dcarve/tg-robot/README.md

# Links potencialmente úteis

## Papers
 - [Design and implementation Raspberry Pi-based omni-wheel mobile robot](https://www.researchgate.net/publication/304291895_Design_and_implementation_Raspberry_Pi-based_omni-wheel_mobile_robot)

- [Dynamical Models for Omni-directional Robots with 3 and 4 Wheels](https://www.researchgate.net/publication/256089847_Dynamical_Models_for_Omni-directional_Robots_with_3_and_4_Wheels)

- [DESIGN OF AN OMNIDIRECTIONAL ROBOT FOR FIRA ROBOSOT](https://www.researchgate.net/publication/264841048_DESIGN_OF_AN_OMNIDIRECTIONAL_ROBOT_FOR_FIRA_ROBOSOT)

- [A motion control method for omni-directional mobile robots based on anisotropy](https://robolab.sjtu.edu.cn/kindeditor/Upload/file/20170830/20170830143750_1858.pdf)

- [A Nonlinear programming method for time-optimal control of an omni-directional mobile robot](http://libwri.nhu.edu.tw:8081/Ejournal/AI01002305.pdf)

- [Dynamic control model of a cobot with three omni-wheels](https://www-sciencedirect.ez42.periodicos.capes.gov.br/science/article/pii/S0736584510000736)

- [2D path control of four omni wheels mobile platform with compass and gyroscope sensors](https://pdf.sciencedirectassets.com/271352/1-s2.0-S0924424715X00136/1-s2.0-S0924424715301291/main.pdf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)

- [SIMPLIFIED CONTROLLER FOR A THREE WHEELED OMNI DIRECTIONAL MOBILE ROBOT](https://eds.p.ebscohost.com/eds/pdfviewer/pdfviewer?vid=0&sid=e32e85bf-04d3-4e8c-8876-cb36a72d98c3%40redis)

- [Modelagem Cinemática e Dinâmica](http://www.ece.ufrgs.br/~fetter/ele00070/mobrob/model.pdf)

- [Motion Planning for Omnidirectional Wheeled Mobile Robot by Potential Field Method](https://www.hindawi.com/journals/jat/2017/4961383/)

- [Motion Analysis of A Mobile Robot With Three Omni-Directional Wheels](https://ijiset.com/vol2/v2s11/IJISET_V2_I11_84.pdf)

- [DYNAMICAL MODELS FOR OMNI-DIRECTIONAL ROBOTS WITH 3 AND 4 WHEELS](https://www.scitepress.org/Papers/2008/14892/14892.pdf)

- [Holonomic Implementation of Three Wheels Omnidirectional Mobile Robot using DC Motors](https://pdfs.semanticscholar.org/ed22/2105a1e4c42d64c207bcc55dec5aacd70275.pdf)

## Youtube
- [DC motor PID speed control](https://www.youtube.com/watch?v=HRaZLCBFVDE)

- [How to control a DC motor with an encoder](https://www.youtube.com/watch?v=dTGITLnYAY0)
  
- [How to control multiple DC motors with encoders](https://www.youtube.com/watch?v=3ozgxPi_tl0)

## Artigo internet

- [Motor DC com Driver Ponte H L298N](https://www.filipeflop.com/blog/motor-dc-arduino-ponte-h-l298n/)
  
- [Como usar motor DC com encoder no Arduino](https://www.arduinoecia.com.br/motor-dc-com-encoder-arduino/)

## Componentes

- [Motor DC 6V com Encoder](https://www.filipeflop.com/produto/motor-dc-6v-com-encoder/)
  
- [Driver Motor Ponte H L298n](https://www.filipeflop.com/produto/driver-motor-ponte-h-l298n/)

- [STM32F103C8](https://stm32-base.org/boards/STM32F103C8T6-Blue-Pill.html)

## Recomenrações de TG e Documentação Latex ABNT

- [Estilos bibliográficos compatíveis com a ABNT NBR 6023](https://linorg.usp.br/CTAN/macros/latex/contrib/abntex2/doc/abntex2cite.pdf)
- [Github exemplo latex abnt](https://github.com/abntex/abntex2/blob/master/doc/latex/abntex2/examples/abntex2-modelo-trabalho-academico.tex)
- [Documentos técnicos e científicos brasileiros compatíveis com as normas ABNT](https://linorg.usp.br/CTAN/macros/latex/contrib/abntex2/doc/abntex2.pdf)
- [RECOMENDAÇÕES PARA ELABORAÇÃO DA MONOGRAFIA DO TRABALHO DE GRADUAÇÃO (TG)](https://i0.statig.com.br/educacao/trabalhosacademicos/Recomendacoes_elaboracao_monografia.pdf)
- [Como fazer uma revisão sistemática de literatura?](https://blog.mettzer.com/revisao-sistematica/)

file:///C:/Users/daniel%20carvalho/Desktop/2018-Jeba-2.pdf

## patents

https://worldwide.espacenet.com/patent/search/family/003373065/publication/US1305535A?q=pn%3DUS1305535

https://worldwide.espacenet.com/patent/search/family/022923089/publication/US3789947A?q=pn%3DUS3789947

https://www.embarcados.com.br/introducao-ao-microcontrolador-arm-cortex-m3/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

https://www.vexrobotics.com/omni-wheels.html#attr-vex_drawings

https://he.aliexpress.com/item/32842600463.html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

https://he.aliexpress.com/item/32825873010.html?gatewayAdapt=glo2isr

https://www.alibaba.com/product-detail/Chihai-Motor-CHR-GM25-370-ABHL_62101113849.html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

https://www.banggood.com/pt/CHIHAI-MOTOR-6V-210RPM-Encoder-Motor-DC-Gear-Motor-with-Mounting-Bracket-and-Wheel-p-1044064.html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

https://www.youtube.com/watch?v=jTIRUXJKMX4

https://www.banggood.com/pt/CHIHAI-MOTOR-6V-210RPM-Encoder-Motor-DC-Gear-Motor-with-Mounting-Bracket-and-Wheel-p-1044064.html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

https://howtomechatronics.com/tutorials/arduino/arduino-dc-motor-control-tutorial-l298n-pwm-h-bridge/

http://www.ijsrp.org/research-paper-1118/ijsrp-p8321.pdfqq

https://www.rugged-circuits.com/the-motor-driver-myth

https://manuals.plus/bluetooth-module/bluetooth-jdy-18-4-2-ble-module-usage-manual#axzz7SX8YVBt9

https://www.ti.com/lit/ds/symlink/drv8825.pdf

https://capsistema.com.br/index.php/2022/05/31/como-controlar-um-motor-de-passo-com-driver-drv8825-e-arduino/	

https://www.crescerengenharia.com/post/tudo-sobre-drv8825

https://www.valuekart.in/motors/835-chihai-motor-gm25-370-dc-gear-motor-6v-100-210-300rpm-encoder-motor.html
https://github.com/markjay4k/Audio-Spectrum-Analyzer-in-Python
https://github.com/curiores/ArduinoTutorials

https://github.com/RobTillaart/DRV8825
https://www.youtube.com/watch?v=zOByx3Izf5U

https://www.crescerengenharia.com/post/tudo-sobre-drv8825
