dcarve/tg-robot/latex_doc/TGIII/main.tex

% !TeX root = ..\TGIII\main.tex
\input{config/config_class.tex}

% Início do documento
\begin{document}

\include{abntex2-modelo-include-comandos}

% Seleciona o idioma do documento (conforme pacotes do babel)
\selectlanguage{brazil}

% Retira espaço extra obsoleto entre as frases.
\frenchspacing 

% ELEMENTOS PRÉ-TEXTUAIS

	% Capa
	\imprimircapa

	% Folha de rosto
	% (o * indica que haverá a ficha bibliográfica)
	\imprimirfolhaderosto*

	% inserir lista de ilustrações
	\pdfbookmark[0]{\listfigurename}{lof}
	\listoffigures*
	\cleardoublepage

	% inserir lista de tabelas
	\pdfbookmark[0]{\listtablename}{lot}
	\listoftables*
	\cleardoublepage

	% inserir lista de abreviaturas e siglas

	\begin{siglas}
		\item[ADC] Analog to Digital Converter
		\item[DAC] Digital to Analog converter
		\item[I2C] Inter-Integrated Circuit
		\item[USART] Universal Synchronous Asynchronous Receiver Transmitter
		\item[UART] Universal Asynchronous Receiver Transmitter
		\item[I2S] Integrated Inter-IC Sound
		\item[PWM] Pulse Width Modulation
		\item[SPI] Serial Peripheral Interface
		\item[USB 2.0] Universal Serial Bus 2.0
		\item[ESP32] Após a subseção \ref{ESP32_referencia}, refere-re à placa ESP32 Devkit v1
		\item[STM32] Após a subseção \ref{STM32_referencia}, refere-re à placa BluePill
		\item[IDE] Integrated Development Environment
	\end{siglas}

	% inserir o sumario
	\pdfbookmark[0]{\contentsname}{toc}
	\tableofcontents*
	\cleardoublepage

% ELEMENTOS TEXTUAIS
\textual

	\input{chapters/introducao.tex}

	\input{chapters/objetivos.tex}

	\input{chapters/metodologia.tex}
	
	\input{chapters/resultados_e_discussao.tex}

	\phantompart

% ELEMENTOS PÓS-TEXTUAIS
\postextual

	% Referências bibliográficas

	\input{apendices/apendices_class.tex}
	
	\bibliography{bibliography/bibliografia.bib}
	%\printbibliography

	% Glossário
	%\input{glossary/glossary_class.tex}

	% Apêndices

	% Anexos
	% \begin{anexosenv}
	% \partanexos
	% \input{attachments/medicoes_motores.tex}
	% \end{anexosenv}

%---------------------------------------------------------------------
% INDICE REMISSIVO
%---------------------------------------------------------------------
\phantompart
\printindex

\end{document}
