dcarve/tg-robot/latex_doc/TGII/main.tex

\input{config/config_class.tex}

% Início do documento
\begin{document}

% Seleciona o idioma do documento (conforme pacotes do babel)
%\selectlanguage{english}
\selectlanguage{brazil}

% Retira espaço extra obsoleto entre as frases.
\frenchspacing 

% ELEMENTOS PRÉ-TEXTUAIS
	\input{pre_textual/pretextual_class.tex}

% ELEMENTOS TEXTUAIS
\textual

	% Introdução (exemplo de capítulo sem numeração, mas presente no Sumário)
	\chapter{Introdução}

	\input{chapters/cap_1_introduction.tex}

	% Capitulo com exemplos de comandos inseridos de arquivo externo 
	\include{abntex2-modelo-include-comandos}
	
	\input{chapters/cap_2_objetivos.tex}

	\input{chapters/cap_3_revisao_bibliografica.tex}

	\input{chapters/cap_4_metodologia.tex}
	
	\input{chapters/cap_5_desenvolvimento.tex}

	\input{chapters/cap_6_proximos_etapas.tex}

	% ----------------------------------------------------------
	% Finaliza a parte no bookmark do PDF
	% para que se inicie o bookmark na raiz
	% e adiciona espaço de parte no Sumário
	% ----------------------------------------------------------
	\phantompart

	% Conclusão
	%\input{chapters/conclusion.tex}

% ELEMENTOS PÓS-TEXTUAIS
\postextual

	% Referências bibliográficas
	% \input{bibliography/bibliography.tex}
	\bibliography{bibliography/bibliografia.bib}
	%\printbibliography

	% Glossário
	%\input{glossary/glossary_class.tex}

	% Apêndices
	%\input{apendices/apendices_class.tex}

	% Anexos
	\begin{anexosenv}
	\partanexos
	\input{attachments/medicoes_motores.tex}
	\input{attachments/filtro_passa_baixa_deducao.tex}
	\input{attachments/fabricacao.tex}
	\input{attachments/limpeza_dados_python.tex}
	\input{attachments/matlab_polymonio.tex}
	\end{anexosenv}

%---------------------------------------------------------------------
% INDICE REMISSIVO
%---------------------------------------------------------------------
\phantompart
\printindex

\end{document}
