dcarve/tg-robot/latex_doc/TGIII/chapters/metodologia.tex

\chapter{Metodologia}

\input{chapters/metodologia/algoritimo_movimento.tex}
\input{chapters/metodologia/roda_omni_directiona.tex}
\input{chapters/metodologia/microcontrolador.tex}
\input{chapters/metodologia/comunicacao.tex}
\input{chapters/metodologia/motores.tex}
\input{chapters/metodologia/drivers.tex}
\input{chapters/metodologia/alimentacao.tex}
\input{chapters/metodologia/fabricacao.tex}
\input{chapters/metodologia/seguranca.tex}
