dcarve/tg-robot/latex_doc/TGIII/chapters/objetivos.tex

\chapter{Objetivos}

\subsection*{Gerais}
Este trabalho tem como objetivos gerais avaliar a viabilidade da utilização de 
um robô omnidirecional de três rodas controlado por microcontrolador para 
atuação em ambiente interno.

\subsection*{Específicos}
Deseja-se realizar a construção de um robô a partir de diversos componentes 
(motor, microcontrolador, rodas, driver, chassi, entre outros), e também 
implementar rotina de controle remoto que permita a operação do robô a partir de 
comandos via smartphone.
