dcarve/tg-robot/latex_doc/TGII/chapters/cap_3_revisao_bibliografica.tex

\chapter{Revisão Bibliográfica}

\section{Veículo omnidirecional de 3 rodas}
\input{chapters/cap3_revisao_bibliografica/section_veiculo_omnidirecional.tex}

\section{Roda Omnidirecional}
\input{chapters/cap3_revisao_bibliografica/section_roda_omnidirecional.tex}

\section{Motor DC com encoder e driver para motor}
\input{chapters/cap3_revisao_bibliografica/section_motor_dc.tex}

\section{Microcontrolador STM32}
\input{chapters/cap3_revisao_bibliografica/section_microcontrolador.tex}

\section{IDE}
\input{chapters/cap3_revisao_bibliografica/section_atollic.tex}

\section{CAD - Design auxiliado por computador}
\input{chapters/cap3_revisao_bibliografica/section_cad.tex}

\section{Impressão 3D de filamento - Manufatura Aditiva}
\input{chapters/cap3_revisao_bibliografica/section_3d_impression.tex}
