dcarve/tg-robot/latex_doc/TGII/attachments/medicoes_motores.tex

\chapter{Medição de velocidade dos motores}
\label{att_medicao_motores}

\begin{figure}[ht]
	\centering
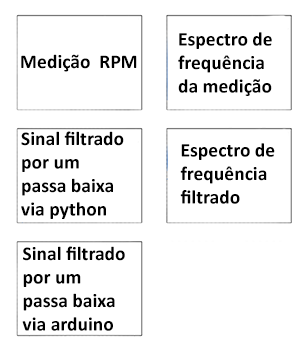
[picture p13: latex_doc/TGIII/figures/explicacao_quadros.png]
	
	\caption{Explicação de cada quadro nas figuras a seguir}
	\label{fig:explicacao_quadros}
\end{figure}

\begin{figure}[ht]
	\centering
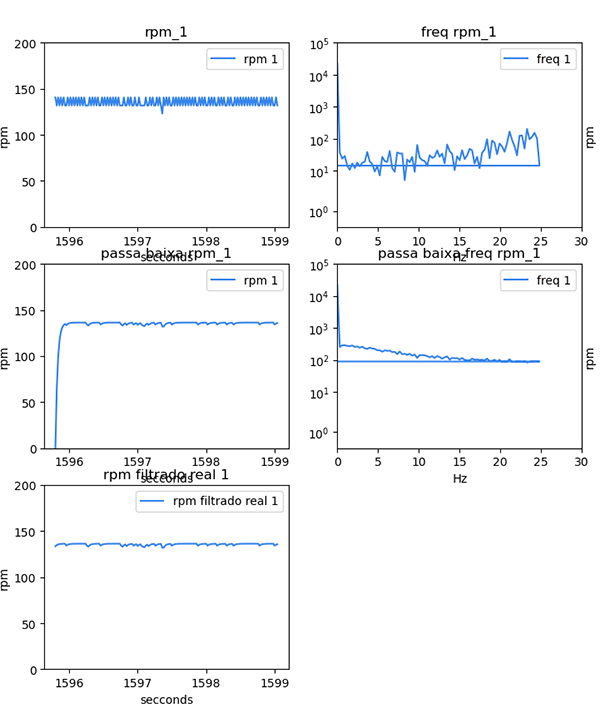
[picture p14: latex_doc/TGII/figures/medidas_motor_1.png]
	
	\caption{Medidas Motor 1}
	\label{fig:medidas_motor_1}
\end{figure}

\begin{figure}[ht]
	\centering
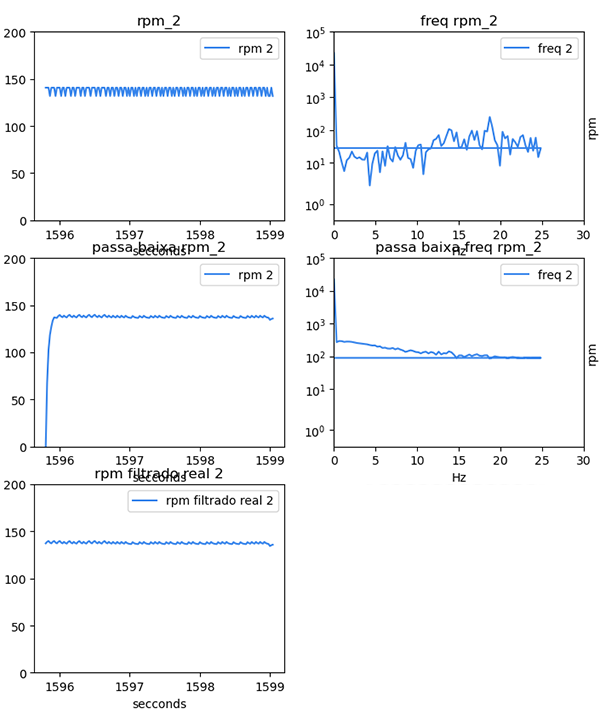
[picture p15: latex_doc/TGII/figures/medidas_motor_2.png]
	
	\caption{Medidas Motor 2}
	\label{fig:medidas_motor_2}
\end{figure}

\begin{figure}[ht]
	\centering
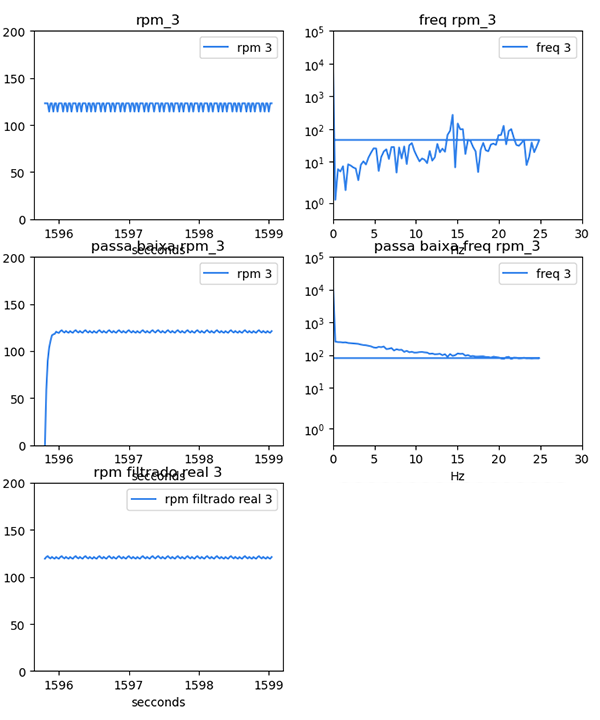
[picture p16: latex_doc/TGII/figures/medidas_motor_3.png]
	
	\caption{Medidas Motor 3}
	\label{fig:medidas_motor_3}
\end{figure}
