dcarve/tg-robot/latex_doc/TGII/attachments/matlab_polymonio.tex

\chapter{Limpeza dos dados realizada no python}
\label{att_matlab}

Matlab
\lstset{language=Matlab}
\begin{lstlisting}
    T = readtable('amostra_invertida.csv');
    filter_rpm_mean =  T{:,1};
    w =  T{:,2};
    f=fit(filter_rpm_mean,w,'poly4')

    f = 
    
         Linear model Poly4:
         f(x) = p1*x^4 + p2*x^3 + p3*x^2 + p4*x + p5
         Coefficients (with 0.95 confidence bounds):
           p1 =   0.0001131  (9.732e-05, 0.0001288)
           p2 =    -0.03064  (-0.0375, -0.02377)
           p3 =       2.993  (1.999, 3.988)
           p4 =      -1.257  (-54.15, 51.63)
           p5 =        9017  (8235, 9798)

\end{lstlisting}
