dcarve/tg-robot/latex_doc/TGI/chapters/cap_2_objetivos.tex

\chapter{Objetivos}

\subsection*{Gerais}
Este trabalho tem como objetivos gerais avaliar a viabilidade da utilização de 
um robô omnidirecional de três rodas controlado por microcontrolador para 
atuação independente em ambiente interno.

\subsection*{Específicos}
Deseja-se realizar a construção de um robô a partir de diversos componentes 
(motor, microcontrolador, rodas, driver, chassi, entre outros), e também 
implementar rotina de controle que permita ao robô receber como entrada mapa
do ambiente em que se encontra, de modo que seja capaz de nele se mover de 
acordo com as rotinas desejadas.
