dcarve/tg-robot/latex_doc/TGI/attachments/attachments_class.tex

\begin{anexosenv}

% Imprime uma página indicando o início dos anexos
\partanexos

%\input{attachments/deducao_calculo.tex}
\input{attachments/outro_anexo.tex}

\end{anexosenv}
