dcarve/tg-robot/3_whell_robot/doc/chapters/capitulo_2.tex

\section{Componentes}

\begin{quadro}[htb]
\caption{\label{lista de componentes}Componentes}
 \begin{tabular}{|c|c|c|c|}
	\hline
	\textbf{Componente} & \textbf{Quant} \\ \hline
	Motor DC 6V,  210 RPM, encoder integrado & 3  \\ \hline
	Driver Motor Ponte H L298n  & 3  \\ \hline
	Raspberry Pi 4    & 1   \\ \hline
	STM32 F103C8T6 & 2     \\ \hline
	Bateria & 1     \\ \hline
\end{tabular}
\fonte{Autor.}
\end{quadro}

%https://www.filipeflop.com/produto/driver-motor-ponte-h-l298n/
%https://www.filipeflop.com/produto/motor-dc-6v-com-encoder/?attribute_pa_rpm=210-rpm#tab-description
