dcarve/tg-robot/latex_doc/TGIII/chapters/metodologia/motores.tex

\section{Motores}  \label{secao_motores}

\lipsum[1]
