dcarve/tg-robot/latex_doc/TGI/chapters/cap3_revisao_bibliografica/section_microcontrolador.tex

STM32 é uma família de microcontroladores de 32-bits fabricados
pela STMicroelectronics. Possuem como porcessadores o ARM Cortex, baseados em arquitetura Harvard, de 32-bits. 
os microcontroladores STM32 fornece base para uma uma grande variedades de
sistemas embarcados, e com custo inferior e maior flexibilidade quando comparado
ao Arduino com ATmega, que possui microcontroladores de 8 a 16bits. Contudo,
essa flexibilidade e baixo custo têm como contrapartida o requerimento de um
maior nível de experiência em programação C do que o necessário para
desenvolver as mesmas soluções em Arduino (cuja concepção teve como objetivo
maior acessibilidade para iniciantes \cite{cortex_m3}).
