dcarve/tg-robot/latex_doc/TGIII/config/config_class.tex

\documentclass[
	% -- opções da classe memoir --
	12pt,				% tamanho da fonte
	openright,			% capítulos começam em pág ímpar (insere página vazia caso preciso)
	oneside,			% para impressão em recto e verso. Oposto a oneside
	a4paper,			% tamanho do papel. 
	% -- opções da classe abntex2 --
	%chapter=TITLE,		% títulos de capítulos convertidos em letras maiúsculas
	%section=TITLE,		% títulos de seções convertidos em letras maiúsculas
	%subsection=TITLE,	% títulos de subseções convertidos em letras maiúsculas
	%subsubsection=TITLE,% títulos de subsubseções convertidos em letras maiúsculas
	% -- opções do pacote babel --
	english,			% idioma adicional para hifenização
	french,				% idioma adicional para hifenização
	spanish,			% idioma adicional para hifenização
	brazil				% o último idioma é o principal do documento
	]{abntex2}

% Pacotes básicos 
\usepackage{lmodern}			% Usa a fonte Latin Modern			
\usepackage[T1]{fontenc}		% Selecao de codigos de fonte.
\usepackage[utf8]{inputenc}		% Codificacao do documento (conversão automática dos acentos)
\usepackage{indentfirst}		% Indenta o primeiro parágrafo de cada seção.
\usepackage{color}				% Controle das cores
\usepackage{graphicx}			% Inclusão de gráficos
\usepackage{microtype} 			% para melhorias de justificação
\usepackage{amsmath}			% lib para equacoes
\usepackage{svg}
%\usepackage{float}
\usepackage[T1]{fontenc}
\usepackage{listings}
\usepackage{textcomp}
\usepackage{tikz}
\usepackage{caption}
\usepackage{url}

\usepackage{titlesec}
\newcommand{\sectionbreak}{\clearpage}
\usepackage{hyperref}

\usetikzlibrary{shapes.geometric, arrows}

\tikzstyle{startstop} = [rectangle, rounded corners, 
minimum width=3cm, 
minimum height=1cm,
text centered, 
draw=black, 
fill=red!30]

\tikzstyle{io} = [trapezium, 
trapezium stretches=true, % A later addition
trapezium left angle=70, 
trapezium right angle=110, 
minimum width=3cm, 
minimum height=1cm, text centered, 
draw=black, fill=blue!30]

\tikzstyle{process} = [rectangle, 
minimum width=3cm, 
minimum height=1cm, 
text centered, 
text width=3cm, 
draw=black, 
fill=orange!30]

\tikzstyle{decision} = [diamond, 
minimum width=3cm, 
minimum height=1cm, 
text centered, 
draw=black, 
fill=green!30]
\tikzstyle{arrow} = [thick,->,>=stealth]

\definecolor{dkgreen}{rgb}{0,0.6,0}
\definecolor{gray}{rgb}{0.5,0.5,0.5}
\definecolor{mauve}{rgb}{0.58,0,0.82}

\lstset{frame=tb,
  language=Python,
  aboveskip=3mm,
  belowskip=3mm,
  showstringspaces=false,
  columns=flexible,
  basicstyle={\small\ttfamily},
  numbers=none,
  numberstyle=\tiny\color{gray},
  keywordstyle=\color{blue},
  commentstyle=\color{dkgreen},
  stringstyle=\color{mauve},
  breaklines=false,
  breakatwhitespace=false,
  upquote=true,
  tabsize=3
}

% Pacotes adicionais, usados apenas no âmbito do Modelo Canônico do abnteX2

\usepackage{lipsum}				% para geração de dummy text

% Pacotes de citações
\usepackage[alf, backend=biblatex]{abntex2cite}	% Citações padrão ABNT
\usepackage[brazilian,hyperpageref]{backref}	 % Paginas com as citações na bibl

% ---
% Informações de dados para CAPA e FOLHA DE ROSTO
% ---
\titulo{Robô omnidirecional de 3 rodas}
\autor{Daniel Ermelino Carvalho \\ Lucas Pereira Lima}
\local{Brasil}
\data{2024}
\orientador{Marcelo Bender Perotoni}
\instituicao{%
  Universidade Federal do ABC
  \par
  CECS
  \par
   Engenharia de Instrumentação, Automação e Robótica}
\tipotrabalho{Trabalho de graduação}
% O preambulo deve conter o tipo do trabalho, o objetivo, 
% o nome da instituição e a área de concentração 
\preambulo{Trabalho apresentado ao curso de engenharia de instrumentação,
automação e robótica da Universidade Federal do ABC como requisito parcial para
obtenção do título de bacharel em Engenharia de Instrumentação, Automação e 
Robótica.}

% Configurações de aparência do PDF final

% alterando o aspecto da cor azul
\definecolor{blue}{RGB}{5,5,180}

% informações do PDF
\makeatletter
\hypersetup{
     	%pagebackref=true,
		pdftitle={\@title}, 
		pdfauthor={\@author},
    	pdfsubject={\imprimirpreambulo},
	    pdfcreator={LaTeX with abnTeX2},
		pdfkeywords={abnt}{latex}{abntex}{abntex2}{trabalho acadêmico}, 
		colorlinks=true,       		% false: boxed links; true: colored links
    	linkcolor=blue,          	% color of internal links
    	citecolor=blue,        		% color of links to bibliography
    	filecolor=magenta,      		% color of file links
		urlcolor=blue,
		bookmarksdepth=4
}
\makeatother

% Posiciona figuras e tabelas no topo da página quando adicionadas sozinhas
% em um página em branco. Ver https://github.com/abntex/abntex2/issues/170
\makeatletter
\setlength{\@fptop}{5pt} % Set distance from top of page to first float
\makeatother

% Possibilita criação de Quadros e Lista de quadros.
% Ver https://github.com/abntex/abntex2/issues/176

\newcommand{\quadroname}{Quadro}
\newcommand{\listofquadrosname}{Lista de quadros}

\newfloat[chapter]{quadro}{loq}{\quadroname}
\newlistof{listofquadros}{loq}{\listofquadrosname}
\newlistentry{quadro}{loq}{0}

% configurações para atender às regras da ABNT
\setfloatadjustment{quadro}{\centering}
\counterwithout{quadro}{chapter}
\renewcommand{\cftquadroname}{\quadroname\space} 
\renewcommand*{\cftquadroaftersnum}{\hfill--\hfill}

\setfloatlocations{quadro}{hbtp} % Ver https://github.com/abntex/abntex2/issues/176

% Espaçamentos entre linhas e parágrafos 

% O tamanho do parágrafo é dado por:
\setlength{\parindent}{1.3cm}

% Controle do espaçamento entre um parágrafo e outro:
\setlength{\parskip}{0.2cm}  % tente também \onelineskip

% compila o indice
\makeindex

\makeatletter
% define a macro \autorefmany to allow multiple references to be passed to \autoref
\newcommand\autorefmany[1]{\@first@ref#1,@}
\def\@throw@dot#1.#2@{#1}% discard everything after the dot
\def\@set@refname#1{%    % set \@refname to autoefname+s using \getrefbykeydefault
    \edef\@tmp{\getrefbykeydefault{#1}{anchor}{}}%
    \xdef\@tmp{\expandafter\@throw@dot\@tmp.@}%
    \ltx@IfUndefined{\@tmp autorefnameplural}%
         {\def\@refname{\@nameuse{\@tmp autorefname}s}}%
         {\def\@refname{\@nameuse{\@tmp autorefnameplural}}}%
}
\def\@first@ref#1,#2{%
  \ifx#2@\autoref{#1}\let\@nextref\@gobble% only one ref, revert to normal \autoref
  \else%
    \@set@refname{#1}%  set \@refname to autoref name
    \@refname~\ref{#1}% add autoefname and first reference
    \let\@nextref\@next@ref% push processing to \@next@ref
  \fi%
  \@nextref#2%
}
\def\@next@ref#1,#2{%
   \ifx#2@ e~\ref{#1}\let\@nextref\@gobble% at end: print and+\ref and stop
   \else, \ref{#1}% print  ,+\ref and continue
   \fi%
   \@nextref#2%
}
\makeatother

% % CONFIGURAÇÕES DE PACOTES

% % Configurações do pacote backref
% % Usado sem a opção hyperpageref de backref
% \renewcommand{\backrefpagesname}{Citado na(s) página(s):~}
% % Texto padrão antes do número das páginas
% \renewcommand{\backref}{}
% % Define os textos da citação
% \renewcommand*{\backrefalt}[4]{
% 	\ifcase #1 %
% 		Nenhuma citação no texto.%
% 	\or
% 		Citado na página #2.%
% 	\else
% 		Citado #1 vezes nas páginas #2.%
% 	\fi}%
% % ---
