dcarve/tg-robot/latex_doc/TGI/pre_textual/pretextual_class.tex

% ---
% Capa
% ---
\imprimircapa
% ---

% ---
% Folha de rosto
% (o * indica que haverá a ficha bibliográfica)
% ---
\imprimirfolhaderosto
% ---

% ---
% inserir o sumario
% ---
\pdfbookmark[0]{\contentsname}{toc}
\tableofcontents*
\cleardoublepage
% ---
