dcarve/tg-robot/miscelania/stepper_motor_calc.docx

r=revolusão

1 step=1.8°

1 step=M μ_(step)

delay=delay em segundos

1r=360° (step)/(1.8°)=200 step=200 M μ_(step)

μ_(step) = 1/(2∙delay)
