dcarve/tg-robot/miscelania/ut.docx

u(t)=k_p e(t)+k_i ∫_0^t e(t)dt+ k_d (e(t))/(dt)

int_e (k)= int_e (k-1)+ (e(k)+e(k-1))/2 ∆t

dev_e (k)= (e(k)-e(k-1))/(∆t)
