dcarve/tg-robot/miscelania/calculo.docx

V_l = V_(w1) +V_(w2) +V_(w3)

ω= (|V_(w1) |)/L+(|V_(w2) |)/L+(|V_(w3) |)/L

V_l ∡A= V_(w1) ∡-π/2+V_(w2) ∡((2π)/3-π/2)+V_(w3) ∡((4π)/3-π/2)

V_(lx) +V_(ly) = V_(w1) cos(-π/2)+jV_(w1) sin(-π/2)+V_(w2) cos(π/6)+jV_(w2) sin(π/6)+V_(w3) cos((5π)/6)+jV_(w3) sin((5π)/6)

ω= (V_(w1))/L+(V_(w2))/L+(V_(w3))/L

[V_(lx) V_(ly) ω]= [cos(π/2), cos(π/6), cos((5π)/6)sin(π/2), sin(π/6), sin((5π)/6)1/L, 1/L, 1/L]∙[V_(w1) V_(w2) V_(w3) ]

[V_(lx) V_(ly) ω]=[0, (√3)/2, -(√3)/21, -1/2, -1/21/L, 1/L, 1/L]∙[V_(w1) V_(w2) V_(w3) ]

[0, √3/2, -√3/21, -1/2, -1/21/L, 1/L, 1/L] ∙ [a, b, cd, e, fg, h, i] = [1, 0, 00, 1, 00, 0, 1]

-√(3∙)d/2+√(3∙)g/2=1a -d/2-g/2=0a/L+ d/L+g/L=0, a=0, d=1/(√3), g=-1/√3

-√3∙e/2+√3∙h/2=0b -e/2-h/2=1b/L+ e/L+h/L=0, b=2/3, e=-1/3, h=-1/3

-√3∙f/2+√3∙i/2=0c-f/2-i/2=0c/L+ f/L+i/L=1, b=L/3, e=L/3, h=L/3

[a, b, cd, e, fg, h, i]= [0, 2/3, L/31/√3,, -1/3, L/3-1/√3,, -1/3, L/3]

[0, 2/3, L/3-1/√3,, -1/3, L/31/√3,, -1/3, L/3]∙ [V_(lx) V_(ly) ω]=[V_(w1) V_(w2) V_(w3) ]

[V_(w1) V_(w2) V_(w3) ]=[0, 2/3, L/3-1/√3,, -1/3, L/31/√3,, -1/3, L/3]∙ [V∙cos⁡(θ)V∙sin⁡(θ)ω]
