dcarve/tg-robot/cad_files/imagens/acoplamento-estudo-2.png

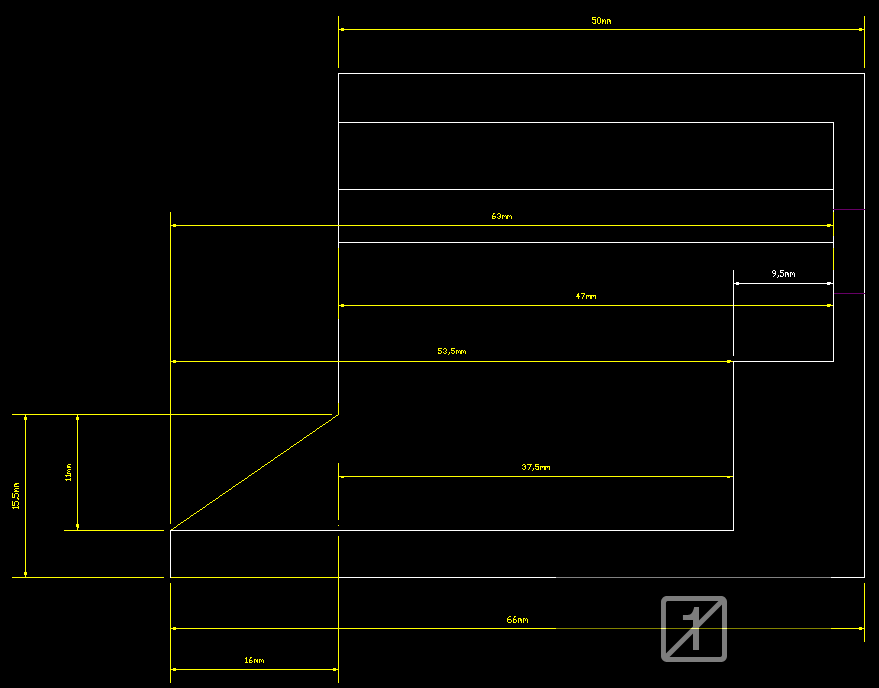
cad_files/imagens/acoplamento-estudo-2.png
