dcarve/tg-robot/cad_files/imagens/acoplamento-estudo.png

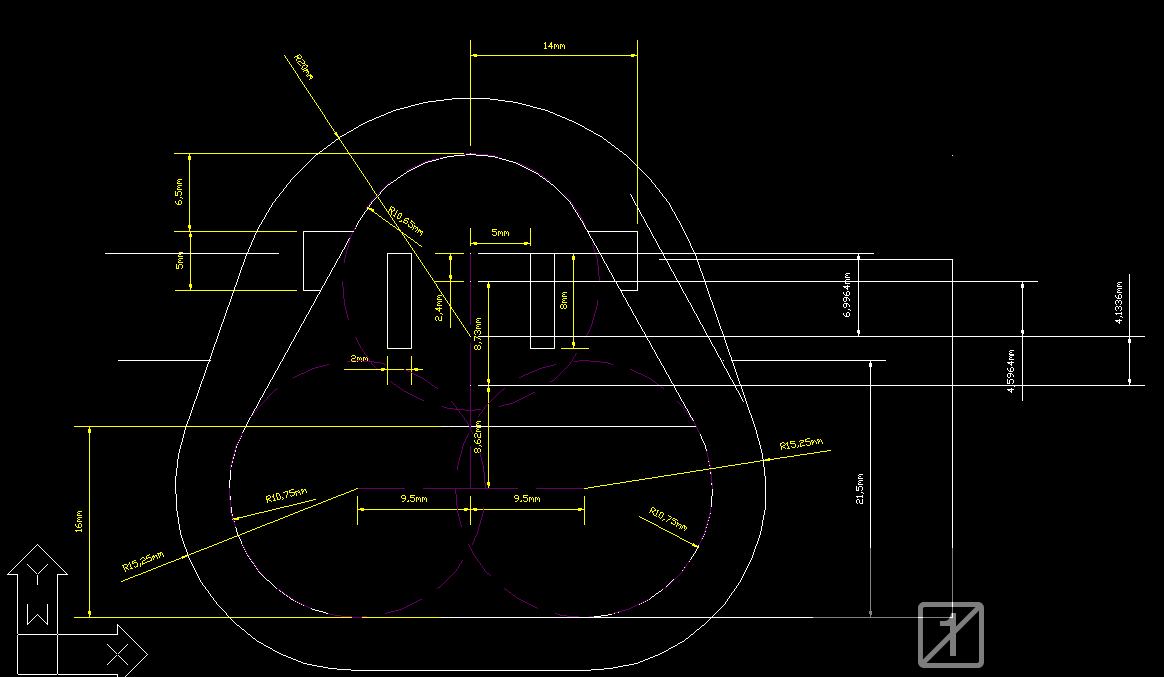
cad_files/imagens/acoplamento-estudo.png
