dcarve/tg-robot/cad_files/imagens/chassi1.png

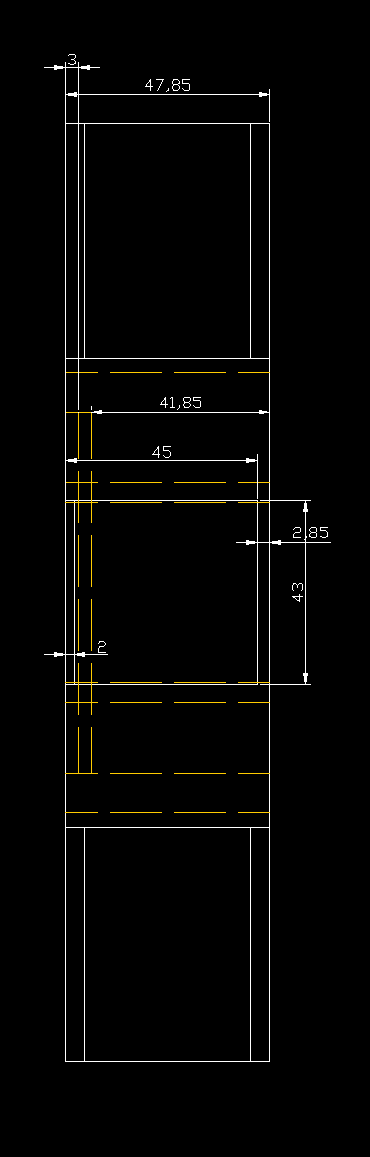
cad_files/imagens/chassi1.png
