dcarve/tg-robot/cad_files/imagens/chassi2.png

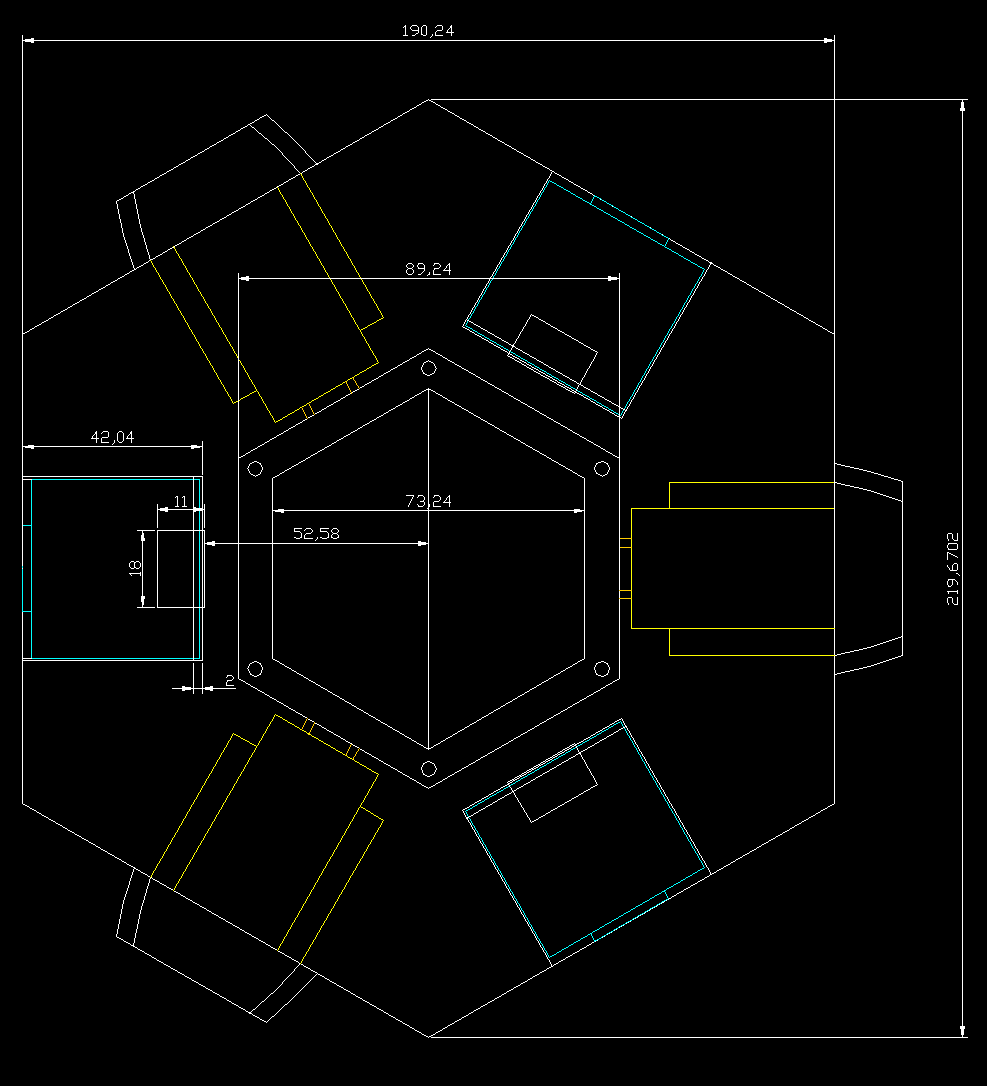
cad_files/imagens/chassi2.png
