dcarve/tg-robot/cad_files/imagens/chassi3.png

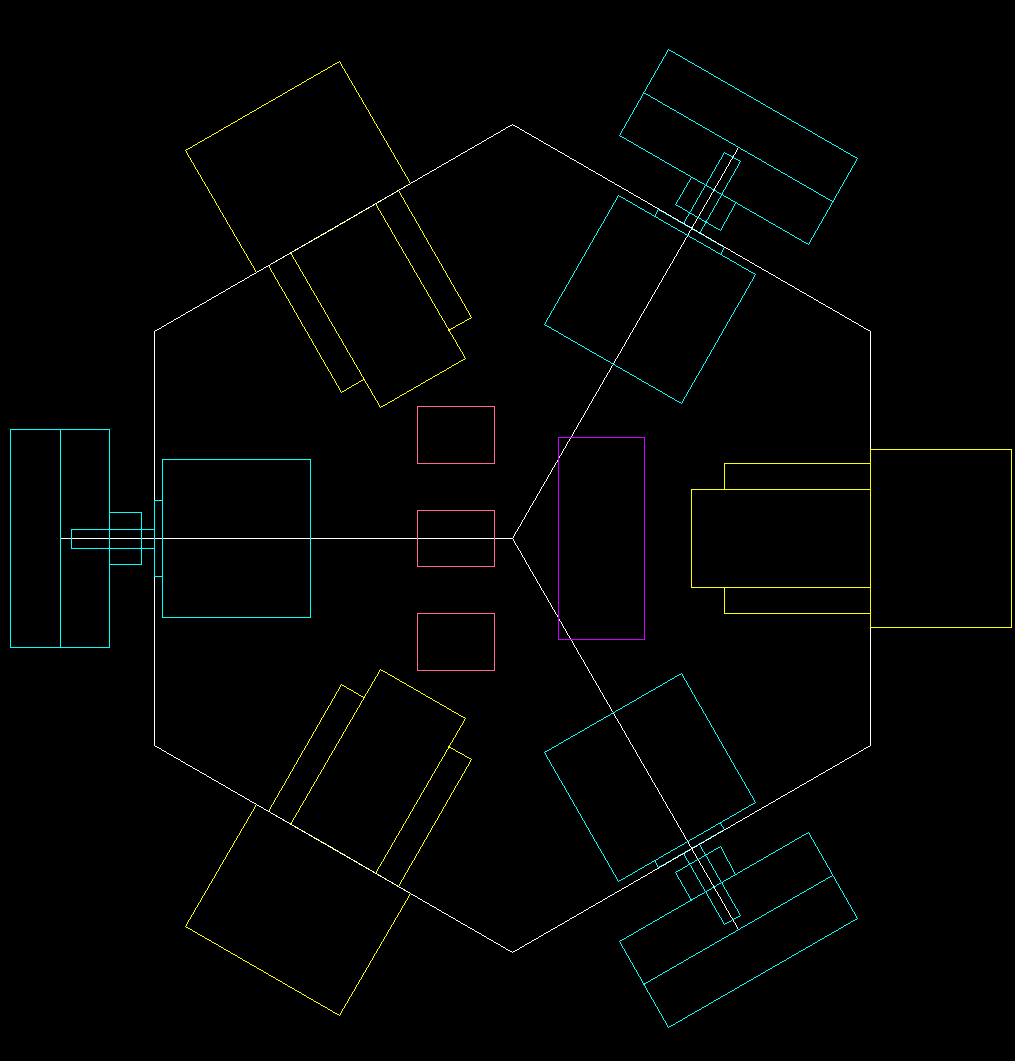
cad_files/imagens/chassi3.png
