dcarve/tg-robot/cad_files/imagens/roda1.png

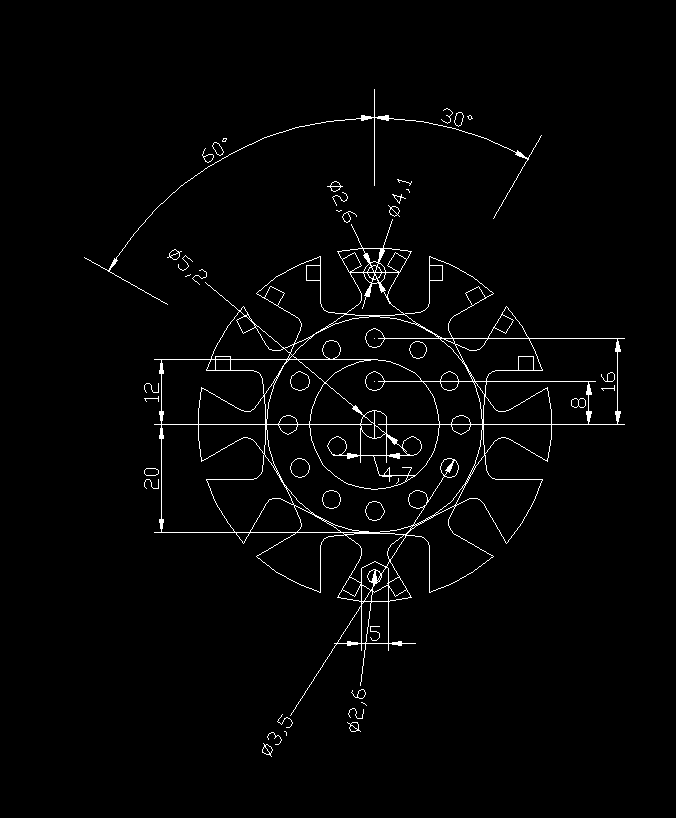
cad_files/imagens/roda1.png
