dcarve/tg-robot/cad_files/imagens/roda2.png

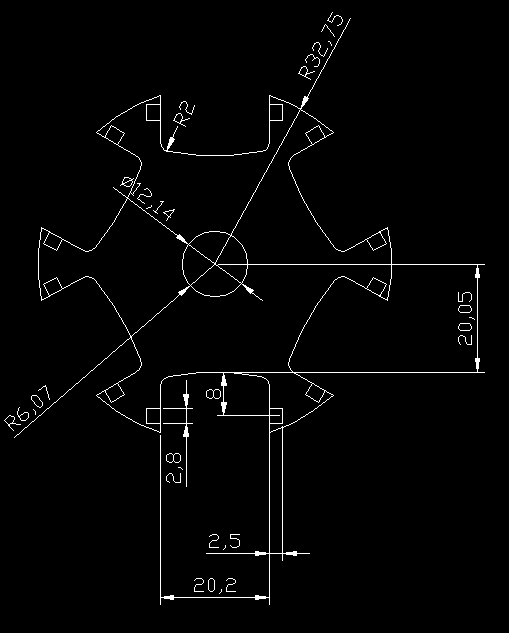
cad_files/imagens/roda2.png
