dcarve/tg-robot/cad_files/imagens/roda3.png

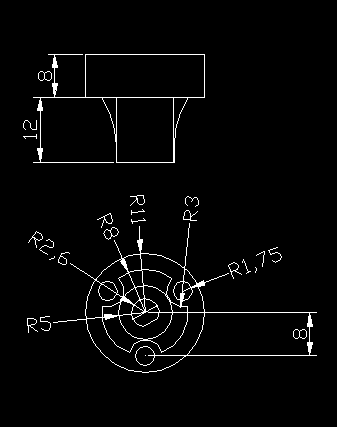
cad_files/imagens/roda3.png
