dcarve/tg-robot/latex_doc/TGI/figures/digram_model_dedution.png

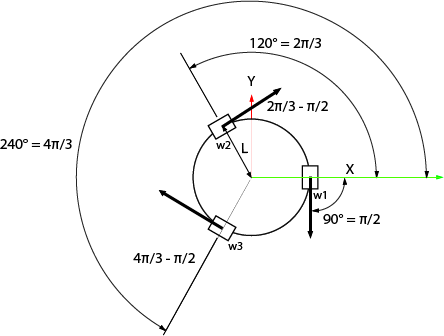
latex_doc/TGI/figures/digram_model_dedution.png
