dcarve/tg-robot/latex_doc/TGI/figures/encoder_holzer.jpg

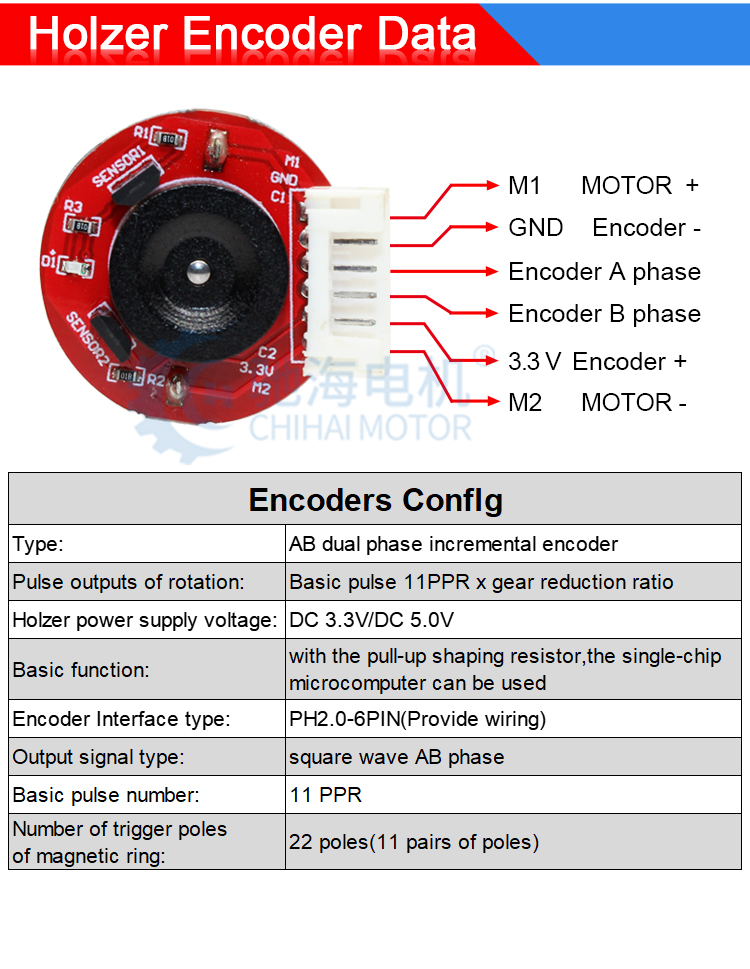
latex_doc/TGI/figures/encoder_holzer.jpg
