dcarve/tg-robot/latex_doc/TGI/figures/encoder_holzer.png

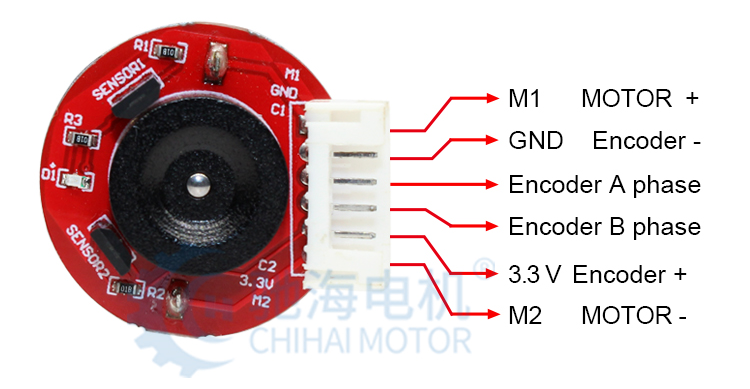
latex_doc/TGI/figures/encoder_holzer.png
