dcarve/tg-robot/latex_doc/TGI/figures/stm32f1_pinout.png

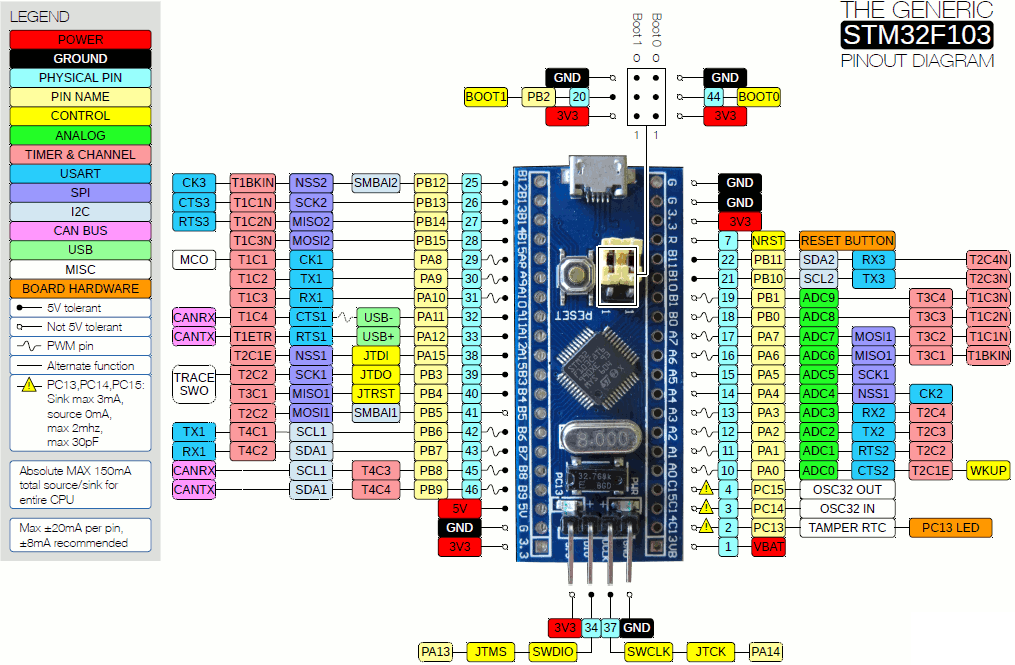
latex_doc/TGI/figures/stm32f1_pinout.png
