dcarve/tg-robot/latex_doc/TGII/figures/arduino.png

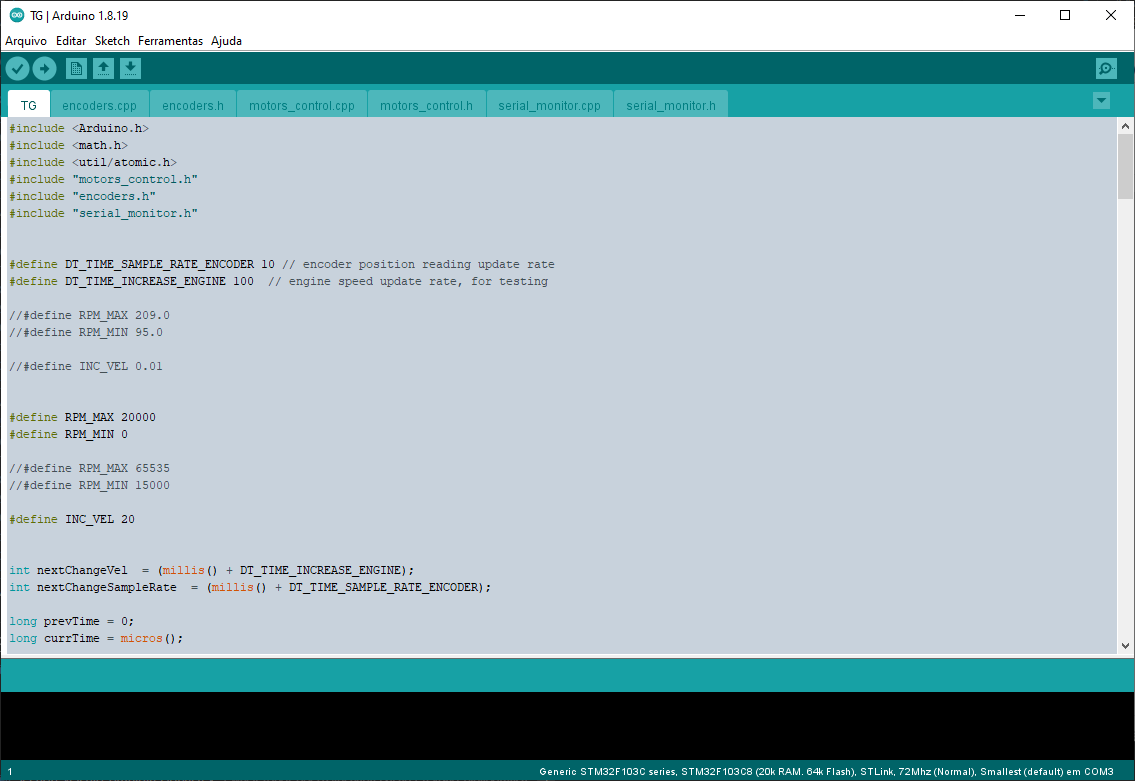
latex_doc/TGII/figures/arduino.png
