dcarve/tg-robot/latex_doc/TGII/figures/auto_cad.png

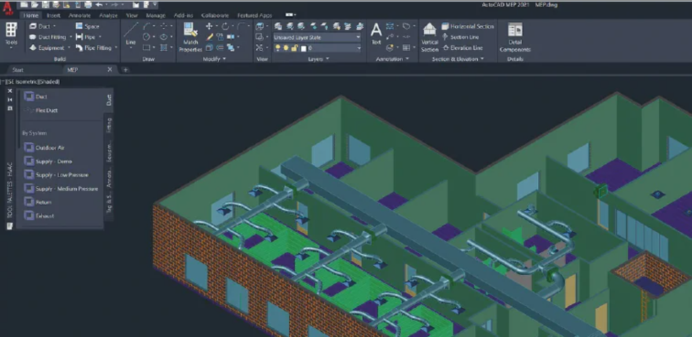
latex_doc/TGII/figures/auto_cad.png
