dcarve/tg-robot/latex_doc/TGII/figures/cad5.png

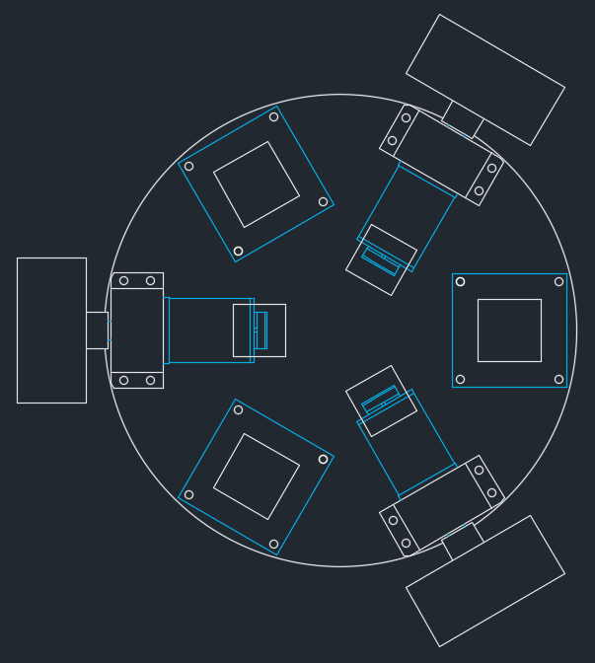
latex_doc/TGII/figures/cad5.png
