dcarve/tg-robot/latex_doc/TGII/figures/DRV8833-Dual-Driver-Pinout - Copia.png

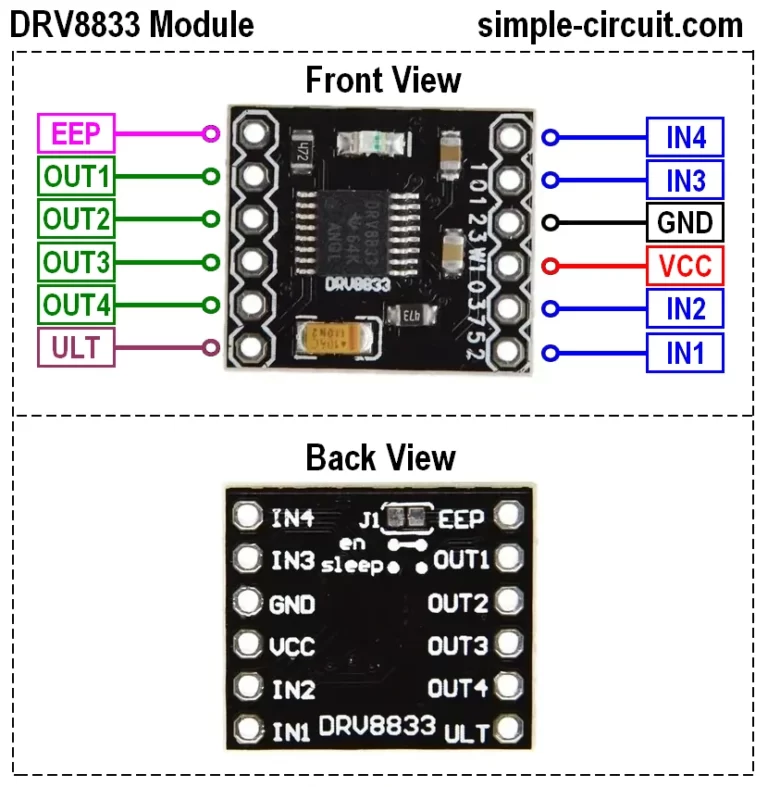
latex_doc/TGII/figures/DRV8833-Dual-Driver-Pinout - Copia.png
