dcarve/tg-robot/latex_doc/TGII/figures/frequencia_medidas_altas - Copia.png

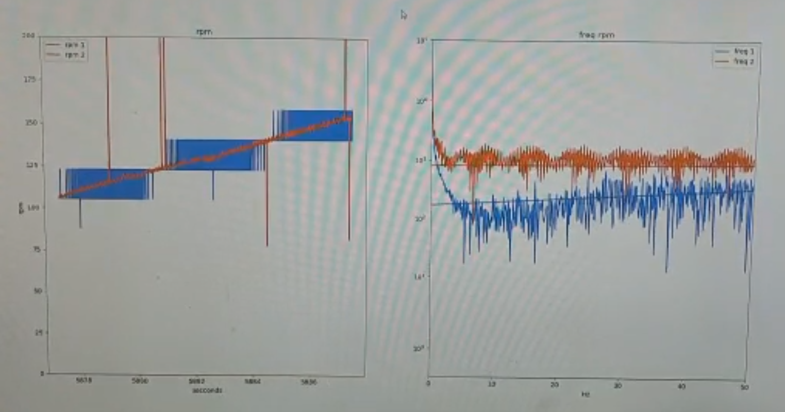
latex_doc/TGII/figures/frequencia_medidas_altas - Copia.png
