dcarve/tg-robot/latex_doc/TGII/figures/stm32f1_pinout - Copia - Copia.png

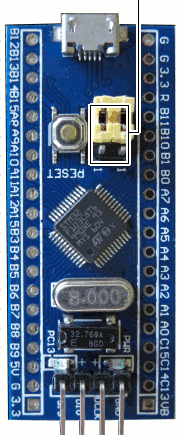
latex_doc/TGII/figures/stm32f1_pinout - Copia - Copia.png
