dcarve/tg-robot/latex_doc/TGII/figures/stm32f1_pinout.png

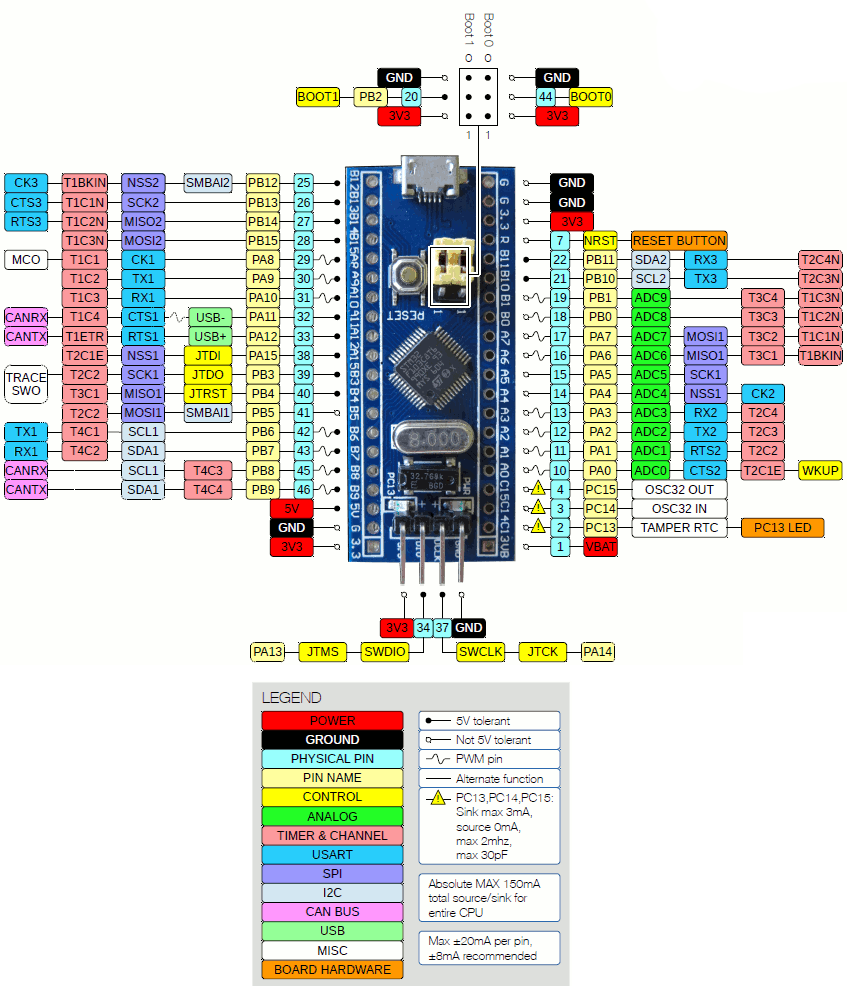
latex_doc/TGII/figures/stm32f1_pinout.png
