dcarve/tg-robot/latex_doc/TGIII/figures/20241014_223223.jpg

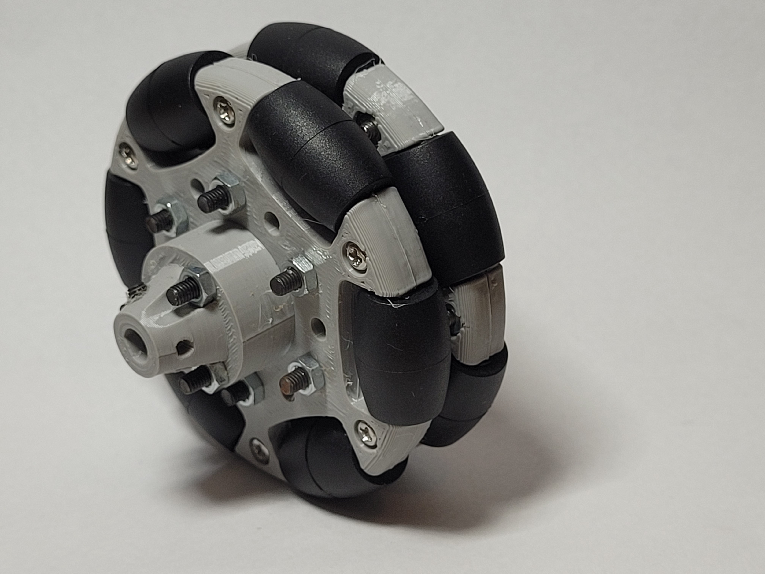
latex_doc/TGIII/figures/20241014_223223.jpg
