dcarve/tg-robot/latex_doc/TGIII/figures/app_andriod_hsl.png

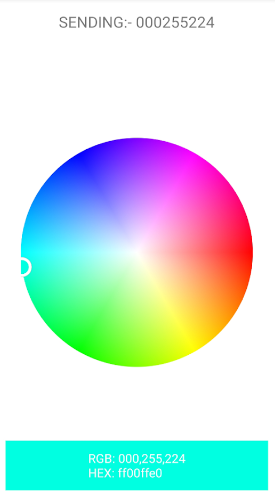
latex_doc/TGIII/figures/app_andriod_hsl.png
