dcarve/tg-robot/latex_doc/TGIII/figures/arduino.png

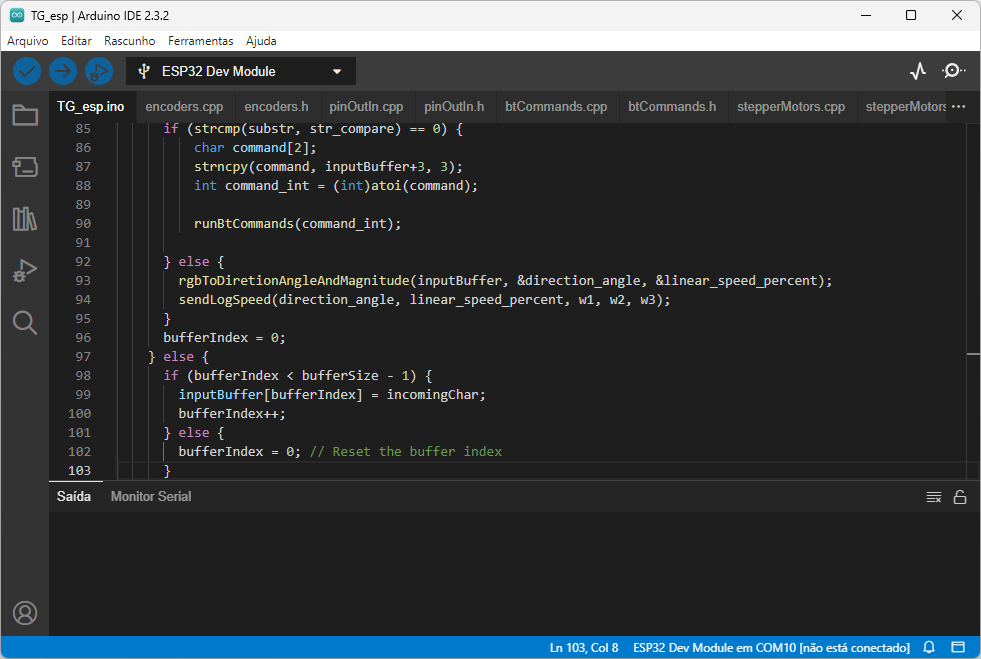
latex_doc/TGIII/figures/arduino.png
