dcarve/tg-robot/latex_doc/TGIII/figures/gba_bosch_embalagem.png

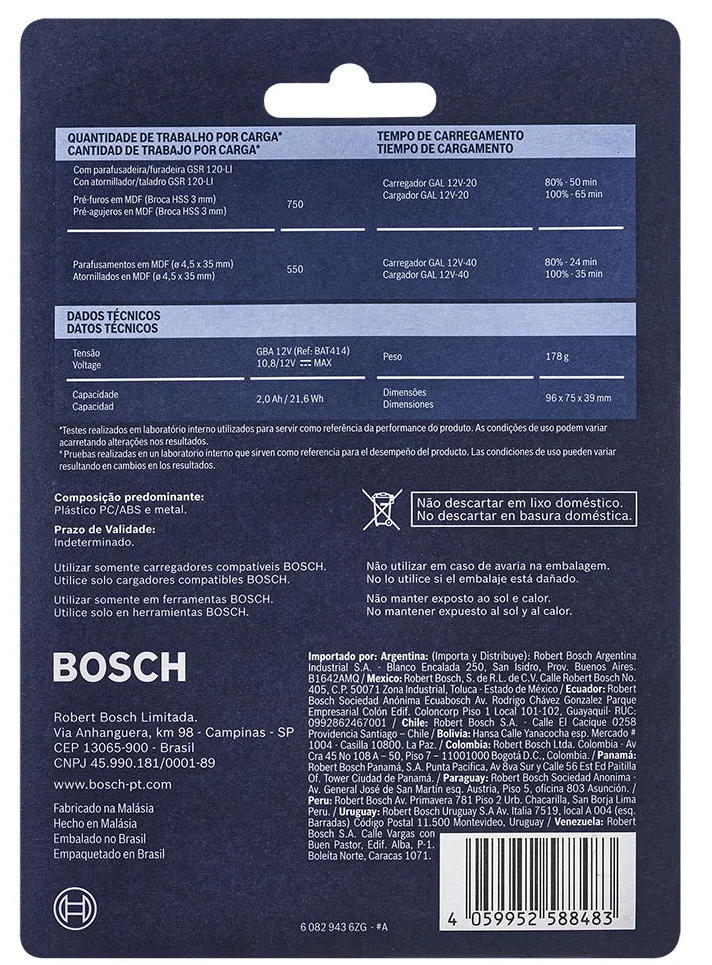
latex_doc/TGIII/figures/gba_bosch_embalagem.png
