dcarve/tg-robot/miscelania/50hz(lp5hz).png

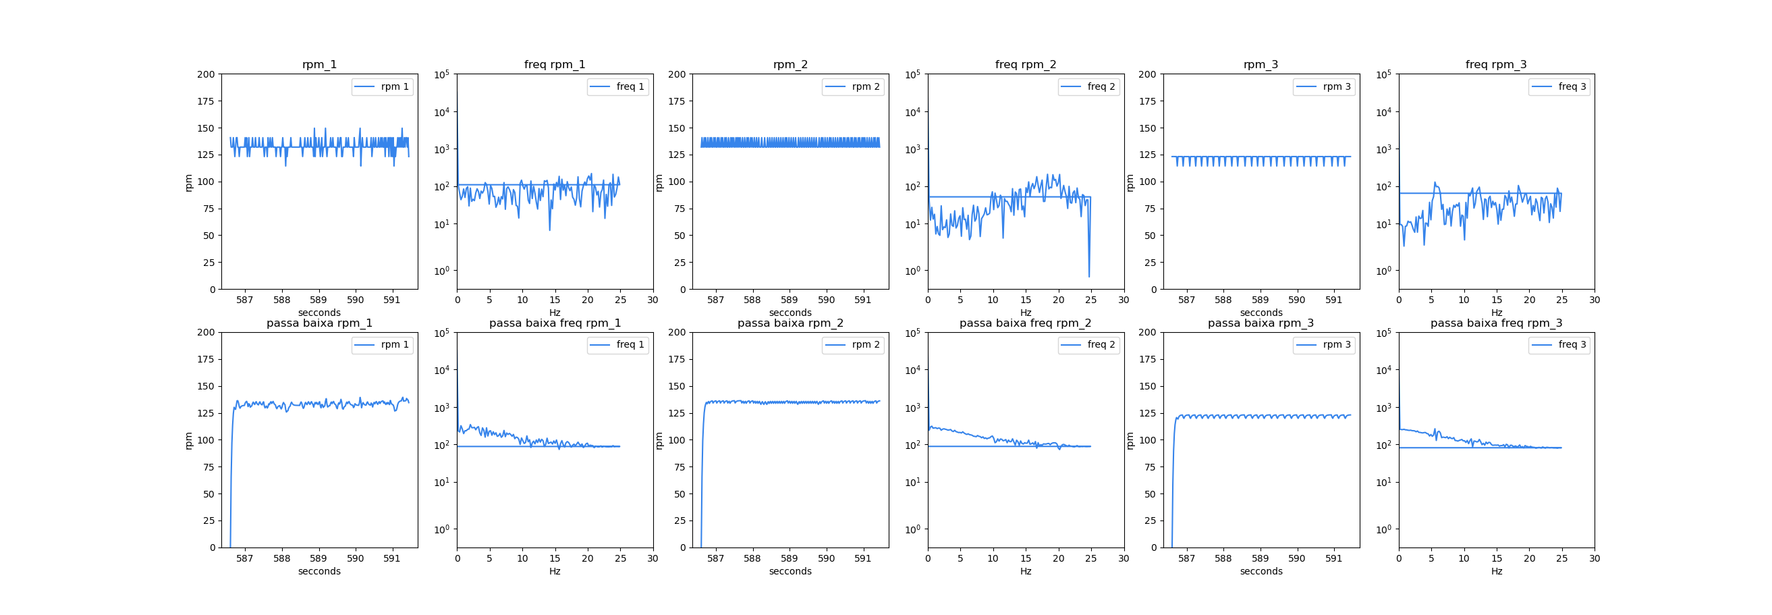
miscelania/50hz(lp5hz).png
