dcarve/tg-robot/miscelania/50hz(lp10hz).png

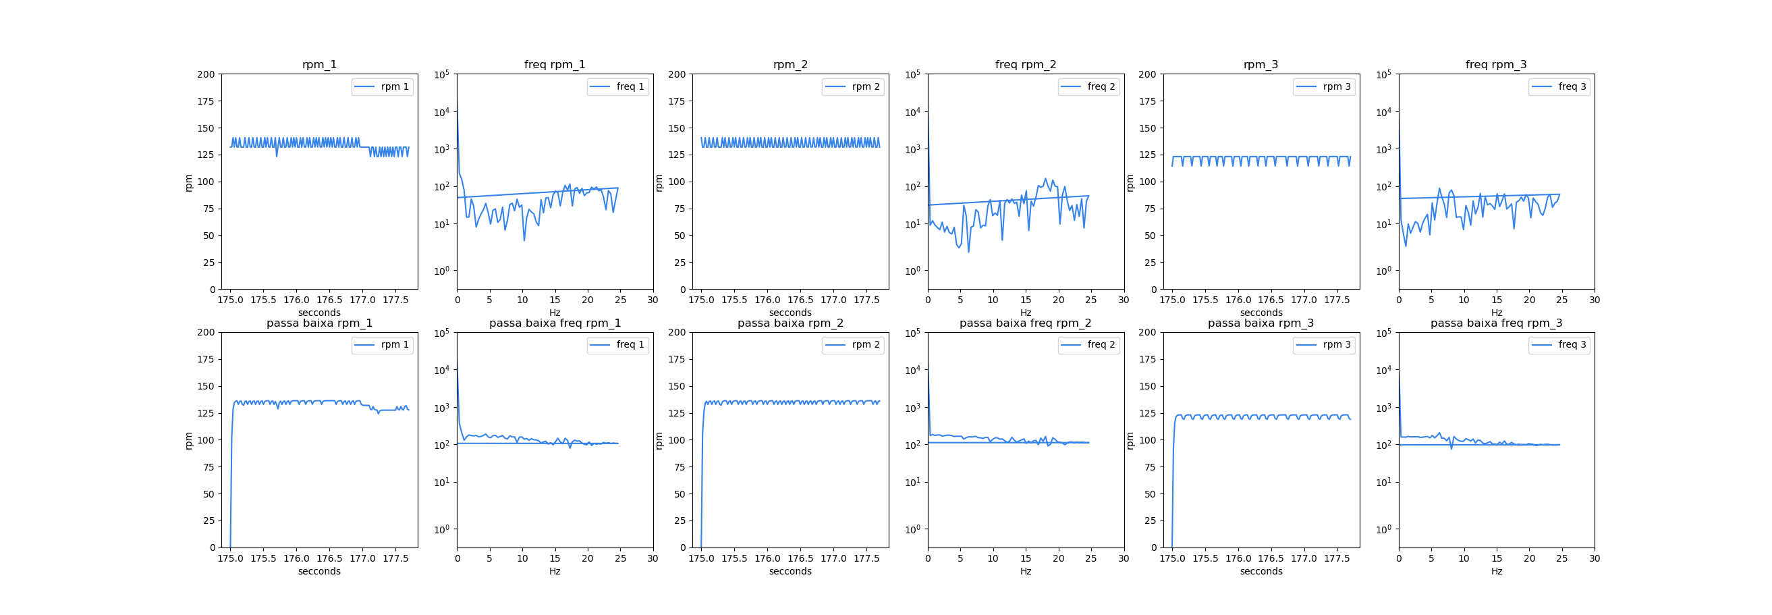
miscelania/50hz(lp10hz).png
