dcarve/tg-robot/miscelania/100hz(lp2hz).png

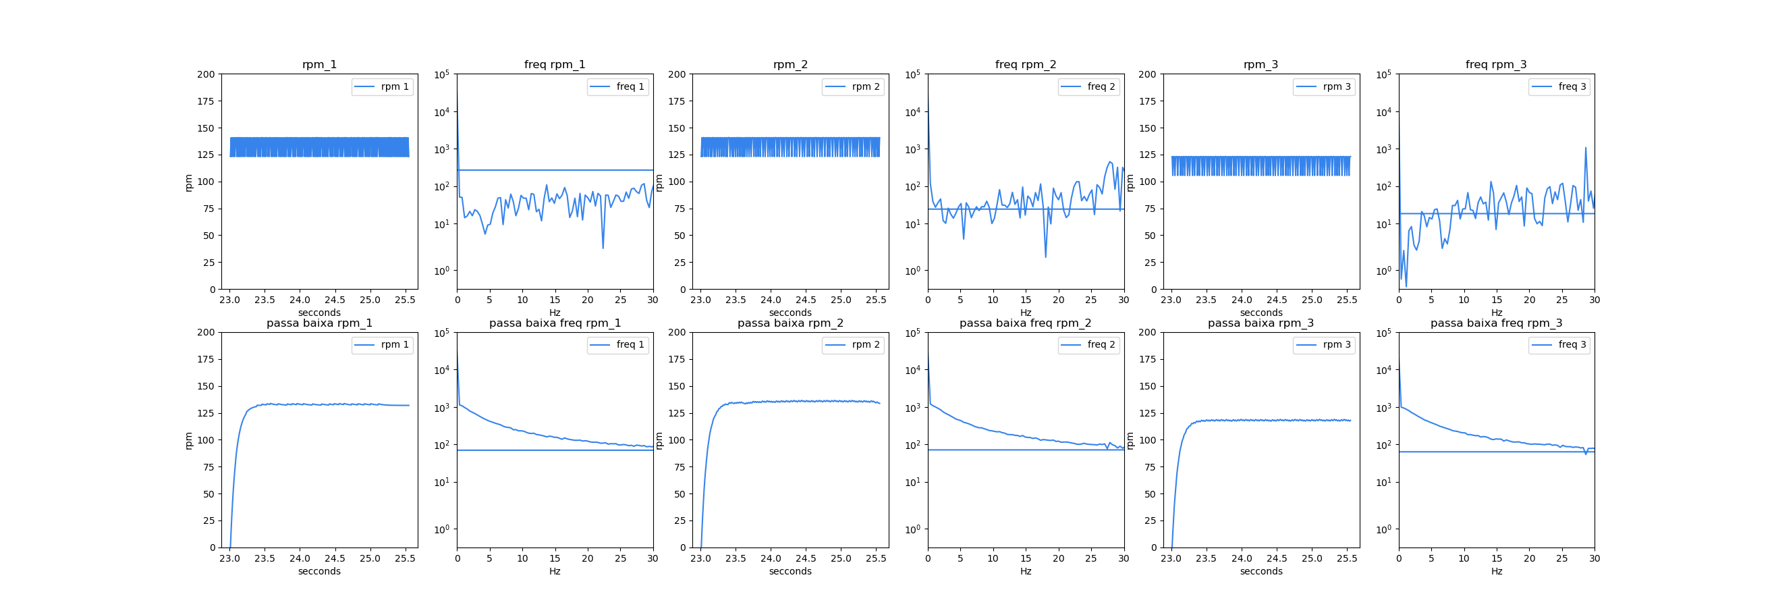
miscelania/100hz(lp2hz).png
