dcarve/tg-robot/miscelania/200hz(lp10hz).png

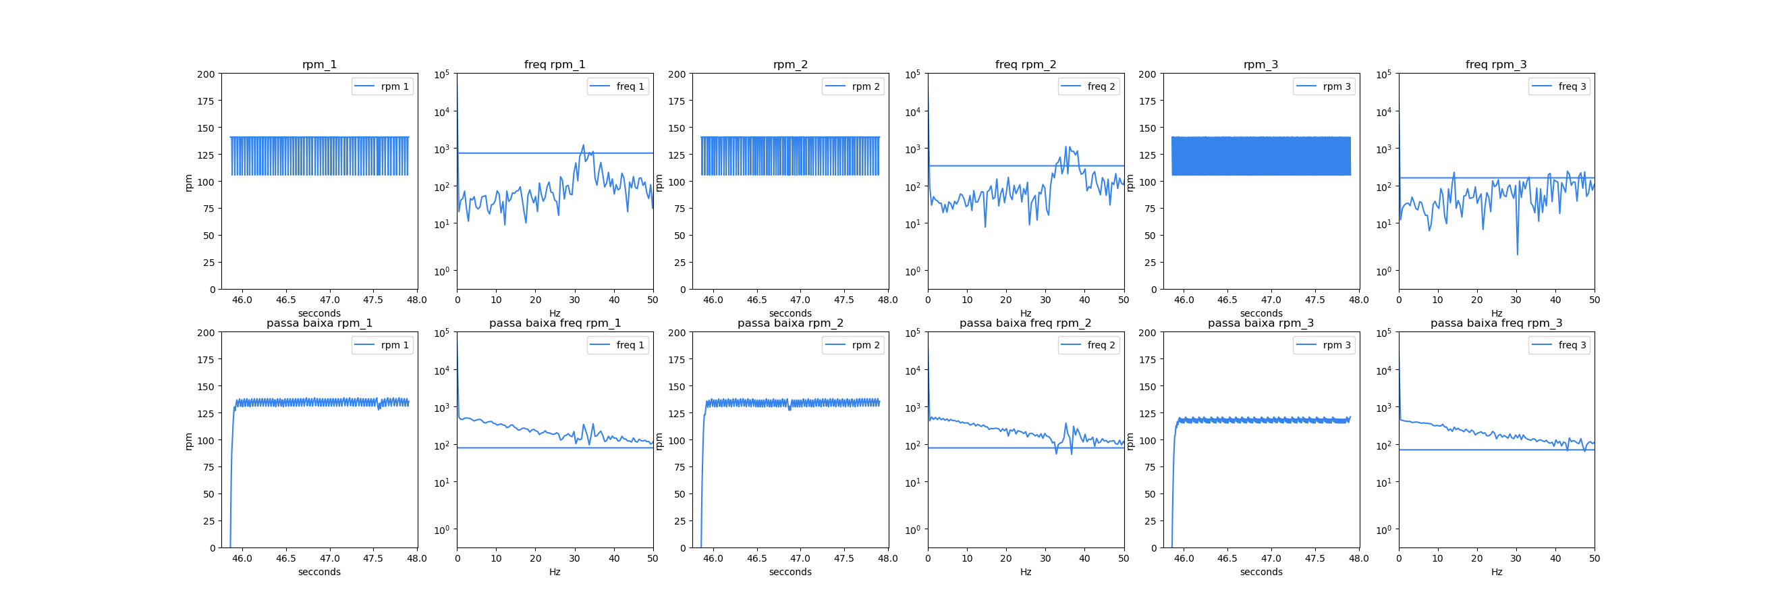
miscelania/200hz(lp10hz).png
