dcarve/tg-robot/miscelania/500hz(lp10hz).png

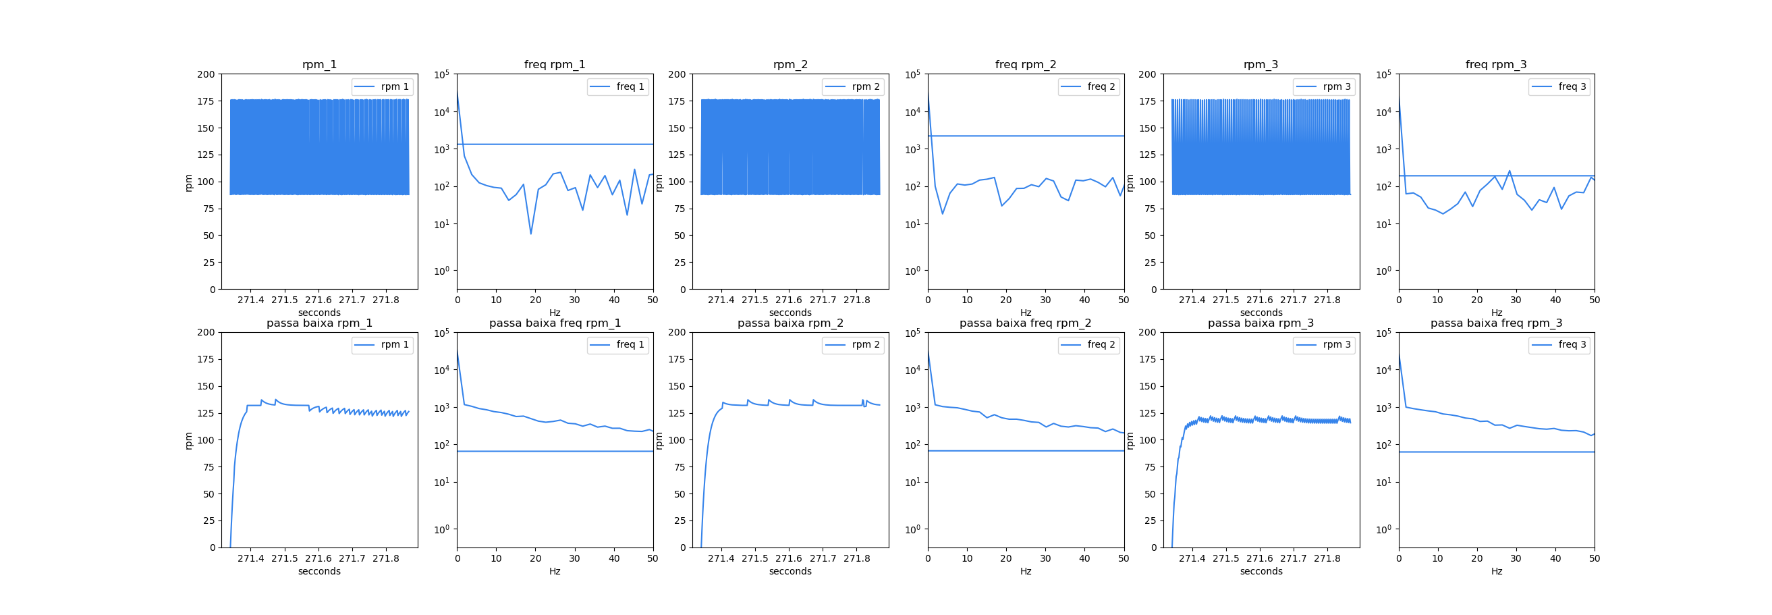
miscelania/500hz(lp10hz).png
