dcarve/tg-robot/miscelania/Captura de tela 2024-10-05 203040.png

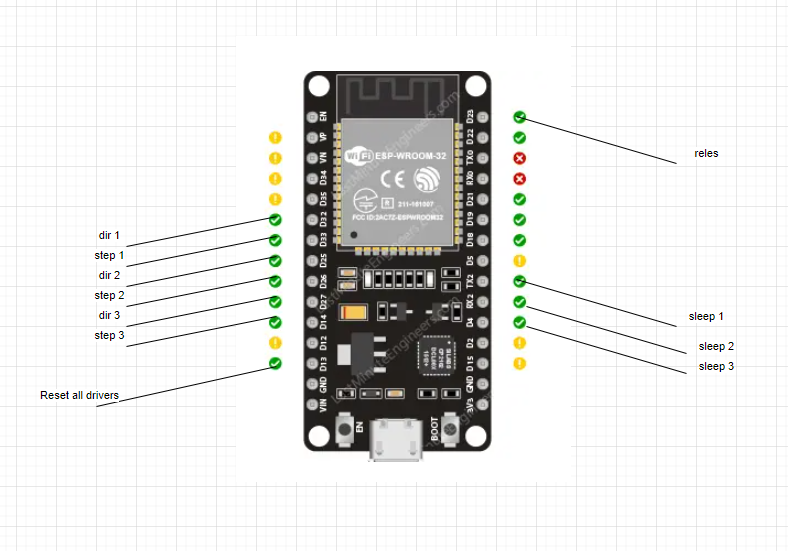
miscelania/Captura de tela 2024-10-05 203040.png
