dcarve/tg-robot/miscelania/comparacao rpm vs pwm.png

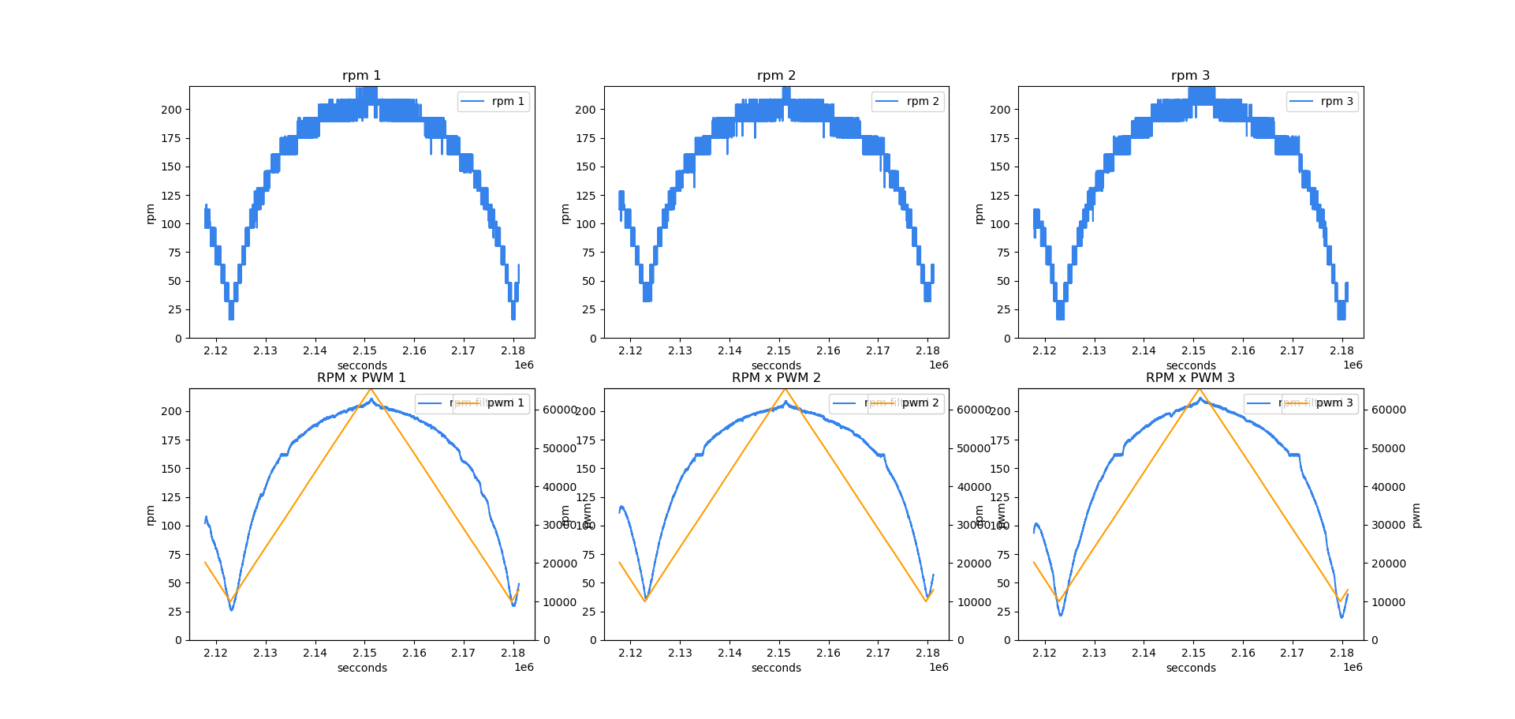
miscelania/comparacao rpm vs pwm.png
