dcarve/tg-robot/miscelania/comparacao_projetado_implementado.png

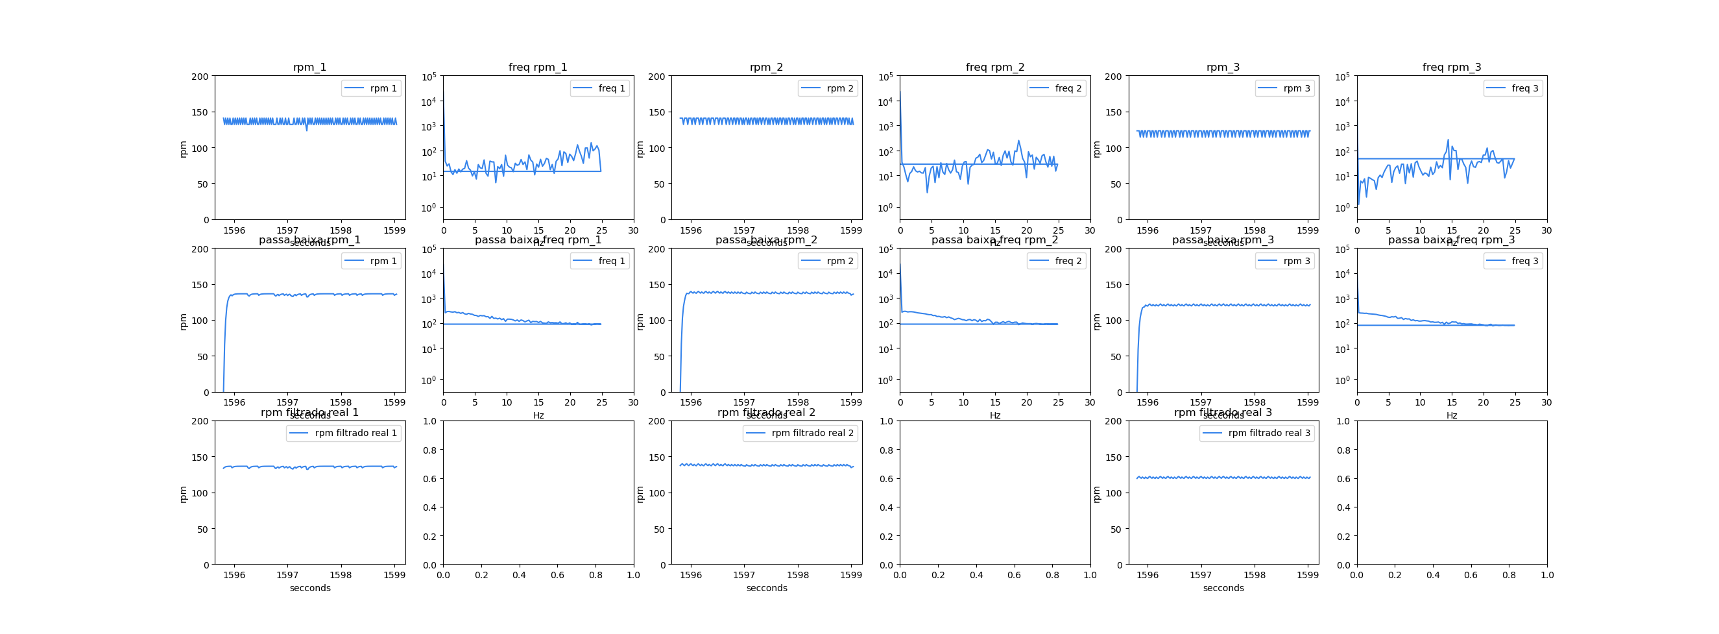
miscelania/comparacao_projetado_implementado.png
