dcarve/tg-robot/miscelania/DRV8825-Stepper-Motor-Driver-Pinout.webp

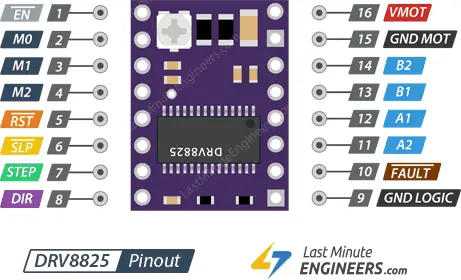
miscelania/DRV8825-Stepper-Motor-Driver-Pinout.webp
