dcarve/tg-robot/miscelania/pins.jpg

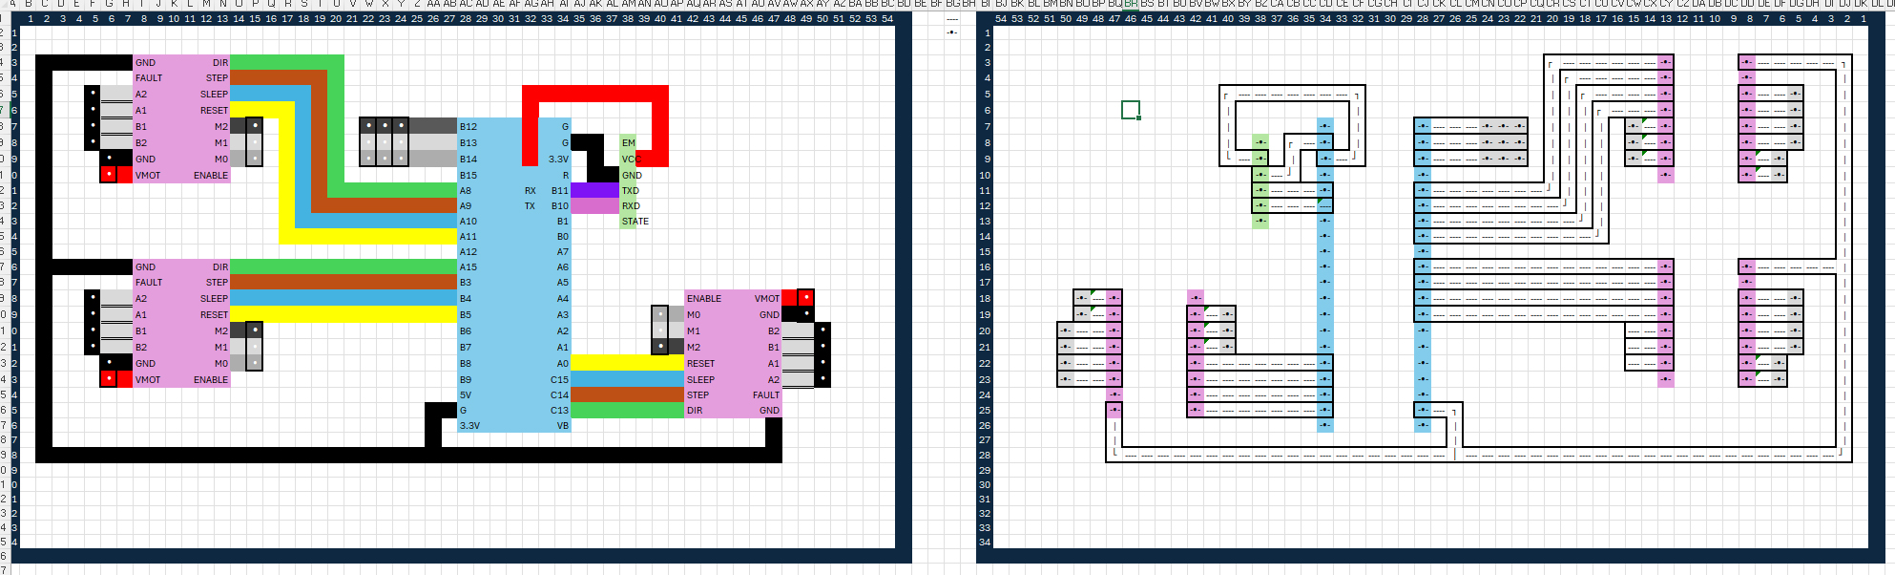
miscelania/pins.jpg
