dcarve/tg-robot/miscelania/python/analise_rpm_medido/Capturar.PNG

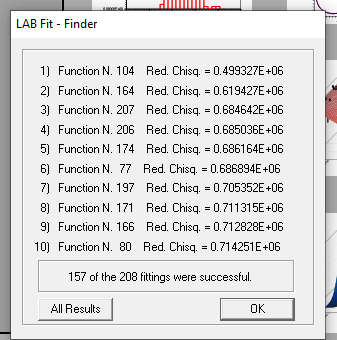
miscelania/python/analise_rpm_medido/Capturar.PNG
