dcarve/tg-robot/miscelania/Untitled-1.png

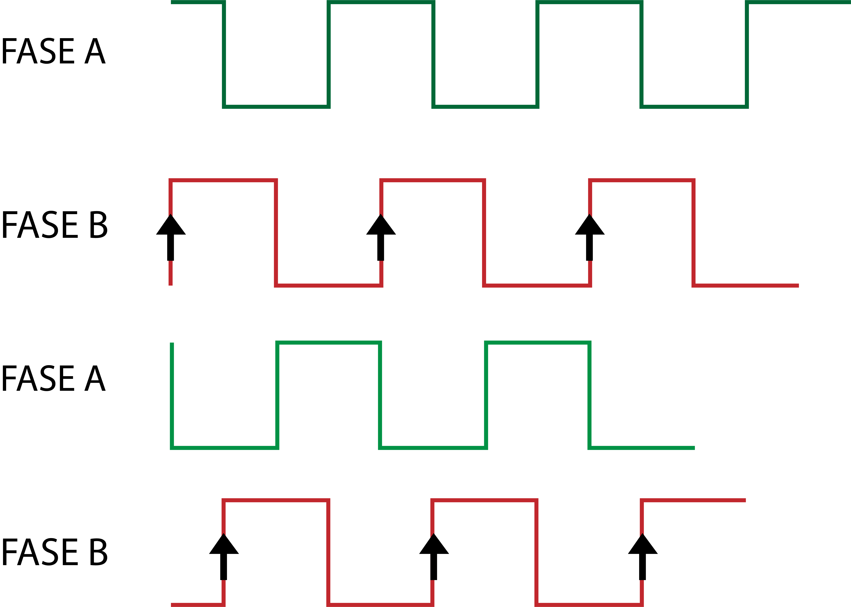
miscelania/Untitled-1.png
