dcarve/tg-robot/simulation/moviment_simulation/src/files_images/grid.png

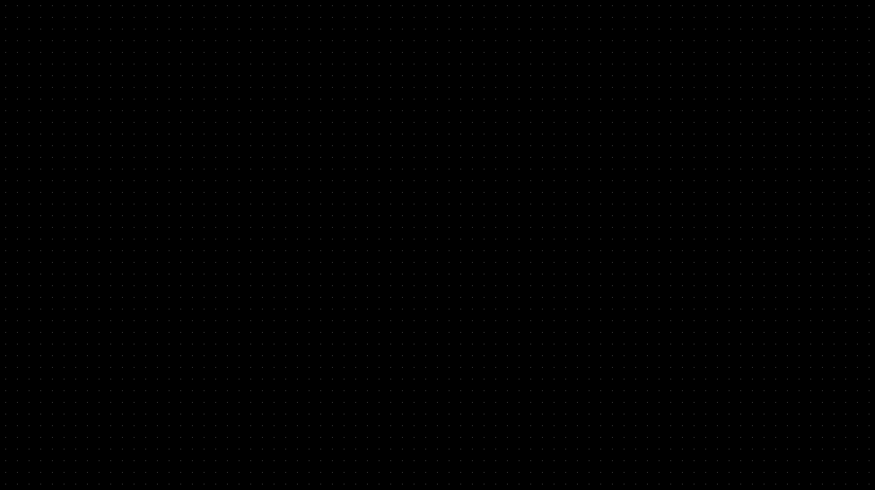
simulation/moviment_simulation/src/files_images/grid.png
