dcarve/tg-robot/cad_files/v2/testes/montagem_exemplo.SLDASM

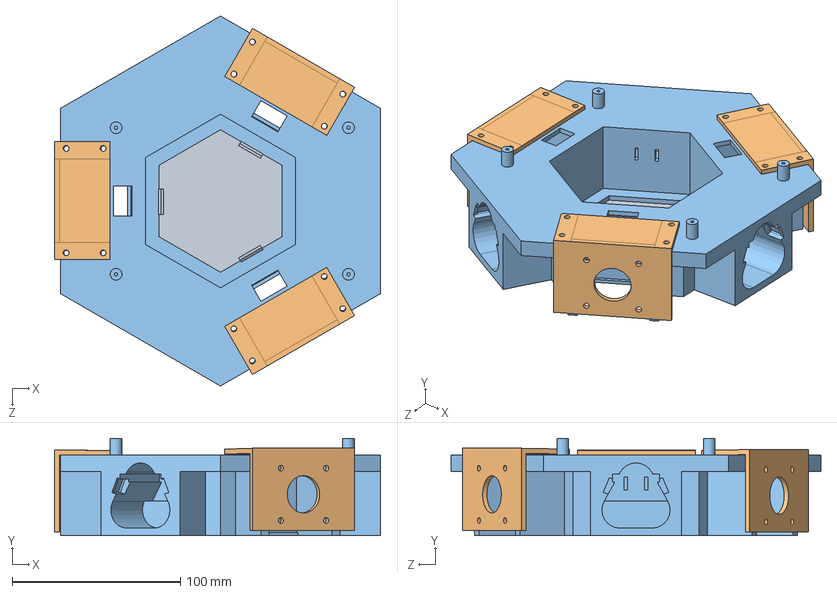
[picture p83: CAD file, 2024-08-11]
cad_files/v2/testes/montagem_exemplo.SLDASM
193.8 x 57.8 x 219.7 mm
chassi_2
suporte x 3
tampa
