dcarve/tg-robot/cad_files/3mf/suporte_proto_2.3MF

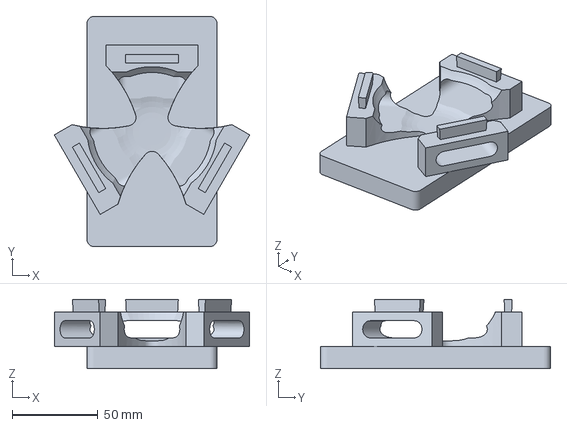
[picture p84: CAD file, 2024-10-05]
cad_files/3mf/suporte_proto_2.3MF
114.3 x 134.5 x 40.5 mm
