dcarve/tg-robot/cad_files/suportes de impressao/suporte_chassi_pequeno.SLDPRT

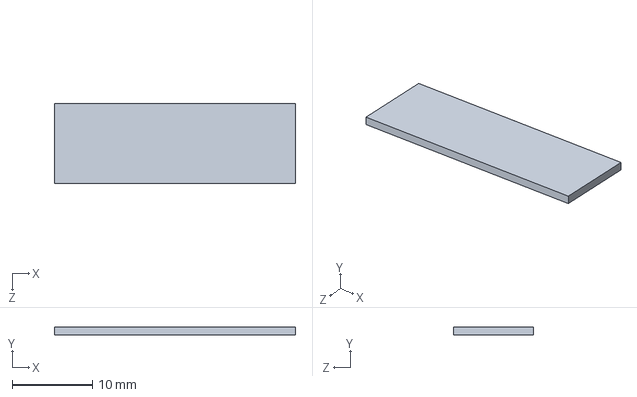
[picture p85: CAD file, 2024-08-11]
cad_files/suportes de impressao/suporte_chassi_pequeno.SLDPRT
30.0 x 1.00 x 10.0 mm
