dcarve/tg-robot/cad_files/v2/roda/rolda_acomaplemento_eixo.SLDPRT

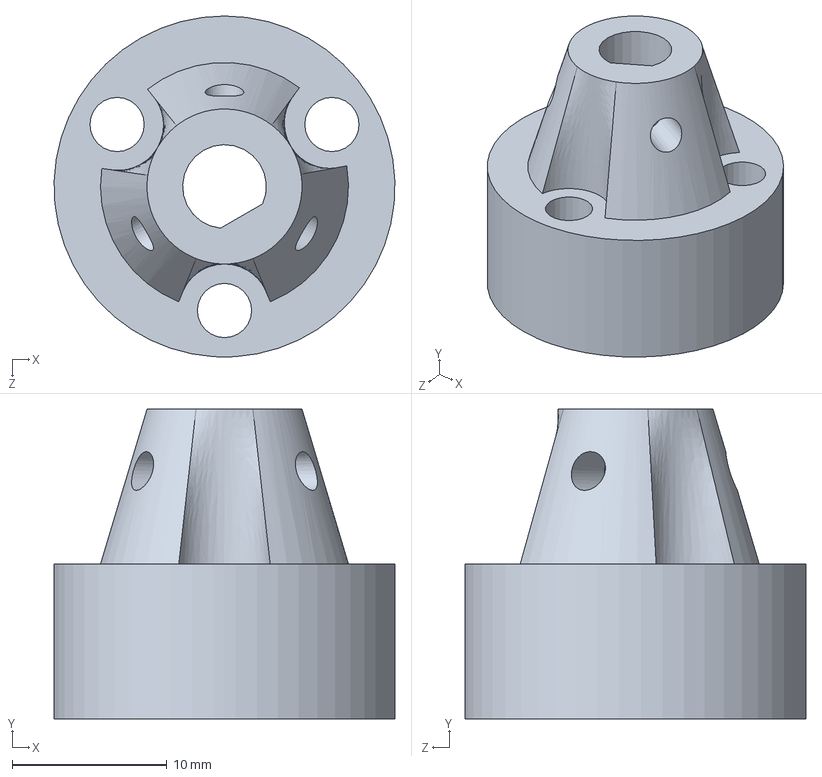
[picture p86: CAD file, 2024-08-11]
cad_files/v2/roda/rolda_acomaplemento_eixo.SLDPRT
22.0 x 20.0 x 22.0 mm
