dcarve/tg-robot/cad_files/v2/suporte_switch.SLDPRT

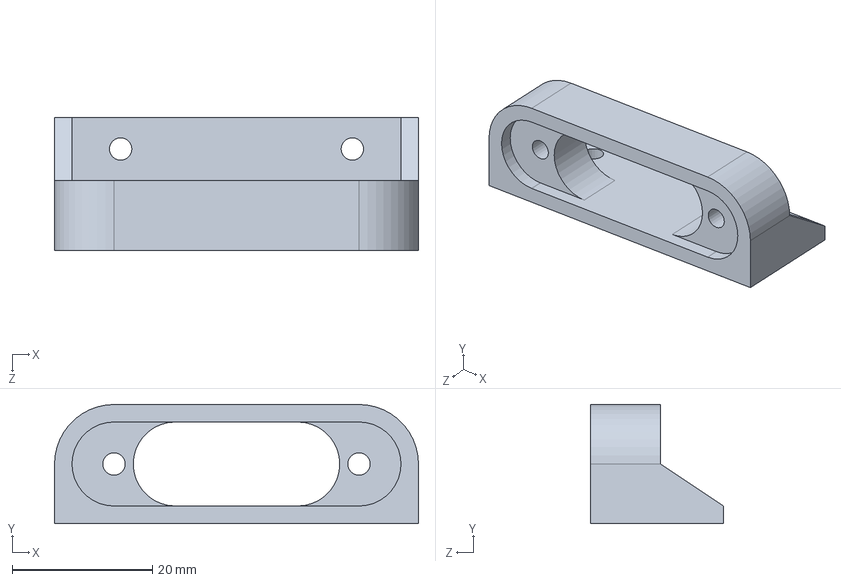
[picture p87: CAD file, 2024-10-05]
cad_files/v2/suporte_switch.SLDPRT
52.0 x 17.0 x 19.0 mm
