dcarve/tg-robot/cad_files/v2/testes/suporte_bateria.SLDPRT

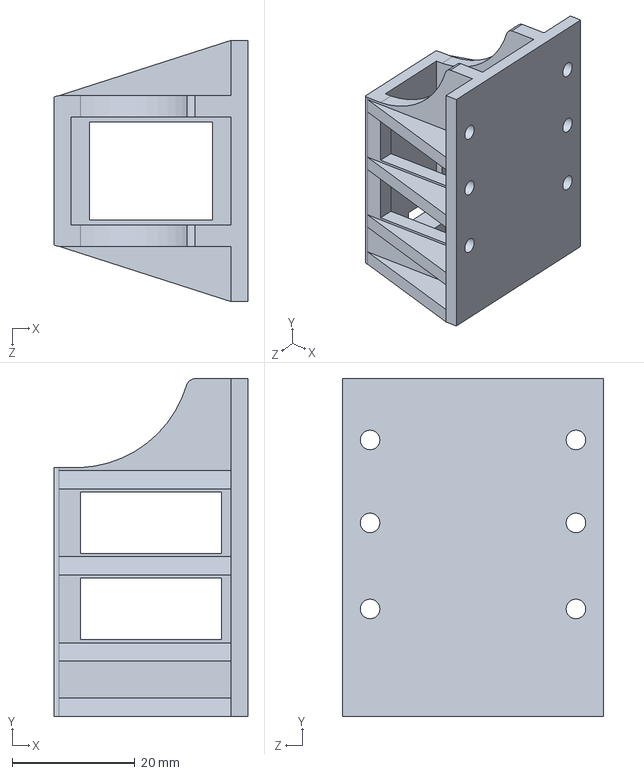
[picture p88: CAD file, 2024-10-05]
cad_files/v2/testes/suporte_bateria.SLDPRT
31.5 x 55.0 x 42.5 mm
