dcarve/tg-robot/miscelania/Peça1.SLDPRT

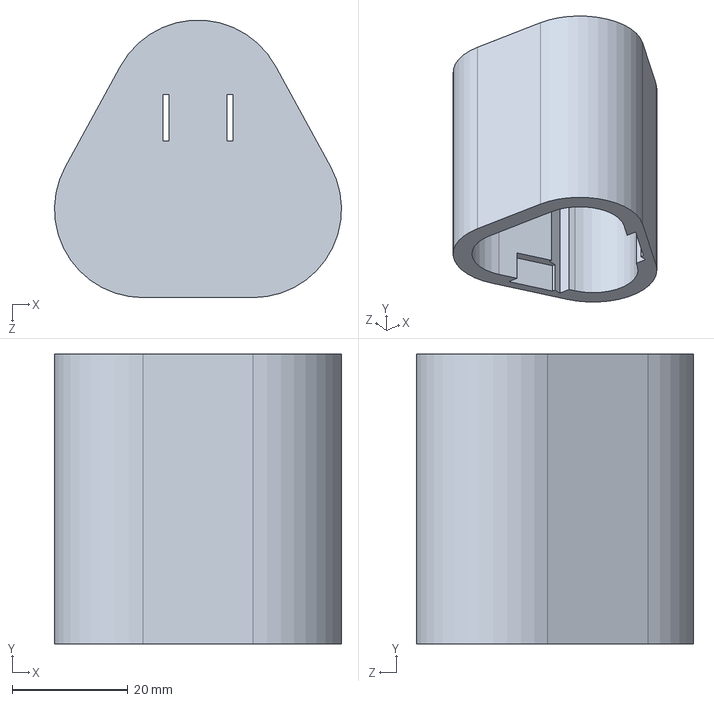
[picture p89: CAD file, 2024-08-11]
miscelania/Peça1.SLDPRT
49.5 x 50.0 x 47.8 mm
