dcarve/tg-robot/cad_files/suportes de impressao/suporte_power_back_impressao.SLDPRT

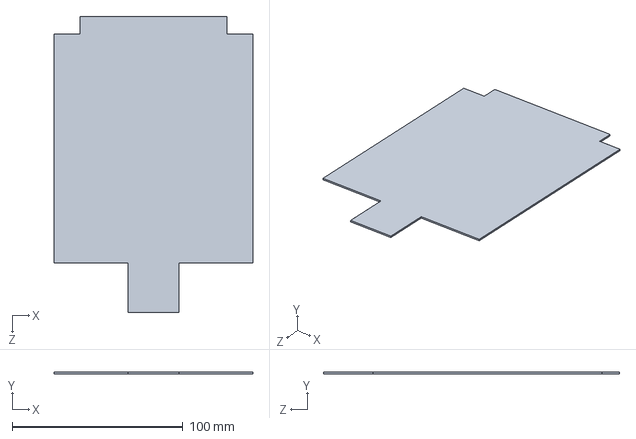
[picture p90: CAD file, 2024-08-11]
cad_files/suportes de impressao/suporte_power_back_impressao.SLDPRT
116.5 x 1.00 x 173.5 mm
