dcarve/tg-robot/cad_files/v2/roda/roda_lado_2.SLDPRT

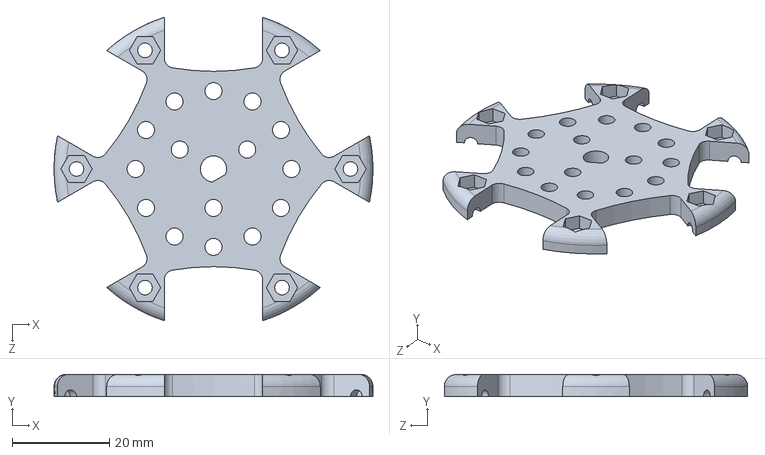
[picture p91: CAD file, 2024-08-11]
cad_files/v2/roda/roda_lado_2.SLDPRT
65.5 x 4.60 x 62.3 mm
