dcarve/tg-robot/cad_files/v2/tampa.SLDPRT

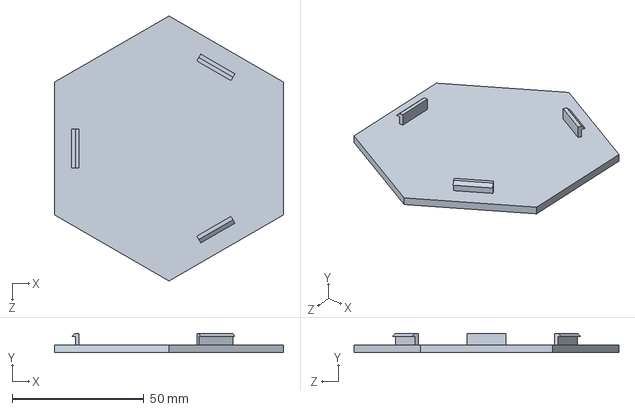
[picture p92: CAD file, 2024-08-11]
cad_files/v2/tampa.SLDPRT
87.2 x 7.40 x 100.7 mm
