dcarve/tg-robot/cad_files/v2/testes/suporte_proto.SLDPRT

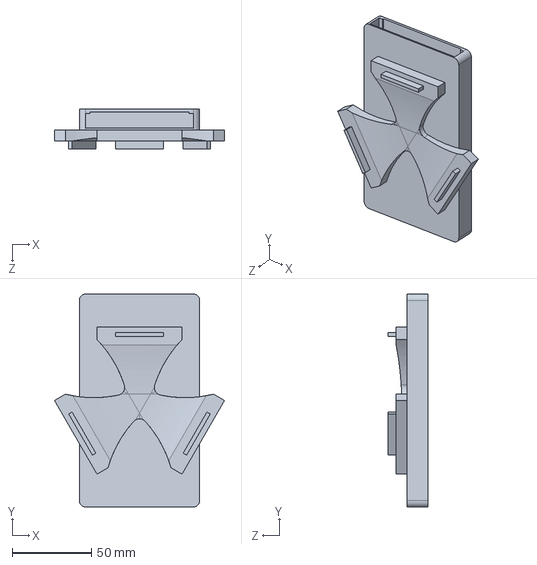
[picture p93: CAD file, 2024-10-05]
cad_files/v2/testes/suporte_proto.SLDPRT
107.4 x 134.5 x 25.0 mm
