dcarve/tg-robot/miscelania/peca2.SLDPRT

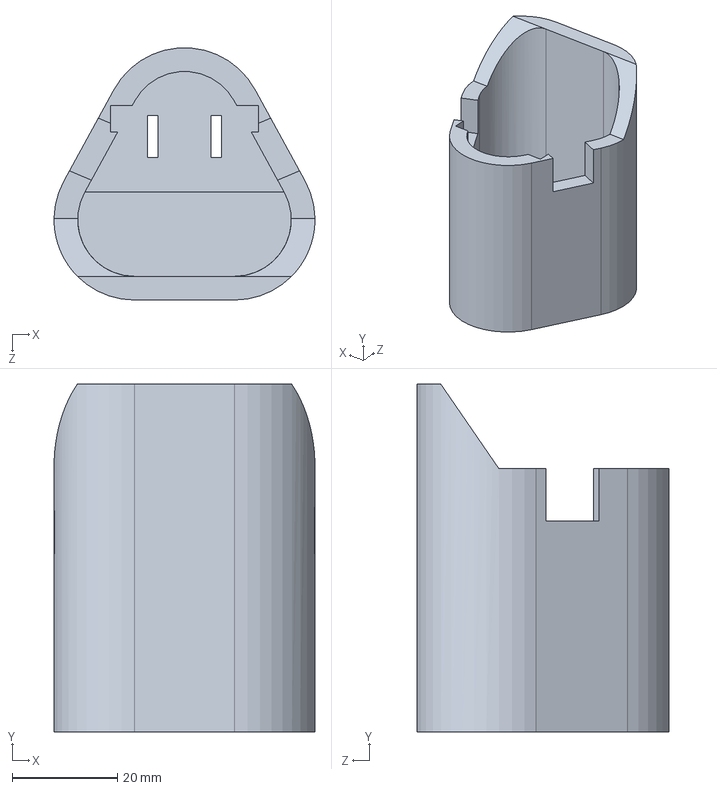
[picture p94: CAD file, 2024-08-11]
miscelania/peca2.SLDPRT
49.5 x 66.0 x 47.8 mm
