dcarve/tg-robot/cad_files/v2/roda/roda_acomplamento.SLDPRT

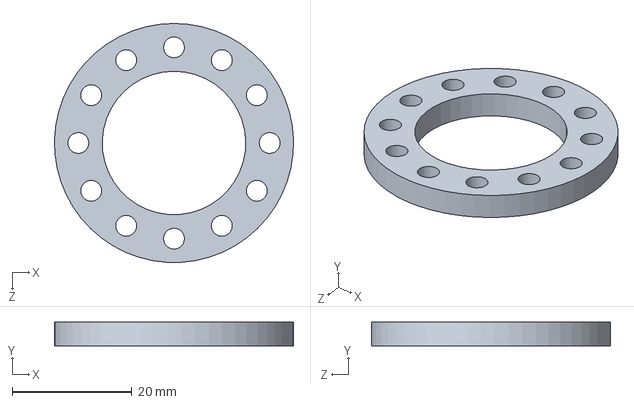
[picture p95: CAD file, 2024-08-11]
cad_files/v2/roda/roda_acomplamento.SLDPRT
40.0 x 4.00 x 40.0 mm
