dcarve/tg-robot/cad_files/v2/suporte.SLDPRT

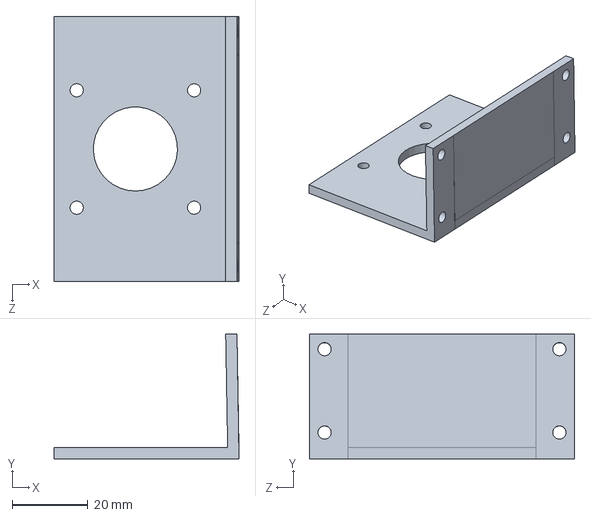
[picture p96: CAD file, 2024-08-11]
cad_files/v2/suporte.SLDPRT
48.8 x 33.0 x 70.0 mm
