dcarve/tg-robot/cad_files/v2/testes/Peça1.SLDPRT

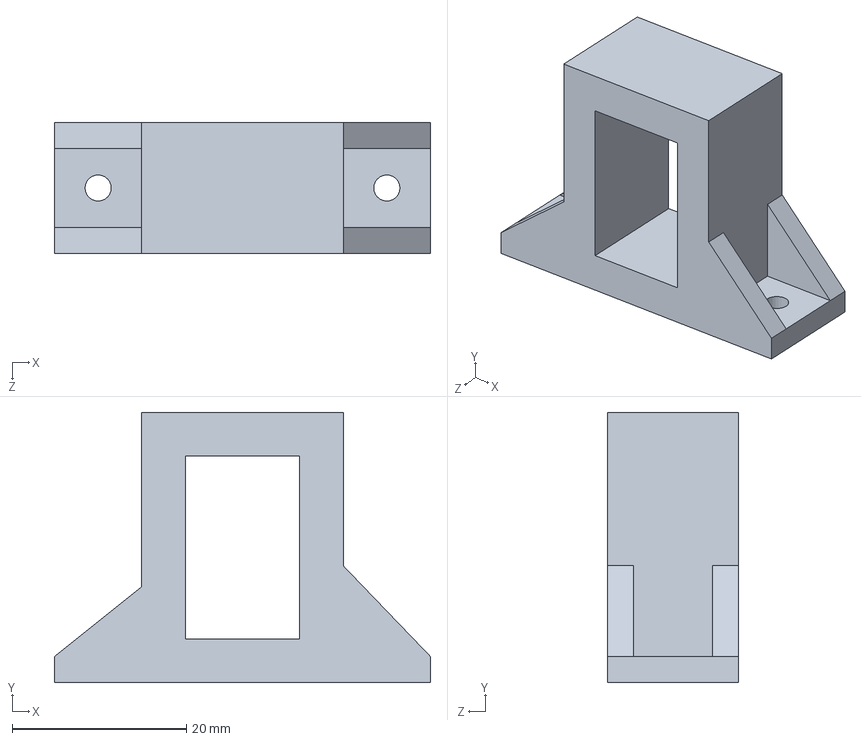
[picture p97: CAD file, 2024-10-05]
cad_files/v2/testes/Peça1.SLDPRT
43.1 x 31.0 x 15.0 mm
