dcarve/tg-robot/miscelania/Bosch_12V_Charger_Holder1.SLDPRT

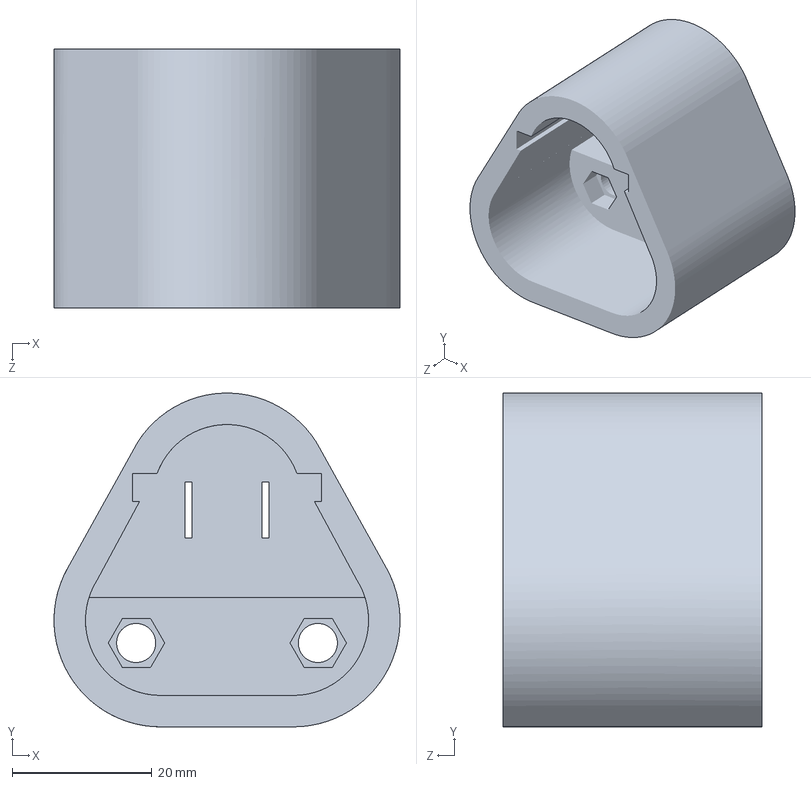
[picture p98: CAD file, 2024-08-11]
miscelania/Bosch_12V_Charger_Holder1.SLDPRT
49.5 x 47.7 x 37.0 mm
