dcarve/tg-robot/cad_files/v2/chassi_3.SLDPRT

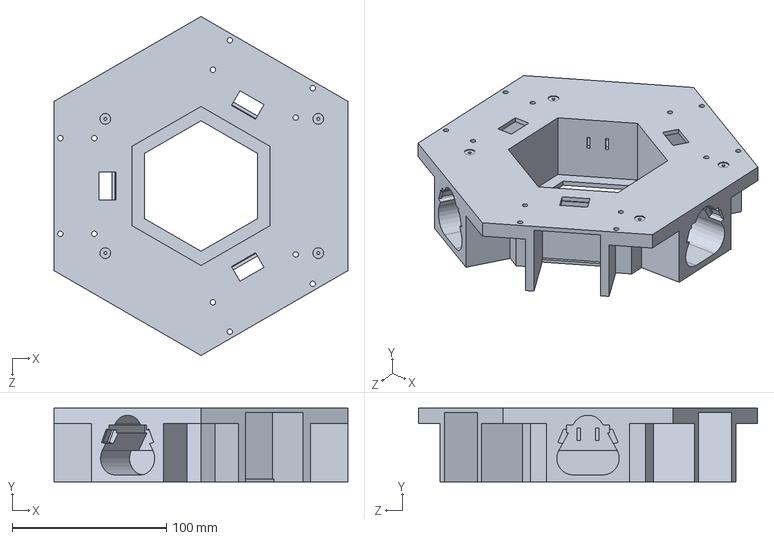
[picture p99: CAD file, 2024-08-11]
cad_files/v2/chassi_3.SLDPRT
190.2 x 47.9 x 219.7 mm
