dcarve/tg-robot/miscelania/peça3.SLDPRT

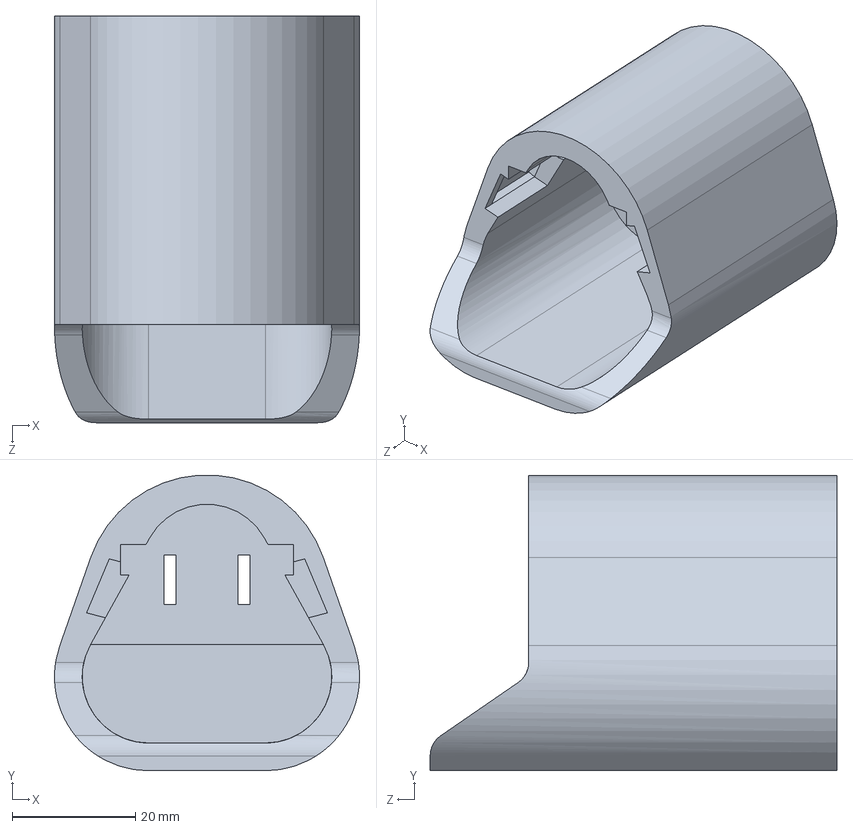
[picture p100: CAD file, 2024-08-11]
miscelania/peça3.SLDPRT
49.5 x 47.9 x 66.0 mm
