dcarve/tg-robot/cad_files/v2/testes/power_bank_slot_v2.SLDPRT

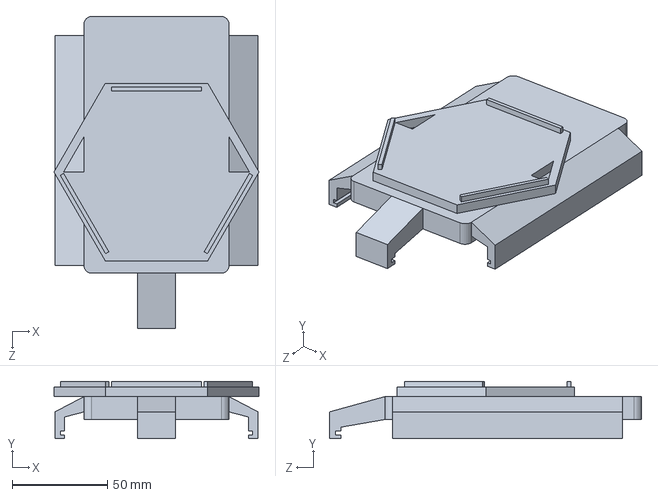
[picture p102: CAD file, 2024-08-11]
cad_files/v2/testes/power_bank_slot_v2.SLDPRT
107.4 x 30.0 x 163.5 mm
