dcarve/tg-robot/cad_files/3mf/roda_acomplamento_2.3MF

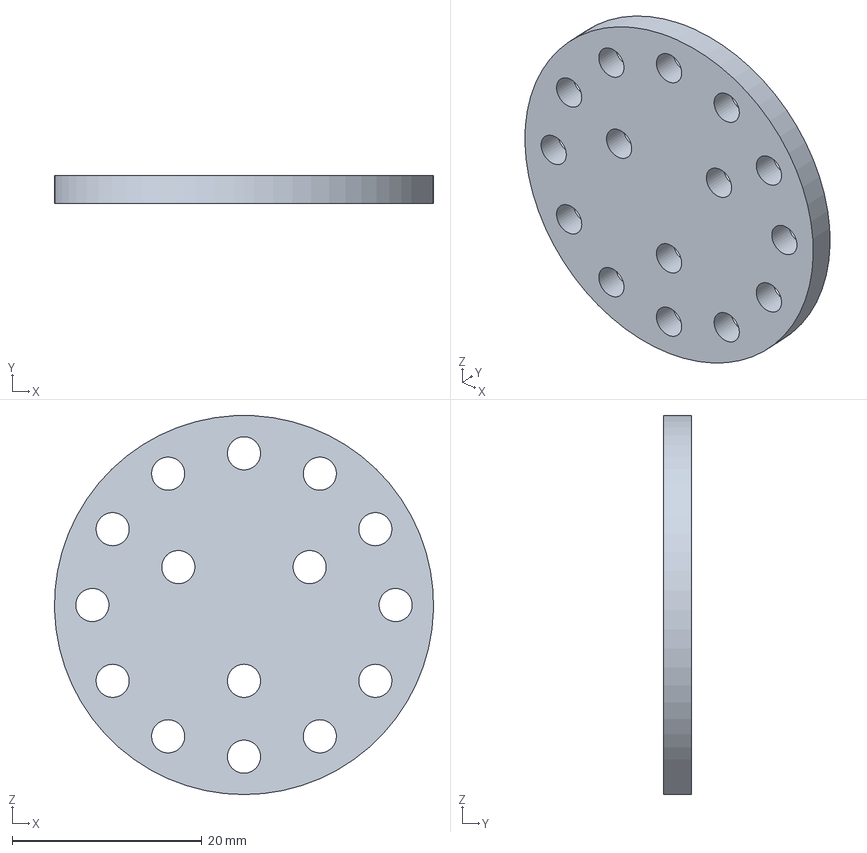
[picture p103: CAD file, 2024-08-11]
cad_files/3mf/roda_acomplamento_2.3MF
40.0 x 3.00 x 40.0 mm
