dcarve/tg-robot/cad_files/3mf/roda_teste.3MF

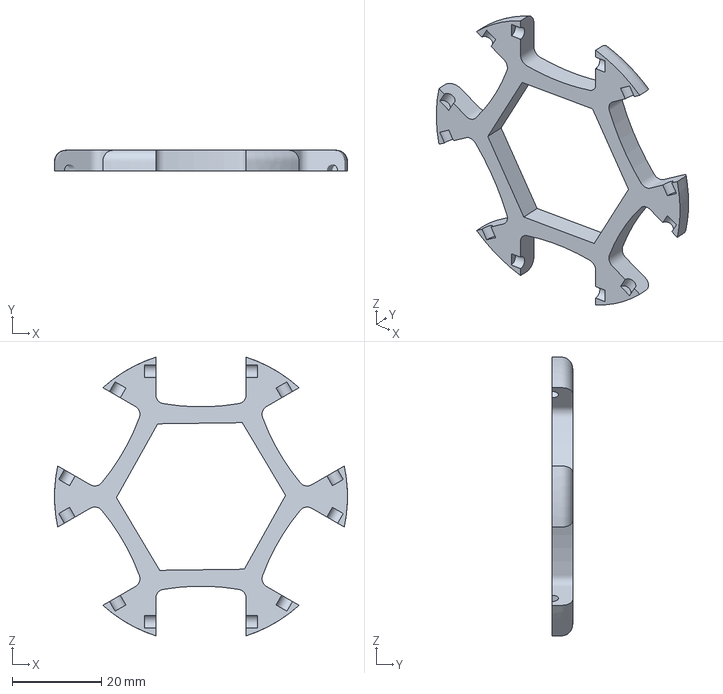
[picture p104: CAD file, 2024-08-11]
cad_files/3mf/roda_teste.3MF
65.5 x 4.60 x 62.3 mm
