dcarve/tg-robot/cad_files/v2/testes/chassi_2.SLDPRT

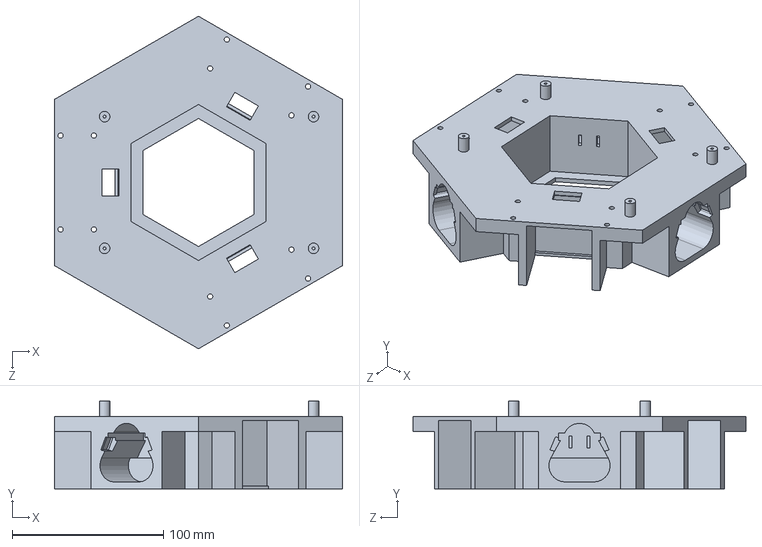
[picture p105: CAD file, 2024-08-11]
cad_files/v2/testes/chassi_2.SLDPRT
190.2 x 57.8 x 219.7 mm
