dcarve/tg-robot/cad_files/v2/testes/suporte_chassi.SLDPRT

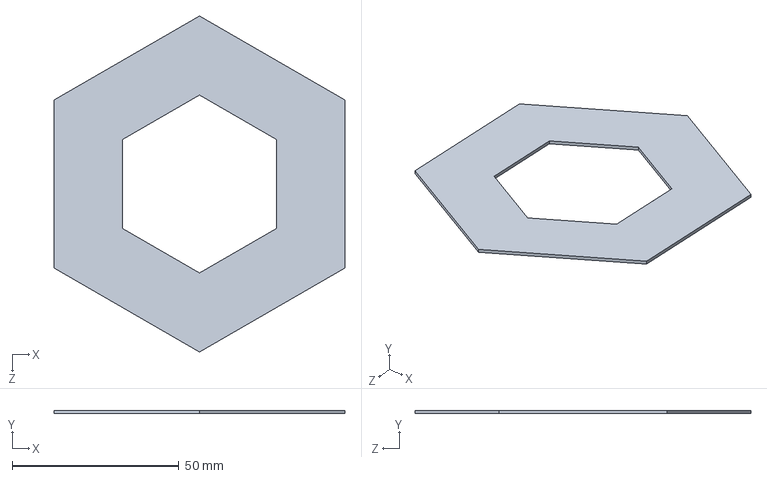
[picture p106: CAD file, 2024-08-11]
cad_files/v2/testes/suporte_chassi.SLDPRT
87.2 x 1.00 x 100.7 mm
