dcarve/tg-robot/cad_files/v2/testes/suporte_cilindrico_v2.SLDPRT

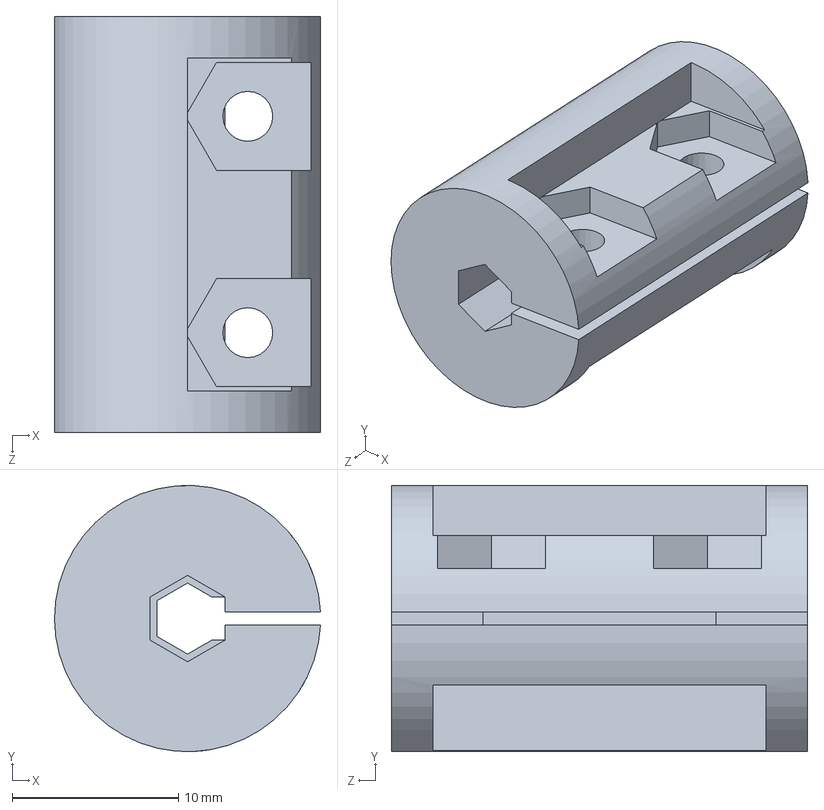
[picture p107: CAD file, 2024-08-11]
cad_files/v2/testes/suporte_cilindrico_v2.SLDPRT
16.0 x 16.0 x 25.0 mm
