dcarve/tg-robot/cad_files/3mf/power_bank_slot.3MF

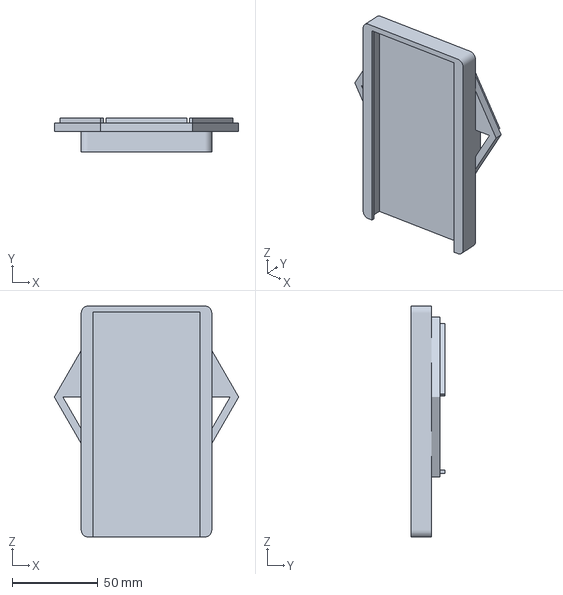
[picture p108: CAD file, 2024-08-11]
cad_files/3mf/power_bank_slot.3MF
107.4 x 20.0 x 134.5 mm
