dcarve/tg-robot/cad_files/v2/testes/analise_encaixe.SLDPRT

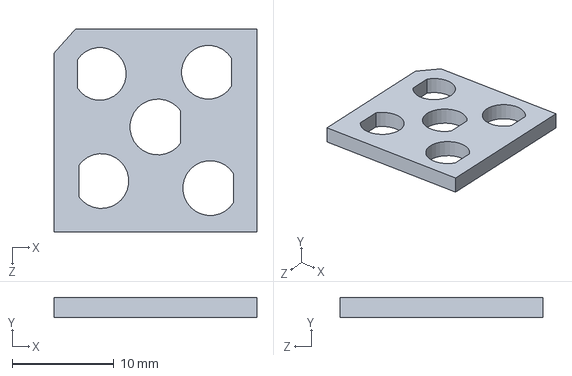
[picture p109: CAD file, 2024-08-11]
cad_files/v2/testes/analise_encaixe.SLDPRT
20.0 x 2.00 x 20.0 mm
