dcarve/tg-robot/cad_files/3mf/analise_encaixe.3MF

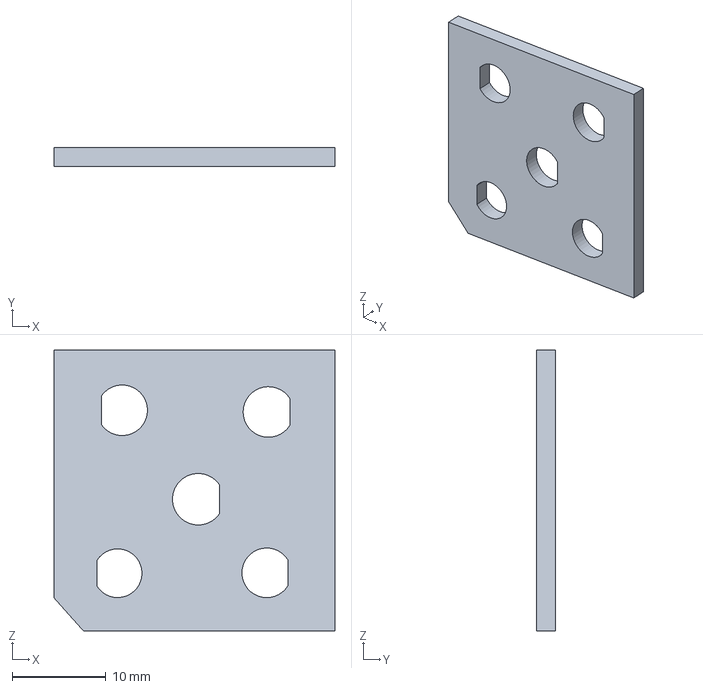
[picture p110: CAD file, 2024-08-11]
cad_files/3mf/analise_encaixe.3MF
30.0 x 2.00 x 30.0 mm
