dcarve/tg-robot/cad_files/3mf/CE3S1PRO_suporte_chassi.3mf

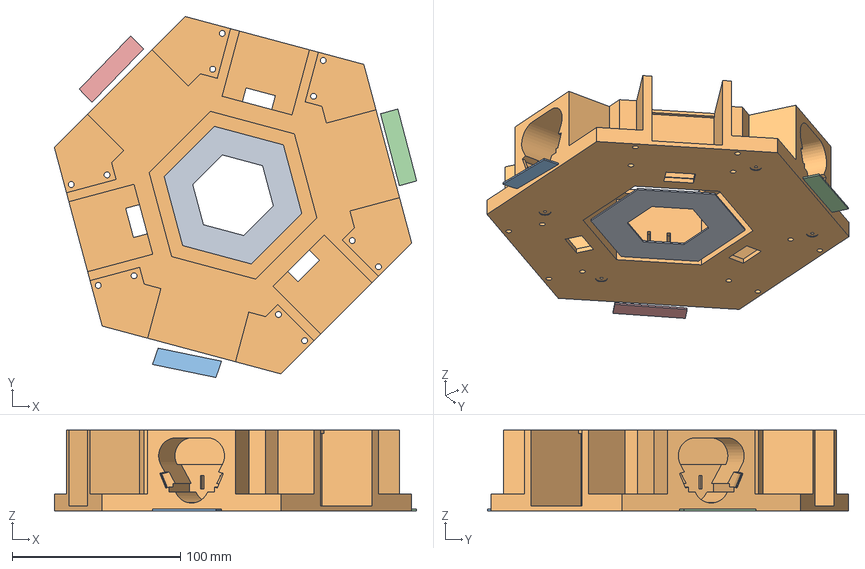
[picture p111: CAD file, 2024-08-11]
cad_files/3mf/CE3S1PRO_suporte_chassi.3mf
215.1 x 214.3 x 47.9 mm
suporte_chassi.3MF
chassi_3.3MF
suporte_chassi_pequeno.3MF
suporte_chassi_pequeno.3MF(1)
suporte_chassi_pequeno.3MF(2)
