dcarve/tg-robot/cad_files/3mf/rodas_ajustes.3mf

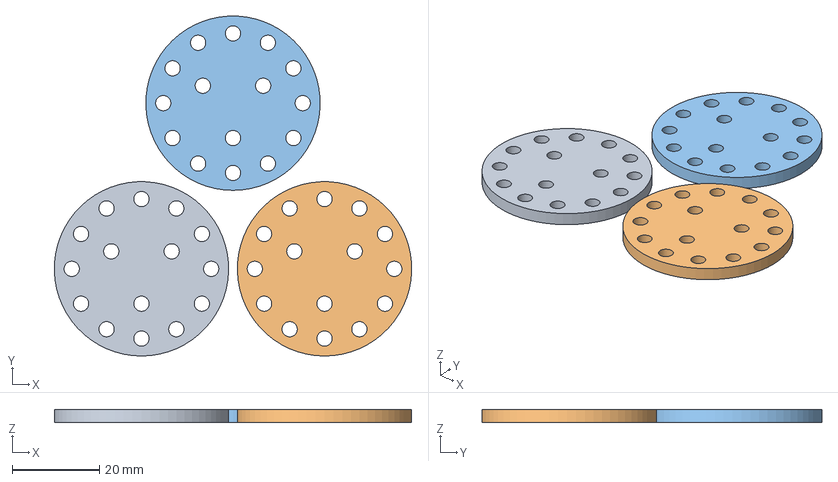
[picture p112: CAD file, 2024-08-11]
cad_files/3mf/rodas_ajustes.3mf
82.0 x 78.0 x 3.00 mm
roda_acomplamento_2.3MF
roda_acomplamento_2.3MF(1)
roda_acomplamento_2.3MF(2)
