dcarve/tg-robot/cad_files/3mf/CE3S1PRO_roda_acomplamento.3mf

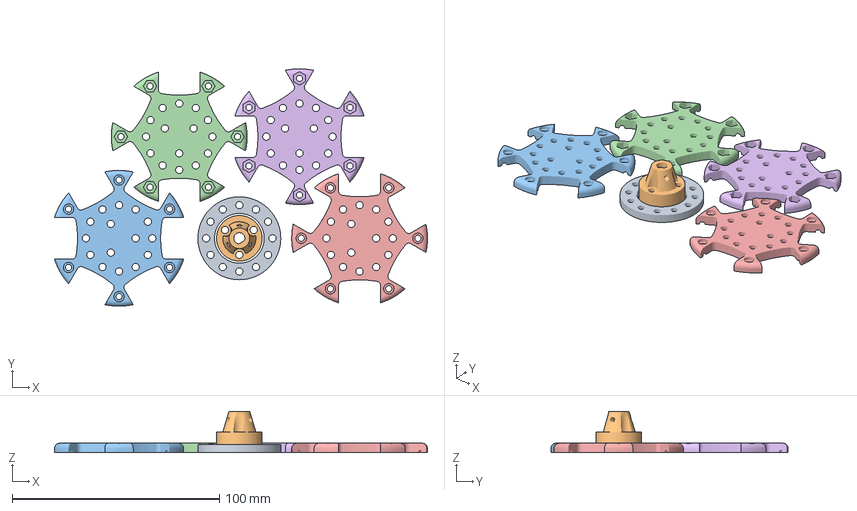
[picture p113: CAD file, 2024-08-11]
cad_files/3mf/CE3S1PRO_roda_acomplamento.3mf
179.9 x 114.5 x 20.0 mm
roda_acomplamento.3MF
rolda_acomaplemento_eixo.3MF
roda_lado_1.3MF
roda_lado_2.3MF
roda_lado_3.3MF
roda_lado_4.3MF
