dcarve/tg-robot/cad_files/3mf/suporte_cilindrico_2.3MF

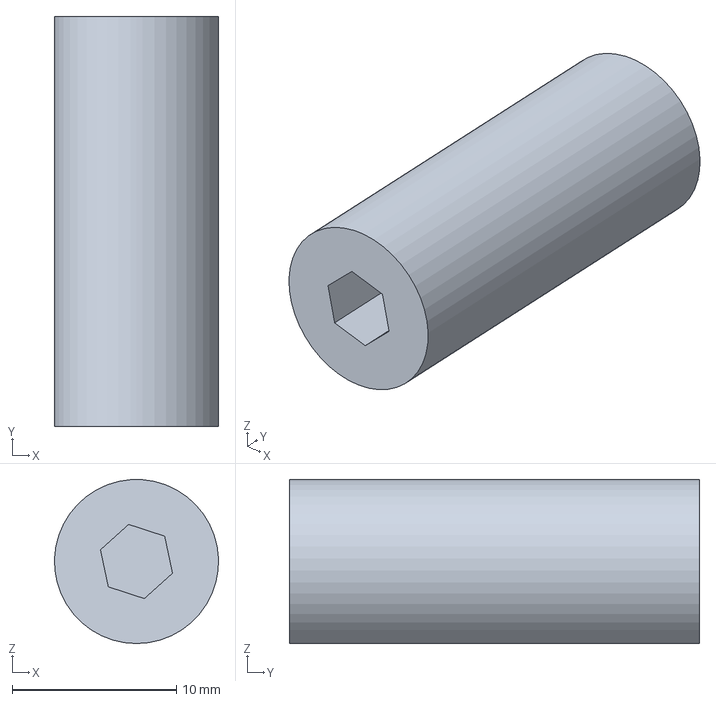
[picture p114: CAD file, 2024-08-11]
cad_files/3mf/suporte_cilindrico_2.3MF
9.99 x 25.0 x 10.0 mm
