dcarve/tg-robot/(list of files, cad)

Other CAD files:
cad_files/3mf/suporte_switch.3MF
cad_files/3mf/suporte_bateria.3MF
cad_files/3mf/suporte_swith.3MF
cad_files/v2/roda/roda_lado_4.SLDPRT
cad_files/v2/testes/suporte_proto_2.SLDPRT
cad_files/3mf/suporte_proto.3MF
miscelania/acoplamento.dwg
cad_files/v2/roda/roda_acomplamento_2.SLDPRT
cad_files/v2/roda/roda_lado_3.SLDPRT
cad_files/3mf/rolda_acomaplemento_eixo.3MF
cad_files/3mf/suporte_chassi.3MF
cad_files/v2/testes/power_bank_slot.SLDPRT
cad_files/3mf/suporte_power_back_impressao.3MF
cad_files/3mf/suporte_cilindrico.3MF
cad_files/3mf/tampa.3MF
cad_files/3mf/roda_lado_1.3MF
cad_files/3mf/chassi_3.3MF
cad_files/3mf/suporte_cilindrico_v2.3MF
cad_files/3mf/roda_lado_4.SLDPRT
cad_files/3mf/roda_acomplamento.3MF
cad_files/3mf/roda_lado_2.3MF
cad_files/3mf/chassi_2.3MF
cad_files/3mf/suporte.3MF
cad_files/3mf/roda_lado_3.3MF
cad_files/3mf/power_bank_slot_v2.3MF
cad_files/3mf/suporte_chassi_pequeno.3MF
cad_files/3mf/roda_lado_4.3MF
cad_files/v1/L298N.SLDASM
cad_files/v1/L298N.x_t
cad_files/v1/Pcb.SLDPRT
cad_files/v1/base_protoboard.SLDPRT
cad_files/v1/chassi_inferiror_2.3MF
cad_files/v1/chassi_inferiror_2.SLDPRT
cad_files/v1/mancal.SLDPRT
cad_files/v1/montagem.SLDASM
cad_files/v1/motor.SLDPRT
cad_files/v1/robot.dwg
cad_files/v1/robot_2.dwg
cad_files/v1/simplificacao.dwg
cad_files/v1/simplificacao.dxf
cad_files/v1/suporte.SLDPRT
miscelania/peca2.3MF
miscelania/peça3.3MF
