dcarve/tg-robot/latex_doc/TGII/attachments/fabricacao.tex

\chapter{Fabricação e montagem - CAD}
\label{att_fabricao_montagem_cad}

\begin{figure}[h]
	\centering
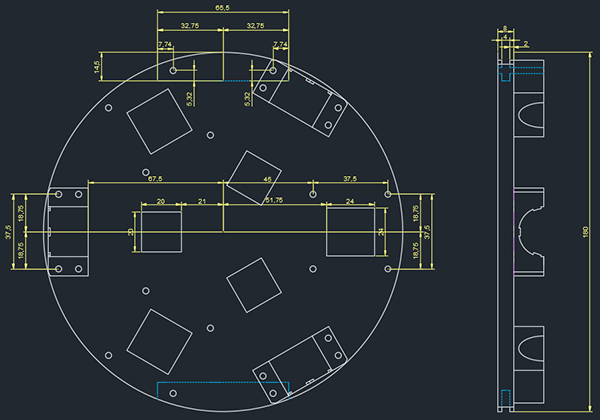
[picture p115: latex_doc/TGII/figures/cad1.png]
	
	\caption{Base do robô}
	\label{fig:base_robo}
\end{figure}

\begin{figure}[h]
	\centering
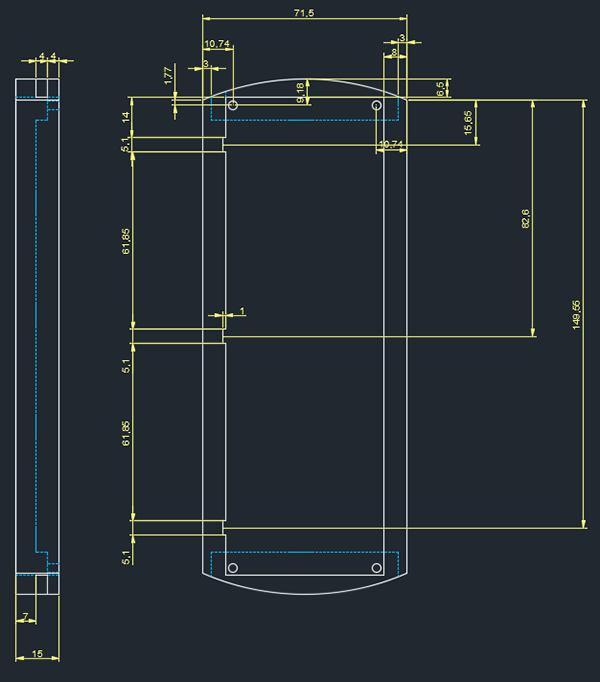
[picture p116: latex_doc/TGII/figures/cad2.png]
	
	\caption{Suporte Protoboard}
	\label{fig:suport_protoboard}
\end{figure}

\begin{figure}[h]
	\centering
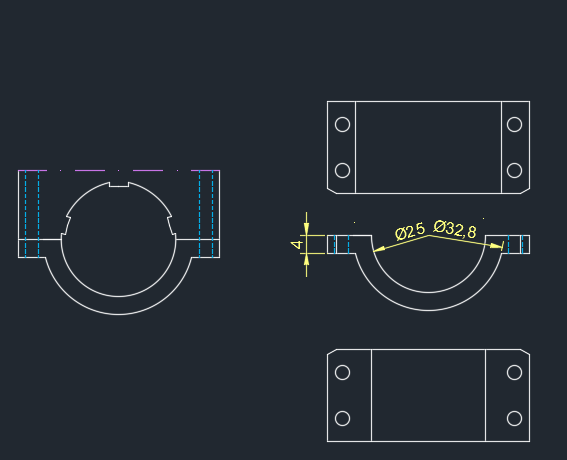
[picture p117: latex_doc/TGII/figures/cad3.png]
	
	\caption{Abraçadeira dos Motores - 1}
	\label{fig:abracadeira}
\end{figure}

\begin{figure}[h]
	\centering
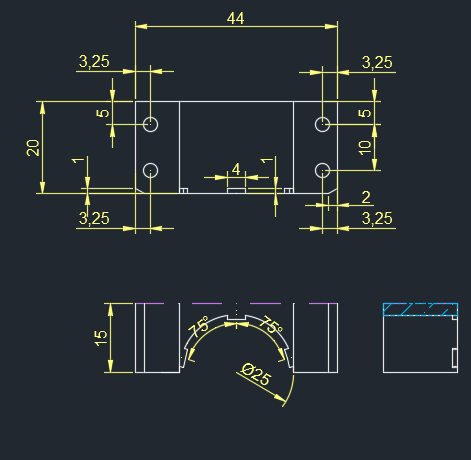
[picture p118: latex_doc/TGII/figures/cad3_2.png]
	
	\caption{Abraçadeira dos Motores - 2}
	\label{fig:abracadeira_2}
\end{figure}

\begin{figure}[h]
	\centering
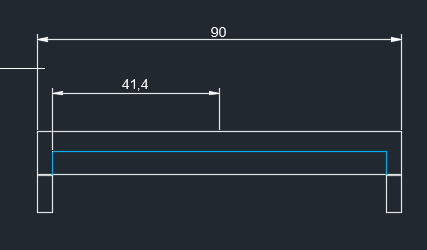
[picture p119: latex_doc/TGII/figures/cad4.png]
	
	\caption{peça que conecta o suporte de protoboard e a base - 1}
	\label{fig:peca_juncao}
\end{figure}

\begin{figure}[h]
	\centering
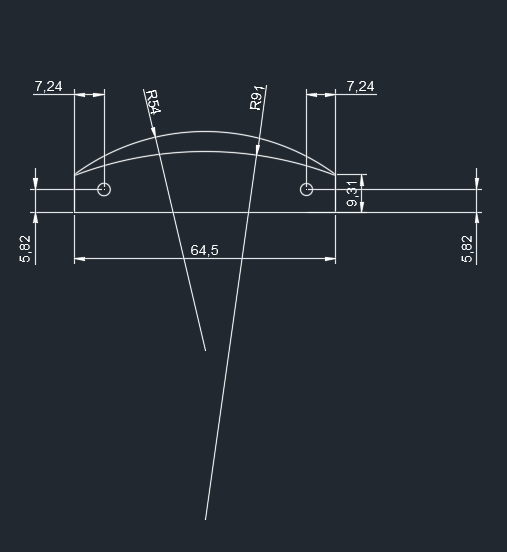
[picture p120: latex_doc/TGII/figures/cad4_2.png]
	
	\caption{peça que conecta o suporte de protoboard e a base - 2}
	\label{fig:peca_juncao_2}
\end{figure}

\chapter{Modelagem 3D}
\label{att_fabricao_montagem_modelagem}

\begin{figure}[h]
	\centering
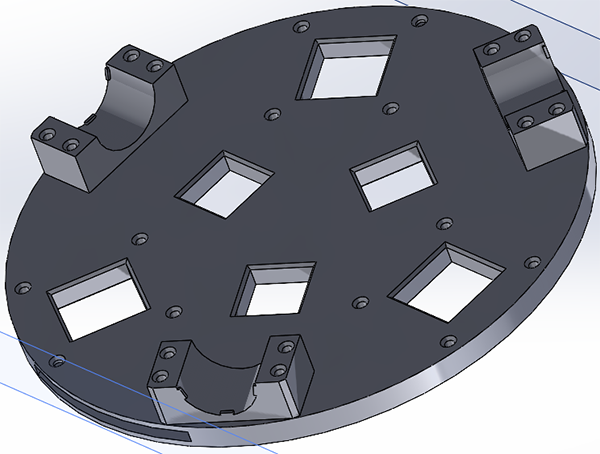
[picture p121: latex_doc/TGII/figures/3d_1.png]
	
	\caption{Modelagem 3d da base do robô}
	\label{fig:base_robo_3d}
\end{figure}

\begin{figure}[h]
	\centering
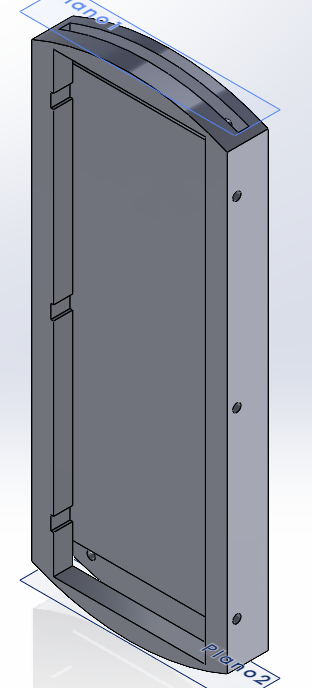
[picture p122: latex_doc/TGII/figures/3d_2.png]
	
	\caption{Modelagem 3d do suporte do protoboard}
	\label{fig:suport_protoboard_3d}
\end{figure}

\begin{figure}[h]
	\centering
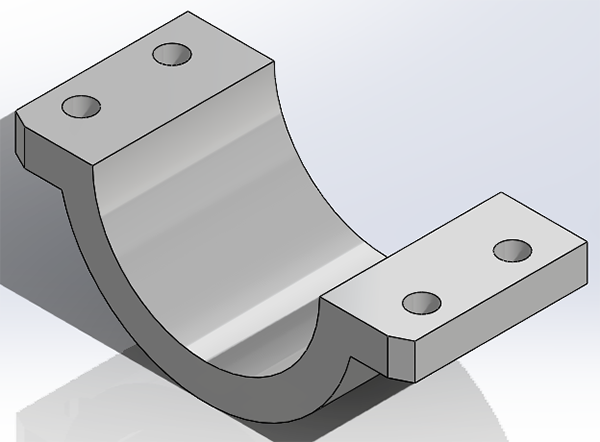
[picture p123: latex_doc/TGII/figures/3d_3.png]
	
	\caption{Modelagem 3d dos mancais}
	\label{fig:mancais_3d}
\end{figure}

\begin{figure}[h]
	\centering
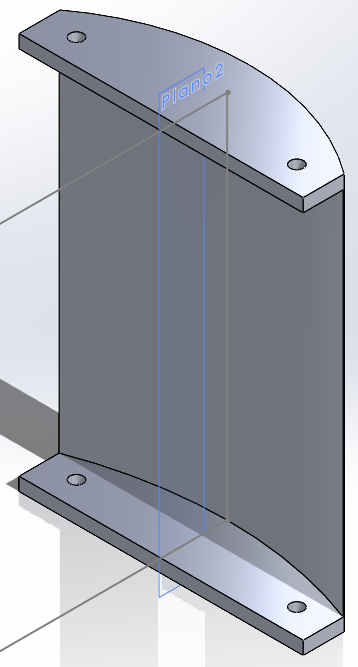
[picture p124: latex_doc/TGII/figures/3d_4.png]
	
	\caption{Modelagem 3d peça de junção}
	\label{fig:peca_juncao_3d}
\end{figure}

\chapter{Impressão e montagem}
\label{att_fabricao_montagem_impressao}

\begin{figure}[h]
	\centering
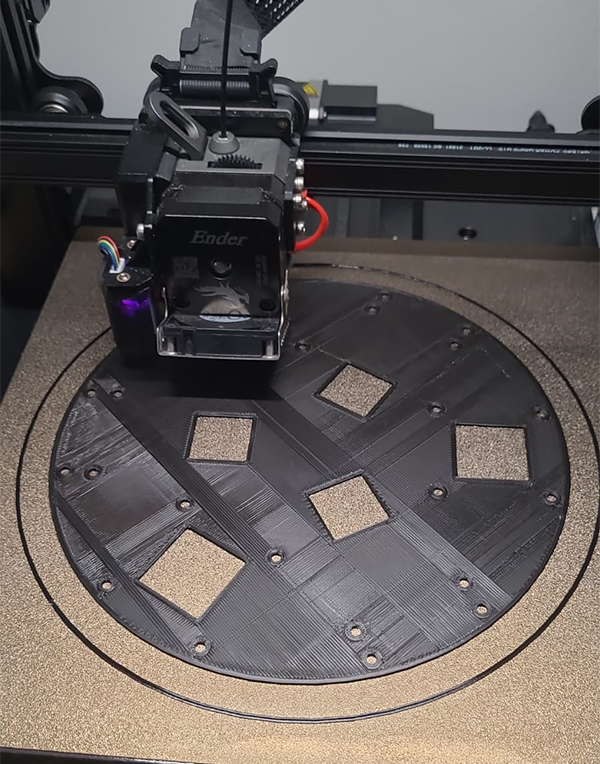
[picture p125: latex_doc/TGII/figures/impressao.png]
	
	\caption{Impressão das peças}
	\label{fig:impressao}
\end{figure}

\begin{figure}[h]
	\centering
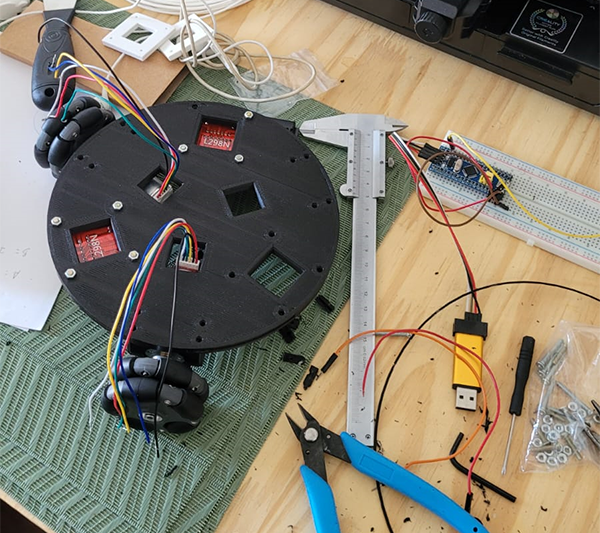
[picture p126: latex_doc/TGIII/figures/montagem_1.png]
	
	\caption{Montagem 1}
	\label{fig:montagem}
\end{figure}

\begin{figure}[h]
	\centering
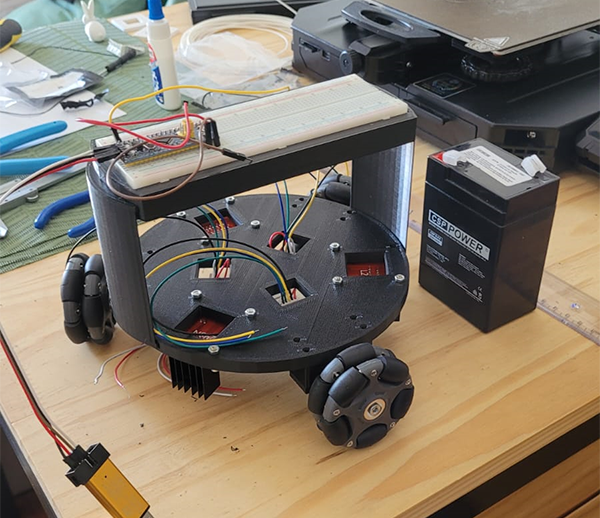
[picture p127: latex_doc/TGIII/figures/montagem_2.png]
	
	\caption{Montagem 2}
	\label{fig:montagem_2}
\end{figure}

\begin{figure}[h]
	\centering
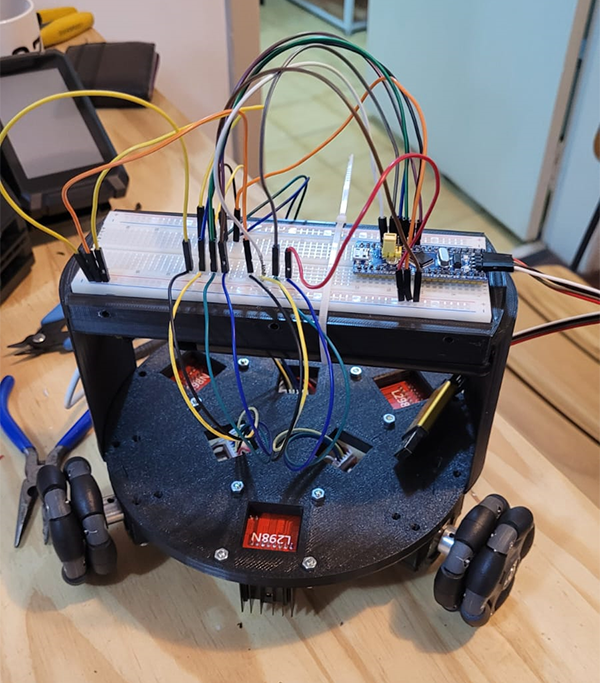
[picture p128: latex_doc/TGII/figures/montagem_3.png]
	
	\caption{Montagem 3}
	\label{fig:montagem_3}
\end{figure}

\begin{figure}[h]
	\centering
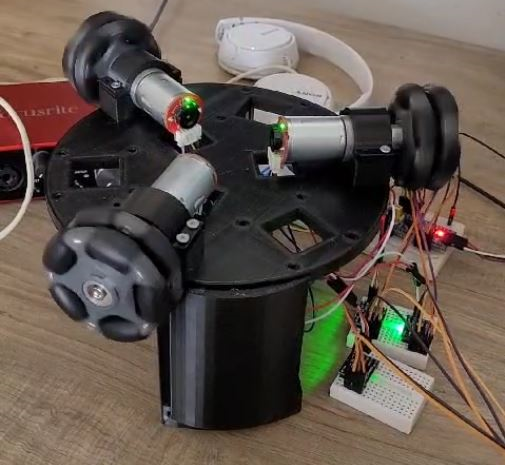
[picture p129: latex_doc/TGII/figures/montagem_4.png]
	
	\caption{Testes dos motores}
	\label{fig:montagem_4}
\end{figure}
