dcarve/tg-robot/latex_doc/TGIII/chapters/metodologia/fabricacao.tex

\section{Fabricação} \label{secao_fabricacao}

\lipsum[1]
