dcarve/tg-robot/latex_doc/TGII/figures/printing_preview_1.png

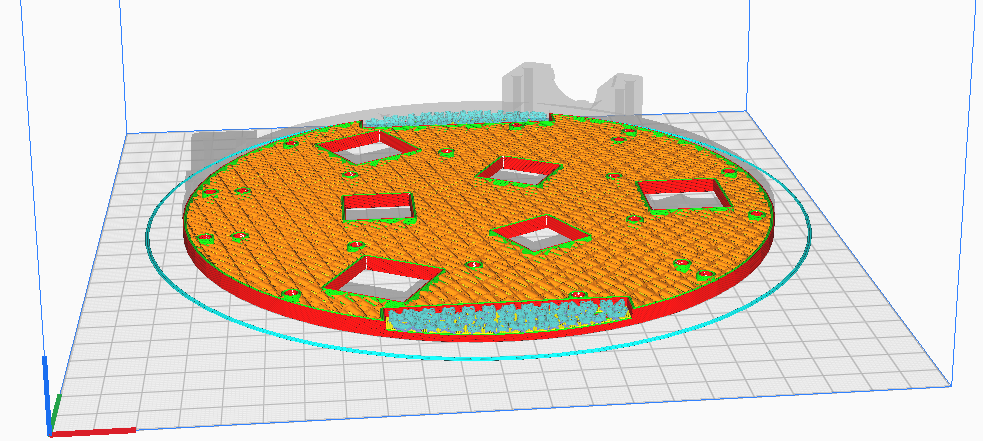
latex_doc/TGII/figures/printing_preview_1.png
