dcarve/tg-robot/latex_doc/TGII/figures/printing_preview_2.png

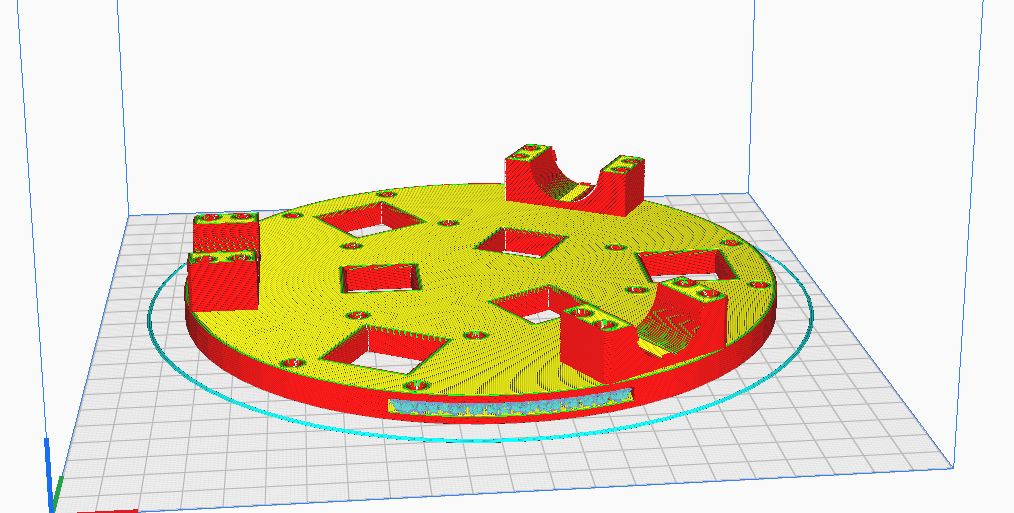
latex_doc/TGII/figures/printing_preview_2.png
