dcarve/tg-robot/latex_doc/TGIII/chapters/resultados_e_discussao.tex

\chapter{Resultados e Discussão}

\lipsum[1]
