dcarve/tg-robot/miscelania/python/old_Datas/results.txt

14:22:33.509 -> {"millis":2117777,"rpm1":112.31,"filterRpm_1":102.00,"w1":20185,"rpm2":112.31,"filterRpm_2":111.11,"w2":20185,"rpm3":96.27,"filterRpm_3":93.54,"w3":20185}
14:22:33.509 -> {"millis":2117787,"rpm1":96.26,"filterRpm_1":102.27,"w1":20165,"rpm2":112.30,"filterRpm_2":111.25,"w2":20165,"rpm3":96.26,"filterRpm_3":93.86,"w3":20165}
14:22:33.554 -> {"millis":2117797,"rpm1":112.29,"filterRpm_1":102.51,"w1":20145,"rpm2":112.29,"filterRpm_2":111.38,"w2":20145,"rpm3":112.29,"filterRpm_3":95.09,"w3":20145}
14:22:33.554 -> {"millis":2117807,"rpm1":112.30,"filterRpm_1":103.67,"w1":20125,"rpm2":128.34,"filterRpm_2":112.43,"w2":20125,"rpm3":96.26,"filterRpm_3":96.18,"w3":20125}
14:22:33.554 -> {"millis":2117817,"rpm1":96.27,"filterRpm_1":103.74,"w1":20105,"rpm2":112.31,"filterRpm_2":113.37,"w2":20105,"rpm3":96.27,"filterRpm_3":96.19,"w3":20105}
14:22:33.554 -> {"millis":2117827,"rpm1":112.30,"filterRpm_1":103.80,"w1":20085,"rpm2":112.30,"filterRpm_2":113.24,"w2":20085,"rpm3":96.26,"filterRpm_3":96.20,"w3":20085}
14:22:33.554 -> {"millis":2117837,"rpm1":96.26,"filterRpm_1":103.86,"w1":20065,"rpm2":112.30,"filterRpm_2":113.13,"w2":20065,"rpm3":96.26,"filterRpm_3":96.21,"w3":20065}
14:22:33.600 -> {"millis":2117847,"rpm1":112.29,"filterRpm_1":103.91,"w1":20045,"rpm2":112.29,"filterRpm_2":113.03,"w2":20045,"rpm3":96.25,"filterRpm_3":96.21,"w3":20045}
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
14:22:35.724 -> {"millis":2120007,"rpm1":80.22,"filterRpm_1":80.35,"w1":15735,"rpm2":96.27,"filterRpm_2":98.90,"w2":15735,"rpm3":80.22,"filterRpm_3":83.78,"w3":15735}
14:22:35.770 -> {"millis":2120017,"rpm1":80.21,"filterRpm_1":80.33,"w1":15715,"rpm2":96.26,"filterRpm_2":98.59,"w2":15715,"rpm3":96.26,"filterRpm_3":84.31,"w3":15715}
14:22:35.770 -> {"millis":2120027,"rpm1":80.21,"filterRpm_1":80.32,"w1":15695,"rpm2":96.26,"filterRpm_2":98.32,"w2":15695,"rpm3":80.21,"filterRpm_3":84.77,"w3":15695}
14:22:35.770 -> {"millis":2120037,"rpm1":80.21,"filterRpm_1":80.30,"w1":15675,"rpm2":96.26,"filterRpm_2":98.07,"w2":15675,"rpm3":80.21,"filterRpm_3":84.23,"w3":15675}
14:22:35.770 -> {"millis":2120047,"rpm1":80.21,"filterRpm_1":80.29,"w1":15655,"rpm2":96.26,"filterRpm_2":97.86,"w2":15655,"rpm3":80.21,"filterRpm_3":83.76,"w3":15655}
14:22:35.815 -> {"millis":2120057,"rpm1":80.21,"filterRpm_1":80.28,"w1":15635,"rpm2":96.26,"filterRpm_2":97.67,"w2":15635,"rpm3":80.21,"filterRpm_3":83.34,"w3":15635}
14:22:35.815 -> {"millis":2120067,"rpm1":80.21,"filterRpm_1":80.28,"w1":15615,"rpm2":96.26,"filterRpm_2":97.50,"w2":15615,"rpm3":80.21,"filterRpm_3":82.97,"w3":15615}
14:22:35.815 -> {"millis":2120077,"rpm1":80.21,"filterRpm_1":80.27,"w1":15595,"rpm2":96.26,"filterRpm_2":97.35,"w2":15595,"rpm3":80.21,"filterRpm_3":82.64,"w3":15595}
14:22:35.815 -> {"millis":2120087,"rpm1":80.21,"filterRpm_1":80.26,"w1":15575,"rpm2":96.26,"filterRpm_2":97.22,"w2":15575,"rpm3":96.26,"filterRpm_3":83.31,"w3":15575}
14:22:35.815 -> {"millis":2120097,"rpm1":80.21,"filterRpm_1":80.26,"w1":15555,"rpm2":80.21,"filterRpm_2":96.16,"w2":15555,"rpm3":80.21,"filterRpm_3":83.89,"w3":15555}
14:22:35.861 -> {"millis":2120107,"rpm1":64.17,"filterRpm_1":79.30,"w1":15535,"rpm2":96.26,"filterRpm_2":95.22,"w2":15535,"rpm3":80.21,"filterRpm_3":83.45,"w3":15535}
14:22:35.861 -> {"millis":2120117,"rpm1":80.21,"filterRpm_1":78.46,"w1":15515,"rpm2":96.25,"filterRpm_2":95.35,"w2":15515,"rpm3":80.21,"filterRpm_3":83.07,"w3":15515}
14:22:35.861 -> {"millis":2120127,"rpm1":80.22,"filterRpm_1":78.67,"w1":15495,"rpm2":96.27,"filterRpm_2":95.45,"w2":15495,"rpm3":80.22,"filterRpm_3":82.73,"w3":15495}
14:22:35.861 -> {"millis":2120137,"rpm1":80.21,"filterRpm_1":78.85,"w1":15475,"rpm2":96.26,"filterRpm_2":95.55,"w2":15475,"rpm3":80.21,"filterRpm_3":82.44,"w3":15475}
14:22:35.908 -> {"millis":2120147,"rpm1":80.21,"filterRpm_1":79.01,"w1":15455,"rpm2":96.26,"filterRpm_2":95.63,"w2":15455,"rpm3":80.21,"filterRpm_3":82.17,"w3":15455}
14:22:35.908 -> {"millis":2120157,"rpm1":80.21,"filterRpm_1":79.15,"w1":15435,"rpm2":96.26,"filterRpm_2":95.71,"w2":15435,"rpm3":80.21,"filterRpm_3":81.94,"w3":15435}
14:22:35.908 -> {"millis":2120167,"rpm1":80.21,"filterRpm_1":79.28,"w1":15415,"rpm2":96.25,"filterRpm_2":95.77,"w2":15415,"rpm3":80.21,"filterRpm_3":81.74,"w3":15415}
14:22:35.908 -> {"millis":2120177,"rpm1":64.18,"filterRpm_1":78.44,"w1":15395,"rpm2":96.27,"filterRpm_2":95.83,"w2":15395,"rpm3":80.22,"filterRpm_3":81.56,"w3":15395}
14:22:35.908 -> {"millis":2120187,"rpm1":80.21,"filterRpm_1":77.70,"w1":15375,"rpm2":96.26,"filterRpm_2":95.88,"w2":15375,"rpm3":80.21,"filterRpm_3":81.40,"w3":15375}
14:22:35.954 -> {"millis":2120197,"rpm1":80.21,"filterRpm_1":78.00,"w1":15355,"rpm2":80.21,"filterRpm_2":94.98,"w2":15355,"rpm3":80.21,"filterRpm_3":81.26,"w3":15355}
14:22:35.954 -> {"millis":2120207,"rpm1":80.21,"filterRpm_1":78.26,"w1":15335,"rpm2":96.26,"filterRpm_2":94.18,"w2":15335,"rpm3":80.21,"filterRpm_3":81.13,"w3":15335}
14:22:35.954 -> {"millis":2120217,"rpm1":64.16,"filterRpm_1":77.54,"w1":15315,"rpm2":96.25,"filterRpm_2":94.42,"w2":15315,"rpm3":80.21,"filterRpm_3":81.03,"w3":15315}
14:22:35.954 -> {"millis":2120227,"rpm1":80.22,"filterRpm_1":76.91,"w1":15295,"rpm2":96.27,"filterRpm_2":94.64,"w2":15295,"rpm3":80.22,"filterRpm_3":80.93,"w3":15295}
14:22:35.954 -> {"millis":2120237,"rpm1":80.21,"filterRpm_1":77.30,"w1":15275,"rpm2":96.26,"filterRpm_2":94.83,"w2":15275,"rpm3":80.21,"filterRpm_3":80.85,"w3":15275}
14:22:35.999 -> {"millis":2120247,"rpm1":80.21,"filterRpm_1":77.65,"w1":15255,"rpm2":80.21,"filterRpm_2":94.05,"w2":15255,"rpm3":80.21,"filterRpm_3":80.77,"w3":15255}
14:22:35.999 -> {"millis":2120257,"rpm1":64.17,"filterRpm_1":77.00,"w1":15235,"rpm2":96.26,"filterRpm_2":93.36,"w2":15235,"rpm3":80.21,"filterRpm_3":80.70,"w3":15235}
14:22:35.999 -> {"millis":2120267,"rpm1":80.21,"filterRpm_1":76.43,"w1":15215,"rpm2":96.26,"filterRpm_2":93.71,"w2":15215,"rpm3":80.21,"filterRpm_3":80.65,"w3":15215}
14:22:35.999 -> {"millis":2120277,"rpm1":80.21,"filterRpm_1":76.88,"w1":15195,"rpm2":96.26,"filterRpm_2":94.01,"w2":15195,"rpm3":80.21,"filterRpm_3":80.60,"w3":15195}
14:22:36.046 -> {"millis":2120287,"rpm1":80.21,"filterRpm_1":77.27,"w1":15175,"rpm2":80.21,"filterRpm_2":93.33,"w2":15175,"rpm3":64.17,"filterRpm_3":79.60,"w3":15175}
14:22:36.046 -> {"millis":2120297,"rpm1":64.16,"filterRpm_1":76.67,"w1":15155,"rpm2":96.25,"filterRpm_2":92.72,"w2":15155,"rpm3":80.21,"filterRpm_3":78.73,"w3":15155}
14:22:36.046 -> {"millis":2120307,"rpm1":80.22,"filterRpm_1":76.14,"w1":15135,"rpm2":96.27,"filterRpm_2":93.14,"w2":15135,"rpm3":80.22,"filterRpm_3":78.90,"w3":15135}
14:22:36.046 -> {"millis":2120317,"rpm1":80.21,"filterRpm_1":76.62,"w1":15115,"rpm2":80.21,"filterRpm_2":92.56,"w2":15115,"rpm3":80.21,"filterRpm_3":79.06,"w3":15115}
14:22:36.046 -> {"millis":2120327,"rpm1":64.17,"filterRpm_1":76.10,"w1":15095,"rpm2":96.26,"filterRpm_2":92.05,"w2":15095,"rpm3":80.21,"filterRpm_3":79.19,"w3":15095}
14:22:36.092 -> {"millis":2120337,"rpm1":80.22,"filterRpm_1":75.64,"w1":15075,"rpm2":96.27,"filterRpm_2":92.55,"w2":15075,"rpm3":80.22,"filterRpm_3":79.31,"w3":15075}
14:22:36.092 -> {"millis":2120347,"rpm1":64.17,"filterRpm_1":75.23,"w1":15055,"rpm2":80.21,"filterRpm_2":92.04,"w2":15055,"rpm3":80.21,"filterRpm_3":79.42,"w3":15055}
14:22:36.092 -> {"millis":2120357,"rpm1":80.21,"filterRpm_1":74.87,"w1":15035,"rpm2":96.26,"filterRpm_2":91.59,"w2":15035,"rpm3":80.21,"filterRpm_3":79.51,"w3":15035}
14:22:36.092 -> {"millis":2120367,"rpm1":80.21,"filterRpm_1":75.50,"w1":15015,"rpm2":96.26,"filterRpm_2":92.14,"w2":15015,"rpm3":64.17,"filterRpm_3":78.65,"w3":15015}
14:22:36.139 -> {"millis":2120377,"rpm1":64.17,"filterRpm_1":75.11,"w1":14995,"rpm2":80.21,"filterRpm_2":91.68,"w2":14995,"rpm3":80.21,"filterRpm_3":77.89,"w3":14995}
14:22:36.139 -> {"millis":2120387,"rpm1":80.21,"filterRpm_1":74.77,"w1":14975,"rpm2":96.26,"filterRpm_2":91.27,"w2":14975,"rpm3":80.21,"filterRpm_3":78.16,"w3":14975}
14:22:36.139 -> {"millis":2120397,"rpm1":64.17,"filterRpm_1":74.46,"w1":14955,"rpm2":80.21,"filterRpm_2":90.91,"w2":14955,"rpm3":80.21,"filterRpm_3":78.40,"w3":14955}
14:22:36.139 -> {"millis":2120407,"rpm1":80.21,"filterRpm_1":74.19,"w1":14935,"rpm2":96.26,"filterRpm_2":90.60,"w2":14935,"rpm3":80.21,"filterRpm_3":78.62,"w3":14935}
14:22:36.139 -> {"millis":2120417,"rpm1":64.17,"filterRpm_1":73.96,"w1":14915,"rpm2":96.26,"filterRpm_2":91.27,"w2":14915,"rpm3":64.17,"filterRpm_3":77.86,"w3":14915}
14:22:36.185 -> {"millis":2120427,"rpm1":64.16,"filterRpm_1":72.80,"w1":14895,"rpm2":80.21,"filterRpm_2":90.91,"w2":14895,"rpm3":80.21,"filterRpm_3":77.19,"w3":14895}
14:22:36.185 -> {"millis":2120437,"rpm1":80.21,"filterRpm_1":72.73,"w1":14875,"rpm2":96.26,"filterRpm_2":90.59,"w2":14875,"rpm3":80.21,"filterRpm_3":77.54,"w3":14875}
14:22:36.185 -> {"millis":2120447,"rpm1":64.18,"filterRpm_1":72.66,"w1":14855,"rpm2":80.22,"filterRpm_2":90.31,"w2":14855,"rpm3":80.22,"filterRpm_3":77.86,"w3":14855}
14:22:36.185 -> {"millis":2120457,"rpm1":80.21,"filterRpm_1":72.61,"w1":14835,"rpm2":96.26,"filterRpm_2":90.07,"w2":14835,"rpm3":80.21,"filterRpm_3":78.14,"w3":14835}
14:22:36.185 -> {"millis":2120467,"rpm1":64.16,"filterRpm_1":72.56,"w1":14815,"rpm2":80.21,"filterRpm_2":89.85,"w2":14815,"rpm3":64.16,"filterRpm_3":77.44,"w3":14815}
14:22:36.231 -> {"millis":2120477,"rpm1":80.22,"filterRpm_1":72.52,"w1":14795,"rpm2":96.27,"filterRpm_2":89.66,"w2":14795,"rpm3":80.22,"filterRpm_3":76.82,"w3":14795}
14:22:36.231 -> {"millis":2120487,"rpm1":64.16,"filterRpm_1":72.48,"w1":14775,"rpm2":80.21,"filterRpm_2":89.49,"w2":14775,"rpm3":80.21,"filterRpm_3":77.22,"w3":14775}
14:22:36.231 -> {"millis":2120497,"rpm1":80.22,"filterRpm_1":72.44,"w1":14755,"rpm2":96.27,"filterRpm_2":89.34,"w2":14755,"rpm3":80.22,"filterRpm_3":77.57,"w3":14755}
14:22:36.231 -> {"millis":2120507,"rpm1":64.17,"filterRpm_1":72.42,"w1":14735,"rpm2":80.21,"filterRpm_2":89.21,"w2":14735,"rpm3":64.17,"filterRpm_3":76.94,"w3":14735}
14:22:36.278 -> {"millis":2120517,"rpm1":80.21,"filterRpm_1":72.39,"w1":14715,"rpm2":96.26,"filterRpm_2":89.10,"w2":14715,"rpm3":80.21,"filterRpm_3":76.38,"w3":14715}
14:22:36.278 -> {"millis":2120527,"rpm1":64.16,"filterRpm_1":72.37,"w1":14695,"rpm2":80.21,"filterRpm_2":88.99,"w2":14695,"rpm3":80.21,"filterRpm_3":76.83,"w3":14695}
14:22:36.278 -> {"millis":2120537,"rpm1":64.18,"filterRpm_1":71.40,"w1":14675,"rpm2":96.27,"filterRpm_2":88.90,"w2":14675,"rpm3":64.18,"filterRpm_3":76.28,"w3":14675}
14:22:36.278 -> {"millis":2120547,"rpm1":80.21,"filterRpm_1":71.49,"w1":14655,"rpm2":80.21,"filterRpm_2":88.83,"w2":14655,"rpm3":80.21,"filterRpm_3":75.80,"w3":14655}
14:22:36.278 -> {"millis":2120557,"rpm1":64.16,"filterRpm_1":71.57,"w1":14635,"rpm2":96.25,"filterRpm_2":88.76,"w2":14635,"rpm3":80.21,"filterRpm_3":76.32,"w3":14635}
14:22:36.323 -> {"millis":2120567,"rpm1":80.22,"filterRpm_1":71.65,"w1":14615,"rpm2":80.22,"filterRpm_2":88.69,"w2":14615,"rpm3":64.18,"filterRpm_3":75.83,"w3":14615}
14:22:36.323 -> {"millis":2120577,"rpm1":64.17,"filterRpm_1":71.71,"w1":14595,"rpm2":96.26,"filterRpm_2":88.64,"w2":14595,"rpm3":80.21,"filterRpm_3":75.40,"w3":14595}
14:22:36.323 -> {"millis":2120587,"rpm1":80.21,"filterRpm_1":71.77,"w1":14575,"rpm2":80.21,"filterRpm_2":88.59,"w2":14575,"rpm3":80.21,"filterRpm_3":75.97,"w3":14575}
14:22:36.323 -> {"millis":2120597,"rpm1":64.17,"filterRpm_1":71.82,"w1":14555,"rpm2":96.26,"filterRpm_2":88.55,"w2":14555,"rpm3":64.17,"filterRpm_3":75.52,"w3":14555}
14:22:36.323 -> {"millis":2120607,"rpm1":64.17,"filterRpm_1":70.91,"w1":14535,"rpm2":80.21,"filterRpm_2":88.51,"w2":14535,"rpm3":80.21,"filterRpm_3":75.13,"w3":14535}
14:22:36.370 -> {"millis":2120617,"rpm1":80.21,"filterRpm_1":71.07,"w1":14515,"rpm2":80.21,"filterRpm_2":87.53,"w2":14515,"rpm3":64.17,"filterRpm_3":74.78,"w3":14515}
14:22:36.370 -> {"millis":2120627,"rpm1":64.16,"filterRpm_1":71.20,"w1":14495,"rpm2":96.25,"filterRpm_2":87.61,"w2":14495,"rpm3":80.21,"filterRpm_3":74.48,"w3":14495}
14:22:36.370 -> {"millis":2120637,"rpm1":64.18,"filterRpm_1":70.37,"w1":14475,"rpm2":80.22,"filterRpm_2":87.69,"w2":14475,"rpm3":80.22,"filterRpm_3":75.15,"w3":14475}
14:22:36.370 -> {"millis":2120647,"rpm1":80.21,"filterRpm_1":70.58,"w1":14455,"rpm2":96.26,"filterRpm_2":87.75,"w2":14455,"rpm3":64.17,"filterRpm_3":74.80,"w3":14455}
14:22:36.415 -> {"millis":2120657,"rpm1":64.17,"filterRpm_1":70.77,"w1":14435,"rpm2":80.21,"filterRpm_2":87.81,"w2":14435,"rpm3":80.21,"filterRpm_3":74.50,"w3":14435}
14:22:36.415 -> {"millis":2120667,"rpm1":80.21,"filterRpm_1":70.94,"w1":14415,"rpm2":80.21,"filterRpm_2":86.91,"w2":14415,"rpm3":64.16,"filterRpm_3":74.22,"w3":14415}
14:22:36.415 -> {"millis":2120677,"rpm1":64.18,"filterRpm_1":71.09,"w1":14395,"rpm2":96.27,"filterRpm_2":87.07,"w2":14395,"rpm3":80.22,"filterRpm_3":73.98,"w3":14395}
14:22:36.415 -> {"millis":2120687,"rpm1":64.17,"filterRpm_1":70.27,"w1":14375,"rpm2":80.21,"filterRpm_2":87.21,"w2":14375,"rpm3":64.17,"filterRpm_3":73.77,"w3":14375}
14:22:36.415 -> {"millis":2120697,"rpm1":80.21,"filterRpm_1":70.50,"w1":14355,"rpm2":80.21,"filterRpm_2":86.38,"w2":14355,"rpm3":80.21,"filterRpm_3":73.58,"w3":14355}
14:22:36.462 -> {"millis":2120707,"rpm1":64.17,"filterRpm_1":70.70,"w1":14335,"rpm2":96.26,"filterRpm_2":86.60,"w2":14335,"rpm3":80.21,"filterRpm_3":74.37,"w3":14335}
14:22:36.462 -> {"millis":2120717,"rpm1":64.17,"filterRpm_1":69.93,"w1":14315,"rpm2":80.21,"filterRpm_2":86.79,"w2":14315,"rpm3":64.17,"filterRpm_3":74.11,"w3":14315}
14:22:36.462 -> {"millis":2120727,"rpm1":64.17,"filterRpm_1":69.25,"w1":14295,"rpm2":80.21,"filterRpm_2":86.01,"w2":14295,"rpm3":80.21,"filterRpm_3":73.88,"w3":14295}
14:22:36.462 -> {"millis":2120737,"rpm1":80.21,"filterRpm_1":69.59,"w1":14275,"rpm2":80.21,"filterRpm_2":85.33,"w2":14275,"rpm3":64.17,"filterRpm_3":73.68,"w3":14275}
14:22:36.508 -> {"millis":2120747,"rpm1":64.17,"filterRpm_1":69.90,"w1":14255,"rpm2":96.26,"filterRpm_2":85.67,"w2":14255,"rpm3":80.21,"filterRpm_3":73.51,"w3":14255}
14:22:36.508 -> {"millis":2120757,"rpm1":64.17,"filterRpm_1":69.22,"w1":14235,"rpm2":80.21,"filterRpm_2":85.98,"w2":14235,"rpm3":64.17,"filterRpm_3":73.35,"w3":14235}
14:22:36.508 -> {"millis":2120767,"rpm1":80.21,"filterRpm_1":69.58,"w1":14215,"rpm2":80.21,"filterRpm_2":85.29,"w2":14215,"rpm3":64.17,"filterRpm_3":72.27,"w3":14215}
14:22:36.508 -> {"millis":2120777,"rpm1":64.17,"filterRpm_1":69.88,"w1":14195,"rpm2":80.21,"filterRpm_2":84.69,"w2":14195,"rpm3":80.21,"filterRpm_3":72.26,"w3":14195}
14:22:36.508 -> {"millis":2120787,"rpm1":64.17,"filterRpm_1":69.21,"w1":14175,"rpm2":96.26,"filterRpm_2":85.11,"w2":14175,"rpm3":64.17,"filterRpm_3":72.25,"w3":14175}
14:22:36.554 -> {"millis":2120797,"rpm1":64.17,"filterRpm_1":68.61,"w1":14155,"rpm2":80.21,"filterRpm_2":85.48,"w2":14155,"rpm3":80.21,"filterRpm_3":72.24,"w3":14155}
14:22:36.554 -> {"millis":2120807,"rpm1":80.21,"filterRpm_1":69.04,"w1":14135,"rpm2":80.21,"filterRpm_2":84.86,"w2":14135,"rpm3":64.17,"filterRpm_3":72.24,"w3":14135}
14:22:36.554 -> {"millis":2120817,"rpm1":64.17,"filterRpm_1":69.41,"w1":14115,"rpm2":80.21,"filterRpm_2":84.31,"w2":14115,"rpm3":80.21,"filterRpm_3":72.23,"w3":14115}
14:22:36.554 -> {"millis":2120827,"rpm1":64.17,"filterRpm_1":68.79,"w1":14095,"rpm2":96.26,"filterRpm_2":84.77,"w2":14095,"rpm3":64.17,"filterRpm_3":72.23,"w3":14095}
14:22:36.554 -> {"millis":2120837,"rpm1":64.16,"filterRpm_1":68.24,"w1":14075,"rpm2":80.21,"filterRpm_2":85.18,"w2":14075,"rpm3":64.16,"filterRpm_3":71.27,"w3":14075}
14:22:36.599 -> {"millis":2120847,"rpm1":80.22,"filterRpm_1":68.71,"w1":14055,"rpm2":80.22,"filterRpm_2":84.59,"w2":14055,"rpm3":80.22,"filterRpm_3":71.38,"w3":14055}
14:22:36.599 -> {"millis":2120857,"rpm1":64.17,"filterRpm_1":69.12,"w1":14035,"rpm2":80.21,"filterRpm_2":84.08,"w2":14035,"rpm3":64.17,"filterRpm_3":71.48,"w3":14035}
14:22:36.599 -> {"millis":2120867,"rpm1":64.17,"filterRpm_1":68.54,"w1":14015,"rpm2":80.21,"filterRpm_2":83.62,"w2":14015,"rpm3":64.17,"filterRpm_3":70.62,"w3":14015}
14:22:36.599 -> {"millis":2120877,"rpm1":64.17,"filterRpm_1":68.02,"w1":13995,"rpm2":80.21,"filterRpm_2":83.22,"w2":13995,"rpm3":80.21,"filterRpm_3":70.80,"w3":13995}
14:22:36.645 -> {"millis":2120887,"rpm1":64.17,"filterRpm_1":67.57,"w1":13975,"rpm2":80.21,"filterRpm_2":82.86,"w2":13975,"rpm3":64.17,"filterRpm_3":70.97,"w3":13975}
14:22:36.645 -> {"millis":2120897,"rpm1":64.17,"filterRpm_1":67.16,"w1":13955,"rpm2":80.21,"filterRpm_2":82.55,"w2":13955,"rpm3":64.17,"filterRpm_3":70.16,"w3":13955}
14:22:36.645 -> {"millis":2120907,"rpm1":80.21,"filterRpm_1":67.76,"w1":13935,"rpm2":80.21,"filterRpm_2":82.27,"w2":13935,"rpm3":80.21,"filterRpm_3":70.40,"w3":13935}
14:22:36.645 -> {"millis":2120917,"rpm1":64.17,"filterRpm_1":68.28,"w1":13915,"rpm2":80.21,"filterRpm_2":82.03,"w2":13915,"rpm3":64.17,"filterRpm_3":70.61,"w3":13915}
14:22:36.645 -> {"millis":2120927,"rpm1":64.16,"filterRpm_1":67.80,"w1":13895,"rpm2":80.21,"filterRpm_2":81.81,"w2":13895,"rpm3":64.16,"filterRpm_3":69.85,"w3":13895}
14:22:36.691 -> {"millis":2120937,"rpm1":64.18,"filterRpm_1":67.37,"w1":13875,"rpm2":80.22,"filterRpm_2":81.63,"w2":13875,"rpm3":80.22,"filterRpm_3":70.13,"w3":13875}
14:22:36.691 -> {"millis":2120947,"rpm1":64.17,"filterRpm_1":66.99,"w1":13855,"rpm2":80.21,"filterRpm_2":81.46,"w2":13855,"rpm3":64.17,"filterRpm_3":70.37,"w3":13855}
14:22:36.691 -> {"millis":2120957,"rpm1":64.16,"filterRpm_1":66.66,"w1":13835,"rpm2":80.21,"filterRpm_2":81.31,"w2":13835,"rpm3":64.16,"filterRpm_3":69.64,"w3":13835}
14:22:36.691 -> {"millis":2120967,"rpm1":64.18,"filterRpm_1":66.36,"w1":13815,"rpm2":80.22,"filterRpm_2":81.18,"w2":13815,"rpm3":64.18,"filterRpm_3":68.99,"w3":13815}
14:22:36.737 -> {"millis":2120977,"rpm1":64.16,"filterRpm_1":66.10,"w1":13795,"rpm2":80.21,"filterRpm_2":81.07,"w2":13795,"rpm3":80.21,"filterRpm_3":69.37,"w3":13795}
14:22:36.737 -> {"millis":2120987,"rpm1":64.18,"filterRpm_1":65.88,"w1":13775,"rpm2":80.22,"filterRpm_2":80.97,"w2":13775,"rpm3":64.18,"filterRpm_3":69.70,"w3":13775}
14:22:36.737 -> {"millis":2120997,"rpm1":64.17,"filterRpm_1":65.67,"w1":13755,"rpm2":80.21,"filterRpm_2":80.88,"w2":13755,"rpm3":64.17,"filterRpm_3":69.05,"w3":13755}
14:22:36.737 -> {"millis":2121007,"rpm1":64.16,"filterRpm_1":65.50,"w1":13735,"rpm2":80.21,"filterRpm_2":80.80,"w2":13735,"rpm3":64.16,"filterRpm_3":68.47,"w3":13735}
14:22:36.737 -> {"millis":2121017,"rpm1":64.18,"filterRpm_1":65.34,"w1":13715,"rpm2":80.22,"filterRpm_2":80.73,"w2":13715,"rpm3":80.22,"filterRpm_3":68.91,"w3":13715}
14:22:36.784 -> {"millis":2121027,"rpm1":64.17,"filterRpm_1":65.20,"w1":13695,"rpm2":80.21,"filterRpm_2":80.67,"w2":13695,"rpm3":64.17,"filterRpm_3":69.30,"w3":13695}
14:22:36.784 -> {"millis":2121037,"rpm1":64.17,"filterRpm_1":65.08,"w1":13675,"rpm2":80.21,"filterRpm_2":80.62,"w2":13675,"rpm3":64.17,"filterRpm_3":68.69,"w3":13675}
14:22:36.784 -> {"millis":2121047,"rpm1":64.16,"filterRpm_1":64.97,"w1":13655,"rpm2":80.21,"filterRpm_2":80.57,"w2":13655,"rpm3":64.16,"filterRpm_3":68.16,"w3":13655}
14:22:36.784 -> {"millis":2121057,"rpm1":64.18,"filterRpm_1":64.88,"w1":13635,"rpm2":80.22,"filterRpm_2":80.53,"w2":13635,"rpm3":64.18,"filterRpm_3":67.69,"w3":13635}
14:22:36.784 -> {"millis":2121067,"rpm1":48.13,"filterRpm_1":63.85,"w1":13615,"rpm2":80.21,"filterRpm_2":80.49,"w2":13615,"rpm3":64.17,"filterRpm_3":67.27,"w3":13615}
14:22:36.830 -> {"millis":2121077,"rpm1":64.16,"filterRpm_1":62.94,"w1":13595,"rpm2":80.21,"filterRpm_2":80.46,"w2":13595,"rpm3":80.21,"filterRpm_3":67.85,"w3":13595}
14:22:36.830 -> {"millis":2121087,"rpm1":64.18,"filterRpm_1":63.08,"w1":13575,"rpm2":64.18,"filterRpm_2":79.48,"w2":13575,"rpm3":64.18,"filterRpm_3":68.37,"w3":13575}
14:22:36.830 -> {"millis":2121097,"rpm1":64.17,"filterRpm_1":63.21,"w1":13555,"rpm2":80.21,"filterRpm_2":78.62,"w2":13555,"rpm3":64.17,"filterRpm_3":67.87,"w3":13555}
14:22:36.830 -> {"millis":2121107,"rpm1":64.17,"filterRpm_1":63.32,"w1":13535,"rpm2":80.21,"filterRpm_2":78.81,"w2":13535,"rpm3":64.17,"filterRpm_3":67.43,"w3":13535}
14:22:36.876 -> {"millis":2121117,"rpm1":64.17,"filterRpm_1":63.42,"w1":13515,"rpm2":80.21,"filterRpm_2":78.97,"w2":13515,"rpm3":64.17,"filterRpm_3":67.05,"w3":13515}
14:22:36.876 -> {"millis":2121127,"rpm1":64.16,"filterRpm_1":63.51,"w1":13495,"rpm2":80.21,"filterRpm_2":79.12,"w2":13495,"rpm3":64.16,"filterRpm_3":66.71,"w3":13495}
14:22:36.876 -> {"millis":2121137,"rpm1":48.13,"filterRpm_1":62.64,"w1":13475,"rpm2":64.18,"filterRpm_2":78.30,"w2":13475,"rpm3":64.18,"filterRpm_3":66.41,"w3":13475}
14:22:36.876 -> {"millis":2121147,"rpm1":64.17,"filterRpm_1":61.87,"w1":13455,"rpm2":80.21,"filterRpm_2":77.58,"w2":13455,"rpm3":64.17,"filterRpm_3":66.14,"w3":13455}
14:22:36.876 -> {"millis":2121157,"rpm1":64.17,"filterRpm_1":62.15,"w1":13435,"rpm2":80.21,"filterRpm_2":77.89,"w2":13435,"rpm3":64.17,"filterRpm_3":65.91,"w3":13435}
14:22:36.922 -> {"millis":2121167,"rpm1":64.17,"filterRpm_1":62.39,"w1":13415,"rpm2":80.21,"filterRpm_2":78.16,"w2":13415,"rpm3":64.17,"filterRpm_3":65.70,"w3":13415}
14:22:36.922 -> {"millis":2121177,"rpm1":48.13,"filterRpm_1":61.65,"w1":13395,"rpm2":64.17,"filterRpm_2":77.46,"w2":13395,"rpm3":80.21,"filterRpm_3":66.47,"w3":13395}
14:22:36.922 -> {"millis":2121187,"rpm1":64.16,"filterRpm_1":61.00,"w1":13375,"rpm2":80.21,"filterRpm_2":76.84,"w2":13375,"rpm3":64.16,"filterRpm_3":67.15,"w3":13375}
14:22:36.922 -> {"millis":2121197,"rpm1":64.18,"filterRpm_1":61.37,"w1":13355,"rpm2":80.22,"filterRpm_2":77.23,"w2":13355,"rpm3":64.18,"filterRpm_3":66.80,"w3":13355}
14:22:36.968 -> {"millis":2121207,"rpm1":64.17,"filterRpm_1":61.70,"w1":13335,"rpm2":80.21,"filterRpm_2":77.59,"w2":13335,"rpm3":64.17,"filterRpm_3":66.49,"w3":13335}
14:22:36.968 -> {"millis":2121217,"rpm1":48.13,"filterRpm_1":61.05,"w1":13315,"rpm2":64.17,"filterRpm_2":76.95,"w2":13315,"rpm3":64.17,"filterRpm_3":66.21,"w3":13315}
14:22:36.968 -> {"millis":2121227,"rpm1":64.17,"filterRpm_1":60.47,"w1":13295,"rpm2":80.21,"filterRpm_2":76.39,"w2":13295,"rpm3":64.17,"filterRpm_3":65.97,"w3":13295}
14:22:36.968 -> {"millis":2121237,"rpm1":64.17,"filterRpm_1":60.91,"w1":13275,"rpm2":80.21,"filterRpm_2":76.84,"w2":13275,"rpm3":48.13,"filterRpm_3":64.81,"w3":13275}
14:22:36.968 -> {"millis":2121247,"rpm1":64.16,"filterRpm_1":61.29,"w1":13255,"rpm2":64.16,"filterRpm_2":76.29,"w2":13255,"rpm3":64.16,"filterRpm_3":63.79,"w3":13255}
14:22:37.014 -> {"millis":2121257,"rpm1":48.13,"filterRpm_1":60.68,"w1":13235,"rpm2":80.22,"filterRpm_2":75.81,"w2":13235,"rpm3":64.18,"filterRpm_3":63.83,"w3":13235}
14:22:37.014 -> {"millis":2121267,"rpm1":64.17,"filterRpm_1":60.15,"w1":13215,"rpm2":80.21,"filterRpm_2":76.33,"w2":13215,"rpm3":64.17,"filterRpm_3":63.87,"w3":13215}
14:22:37.014 -> {"millis":2121277,"rpm1":64.17,"filterRpm_1":60.62,"w1":13195,"rpm2":64.17,"filterRpm_2":75.84,"w2":13195,"rpm3":64.17,"filterRpm_3":63.91,"w3":13195}
14:22:37.014 -> {"millis":2121287,"rpm1":48.12,"filterRpm_1":60.09,"w1":13175,"rpm2":80.21,"filterRpm_2":75.41,"w2":13175,"rpm3":64.16,"filterRpm_3":63.94,"w3":13175}
14:22:37.014 -> {"millis":2121297,"rpm1":64.18,"filterRpm_1":59.63,"w1":13155,"rpm2":80.22,"filterRpm_2":75.98,"w2":13155,"rpm3":64.18,"filterRpm_3":63.97,"w3":13155}
14:22:37.061 -> {"millis":2121307,"rpm1":64.17,"filterRpm_1":60.17,"w1":13135,"rpm2":64.17,"filterRpm_2":75.53,"w2":13135,"rpm3":64.17,"filterRpm_3":63.99,"w3":13135}
14:22:37.061 -> {"millis":2121317,"rpm1":48.13,"filterRpm_1":59.69,"w1":13115,"rpm2":80.21,"filterRpm_2":75.13,"w2":13115,"rpm3":64.17,"filterRpm_3":64.01,"w3":13115}
14:22:37.061 -> {"millis":2121327,"rpm1":64.17,"filterRpm_1":59.27,"w1":13095,"rpm2":64.17,"filterRpm_2":74.79,"w2":13095,"rpm3":64.17,"filterRpm_3":64.03,"w3":13095}
14:22:37.061 -> {"millis":2121337,"rpm1":48.13,"filterRpm_1":58.90,"w1":13075,"rpm2":80.21,"filterRpm_2":74.48,"w2":13075,"rpm3":64.17,"filterRpm_3":64.05,"w3":13075}
14:22:37.107 -> {"millis":2121347,"rpm1":64.17,"filterRpm_1":58.58,"w1":13055,"rpm2":80.21,"filterRpm_2":75.16,"w2":13055,"rpm3":48.13,"filterRpm_3":63.11,"w3":13055}
14:22:37.107 -> {"millis":2121357,"rpm1":48.13,"filterRpm_1":58.29,"w1":13035,"rpm2":64.17,"filterRpm_2":74.81,"w2":13035,"rpm3":64.17,"filterRpm_3":62.29,"w3":13035}
14:22:37.107 -> {"millis":2121367,"rpm1":64.17,"filterRpm_1":58.04,"w1":13015,"rpm2":80.21,"filterRpm_2":74.50,"w2":13015,"rpm3":64.17,"filterRpm_3":62.51,"w3":13015}
14:22:37.107 -> {"millis":2121377,"rpm1":64.17,"filterRpm_1":58.76,"w1":12995,"rpm2":64.17,"filterRpm_2":74.23,"w2":12995,"rpm3":64.17,"filterRpm_3":62.71,"w3":12995}
14:22:37.107 -> {"millis":2121387,"rpm1":48.13,"filterRpm_1":58.45,"w1":12975,"rpm2":80.21,"filterRpm_2":73.98,"w2":12975,"rpm3":64.17,"filterRpm_3":62.88,"w3":12975}
14:22:37.154 -> {"millis":2121397,"rpm1":64.17,"filterRpm_1":58.18,"w1":12955,"rpm2":64.17,"filterRpm_2":73.77,"w2":12955,"rpm3":48.13,"filterRpm_3":62.09,"w3":12955}
14:22:37.154 -> {"millis":2121407,"rpm1":48.13,"filterRpm_1":57.94,"w1":12935,"rpm2":80.21,"filterRpm_2":73.59,"w2":12935,"rpm3":64.17,"filterRpm_3":61.38,"w3":12935}
14:22:37.154 -> {"millis":2121417,"rpm1":64.16,"filterRpm_1":57.73,"w1":12915,"rpm2":64.16,"filterRpm_2":73.42,"w2":12915,"rpm3":64.16,"filterRpm_3":61.71,"w3":12915}
14:22:37.154 -> {"millis":2121427,"rpm1":48.13,"filterRpm_1":57.54,"w1":12895,"rpm2":80.22,"filterRpm_2":73.28,"w2":12895,"rpm3":64.18,"filterRpm_3":62.00,"w3":12895}
14:22:37.154 -> {"millis":2121437,"rpm1":64.17,"filterRpm_1":57.38,"w1":12875,"rpm2":64.17,"filterRpm_2":73.15,"w2":12875,"rpm3":48.13,"filterRpm_3":61.31,"w3":12875}
14:22:37.200 -> {"millis":2121447,"rpm1":48.13,"filterRpm_1":57.23,"w1":12855,"rpm2":80.21,"filterRpm_2":73.04,"w2":12855,"rpm3":64.17,"filterRpm_3":60.70,"w3":12855}
14:22:37.200 -> {"millis":2121457,"rpm1":64.17,"filterRpm_1":57.10,"w1":12835,"rpm2":64.17,"filterRpm_2":72.94,"w2":12835,"rpm3":64.17,"filterRpm_3":61.11,"w3":12835}
14:22:37.200 -> {"millis":2121467,"rpm1":48.13,"filterRpm_1":56.99,"w1":12815,"rpm2":80.21,"filterRpm_2":72.85,"w2":12815,"rpm3":64.17,"filterRpm_3":61.47,"w3":12815}
14:22:37.200 -> {"millis":2121477,"rpm1":64.17,"filterRpm_1":56.89,"w1":12795,"rpm2":64.17,"filterRpm_2":72.77,"w2":12795,"rpm3":48.13,"filterRpm_3":60.84,"w3":12795}
14:22:37.246 -> {"millis":2121487,"rpm1":48.13,"filterRpm_1":56.80,"w1":12775,"rpm2":64.17,"filterRpm_2":71.75,"w2":12775,"rpm3":64.17,"filterRpm_3":60.29,"w3":12775}
14:22:37.246 -> {"millis":2121497,"rpm1":64.17,"filterRpm_1":56.73,"w1":12755,"rpm2":80.21,"filterRpm_2":71.81,"w2":12755,"rpm3":64.17,"filterRpm_3":60.75,"w3":12755}
14:22:37.246 -> {"millis":2121507,"rpm1":48.13,"filterRpm_1":56.66,"w1":12735,"rpm2":64.17,"filterRpm_2":71.85,"w2":12735,"rpm3":48.13,"filterRpm_3":60.20,"w3":12735}
14:22:37.246 -> {"millis":2121517,"rpm1":48.13,"filterRpm_1":55.65,"w1":12715,"rpm2":80.21,"filterRpm_2":71.89,"w2":12715,"rpm3":64.17,"filterRpm_3":59.72,"w3":12715}
14:22:37.246 -> {"millis":2121527,"rpm1":64.17,"filterRpm_1":55.71,"w1":12695,"rpm2":64.17,"filterRpm_2":71.93,"w2":12695,"rpm3":64.17,"filterRpm_3":60.25,"w3":12695}
14:22:37.292 -> {"millis":2121537,"rpm1":48.13,"filterRpm_1":55.76,"w1":12675,"rpm2":64.17,"filterRpm_2":71.01,"w2":12675,"rpm3":48.13,"filterRpm_3":59.77,"w3":12675}
14:22:37.292 -> {"millis":2121547,"rpm1":64.17,"filterRpm_1":55.81,"w1":12655,"rpm2":80.21,"filterRpm_2":71.15,"w2":12655,"rpm3":64.17,"filterRpm_3":59.34,"w3":12655}
14:22:37.292 -> {"millis":2121557,"rpm1":48.13,"filterRpm_1":55.85,"w1":12635,"rpm2":64.17,"filterRpm_2":71.27,"w2":12635,"rpm3":64.17,"filterRpm_3":59.91,"w3":12635}
14:22:37.292 -> {"millis":2121567,"rpm1":48.13,"filterRpm_1":54.93,"w1":12615,"rpm2":64.17,"filterRpm_2":70.43,"w2":12615,"rpm3":48.13,"filterRpm_3":59.46,"w3":12615}
14:22:37.338 -> {"millis":2121577,"rpm1":64.16,"filterRpm_1":55.08,"w1":12595,"rpm2":80.21,"filterRpm_2":70.64,"w2":12595,"rpm3":64.16,"filterRpm_3":59.07,"w3":12595}
14:22:37.338 -> {"millis":2121587,"rpm1":48.13,"filterRpm_1":55.20,"w1":12575,"rpm2":64.17,"filterRpm_2":70.82,"w2":12575,"rpm3":48.13,"filterRpm_3":58.73,"w3":12575}
14:22:37.338 -> {"millis":2121597,"rpm1":48.13,"filterRpm_1":54.37,"w1":12555,"rpm2":64.18,"filterRpm_2":70.04,"w2":12555,"rpm3":64.18,"filterRpm_3":58.42,"w3":12555}
14:22:37.338 -> {"millis":2121607,"rpm1":64.17,"filterRpm_1":54.58,"w1":12535,"rpm2":64.17,"filterRpm_2":69.34,"w2":12535,"rpm3":48.13,"filterRpm_3":58.15,"w3":12535}
14:22:37.338 -> {"millis":2121617,"rpm1":48.13,"filterRpm_1":54.76,"w1":12515,"rpm2":80.21,"filterRpm_2":69.68,"w2":12515,"rpm3":64.17,"filterRpm_3":57.92,"w3":12515}
14:22:37.384 -> {"millis":2121627,"rpm1":48.13,"filterRpm_1":53.98,"w1":12495,"rpm2":64.17,"filterRpm_2":69.98,"w2":12495,"rpm3":64.17,"filterRpm_3":58.66,"w3":12495}
14:22:37.384 -> {"millis":2121637,"rpm1":64.17,"filterRpm_1":54.24,"w1":12475,"rpm2":64.17,"filterRpm_2":69.29,"w2":12475,"rpm3":48.13,"filterRpm_3":58.36,"w3":12475}
14:22:37.384 -> {"millis":2121647,"rpm1":48.13,"filterRpm_1":54.46,"w1":12455,"rpm2":64.17,"filterRpm_2":68.69,"w2":12455,"rpm3":64.17,"filterRpm_3":58.10,"w3":12455}
14:22:37.384 -> {"millis":2121657,"rpm1":48.13,"filterRpm_1":53.71,"w1":12435,"rpm2":64.17,"filterRpm_2":68.15,"w2":12435,"rpm3":48.13,"filterRpm_3":57.87,"w3":12435}
14:22:37.384 -> {"millis":2121667,"rpm1":64.17,"filterRpm_1":54.00,"w1":12415,"rpm2":80.21,"filterRpm_2":68.63,"w2":12415,"rpm3":48.13,"filterRpm_3":56.72,"w3":12415}
14:22:37.430 -> {"millis":2121677,"rpm1":48.13,"filterRpm_1":54.26,"w1":12395,"rpm2":64.17,"filterRpm_2":69.05,"w2":12395,"rpm3":64.17,"filterRpm_3":56.65,"w3":12395}
14:22:37.430 -> {"millis":2121687,"rpm1":48.12,"filterRpm_1":53.53,"w1":12375,"rpm2":64.16,"filterRpm_2":68.47,"w2":12375,"rpm3":48.12,"filterRpm_3":56.59,"w3":12375}
14:22:37.430 -> {"millis":2121697,"rpm1":48.13,"filterRpm_1":52.89,"w1":12355,"rpm2":64.18,"filterRpm_2":67.96,"w2":12355,"rpm3":64.18,"filterRpm_3":56.54,"w3":12355}
14:22:37.430 -> {"millis":2121707,"rpm1":48.13,"filterRpm_1":52.33,"w1":12335,"rpm2":64.17,"filterRpm_2":67.52,"w2":12335,"rpm3":48.13,"filterRpm_3":56.49,"w3":12335}
14:22:37.476 -> {"millis":2121717,"rpm1":48.12,"filterRpm_1":51.83,"w1":12315,"rpm2":64.16,"filterRpm_2":67.12,"w2":12315,"rpm3":48.12,"filterRpm_3":55.50,"w3":12315}
14:22:37.476 -> {"millis":2121727,"rpm1":48.13,"filterRpm_1":51.39,"w1":12295,"rpm2":64.18,"filterRpm_2":66.77,"w2":12295,"rpm3":64.18,"filterRpm_3":55.58,"w3":12295}
14:22:37.476 -> {"millis":2121737,"rpm1":48.13,"filterRpm_1":51.01,"w1":12275,"rpm2":64.17,"filterRpm_2":66.46,"w2":12275,"rpm3":48.13,"filterRpm_3":55.65,"w3":12275}
14:22:37.476 -> {"millis":2121747,"rpm1":48.12,"filterRpm_1":50.67,"w1":12255,"rpm2":64.16,"filterRpm_2":66.19,"w2":12255,"rpm3":48.12,"filterRpm_3":54.76,"w3":12255}
14:22:37.476 -> {"millis":2121757,"rpm1":48.13,"filterRpm_1":50.37,"w1":12235,"rpm2":64.17,"filterRpm_2":65.95,"w2":12235,"rpm3":48.13,"filterRpm_3":53.97,"w3":12235}
14:22:37.523 -> {"millis":2121767,"rpm1":48.13,"filterRpm_1":50.10,"w1":12215,"rpm2":64.17,"filterRpm_2":65.74,"w2":12215,"rpm3":48.13,"filterRpm_3":53.28,"w3":12215}
14:22:37.523 -> {"millis":2121777,"rpm1":48.13,"filterRpm_1":49.87,"w1":12195,"rpm2":64.18,"filterRpm_2":65.56,"w2":12195,"rpm3":64.18,"filterRpm_3":53.62,"w3":12195}
14:22:37.523 -> {"millis":2121787,"rpm1":48.13,"filterRpm_1":49.66,"w1":12175,"rpm2":64.17,"filterRpm_2":65.39,"w2":12175,"rpm3":48.13,"filterRpm_3":53.92,"w3":12175}
14:22:37.523 -> {"millis":2121797,"rpm1":48.13,"filterRpm_1":49.48,"w1":12155,"rpm2":64.17,"filterRpm_2":65.25,"w2":12155,"rpm3":48.13,"filterRpm_3":53.24,"w3":12155}
14:22:37.523 -> {"millis":2121807,"rpm1":48.13,"filterRpm_1":49.32,"w1":12135,"rpm2":64.17,"filterRpm_2":65.12,"w2":12135,"rpm3":48.13,"filterRpm_3":52.63,"w3":12135}
14:22:37.569 -> {"millis":2121817,"rpm1":48.12,"filterRpm_1":49.18,"w1":12115,"rpm2":64.16,"filterRpm_2":65.01,"w2":12115,"rpm3":48.12,"filterRpm_3":52.10,"w3":12115}
14:22:37.569 -> {"millis":2121827,"rpm1":48.13,"filterRpm_1":49.06,"w1":12095,"rpm2":64.18,"filterRpm_2":64.91,"w2":12095,"rpm3":48.13,"filterRpm_3":51.63,"w3":12095}
14:22:37.569 -> {"millis":2121837,"rpm1":32.09,"filterRpm_1":48.00,"w1":12075,"rpm2":64.17,"filterRpm_2":64.82,"w2":12075,"rpm3":48.13,"filterRpm_3":51.22,"w3":12075}
14:22:37.569 -> {"millis":2121847,"rpm1":48.13,"filterRpm_1":47.07,"w1":12055,"rpm2":64.17,"filterRpm_2":64.75,"w2":12055,"rpm3":48.13,"filterRpm_3":50.85,"w3":12055}
14:22:37.615 -> {"millis":2121857,"rpm1":48.12,"filterRpm_1":47.19,"w1":12035,"rpm2":64.16,"filterRpm_2":64.68,"w2":12035,"rpm3":48.12,"filterRpm_3":50.53,"w3":12035}
14:22:37.615 -> {"millis":2121867,"rpm1":48.13,"filterRpm_1":47.30,"w1":12015,"rpm2":64.18,"filterRpm_2":64.62,"w2":12015,"rpm3":32.09,"filterRpm_3":49.30,"w3":12015}
14:22:37.615 -> {"millis":2121877,"rpm1":48.13,"filterRpm_1":47.40,"w1":11995,"rpm2":64.17,"filterRpm_2":64.57,"w2":11995,"rpm3":48.13,"filterRpm_3":48.21,"w3":11995}
14:22:37.615 -> {"millis":2121887,"rpm1":32.08,"filterRpm_1":46.54,"w1":11975,"rpm2":64.16,"filterRpm_2":64.52,"w2":11975,"rpm3":48.12,"filterRpm_3":48.20,"w3":11975}
14:22:37.615 -> {"millis":2121897,"rpm1":48.13,"filterRpm_1":45.78,"w1":11955,"rpm2":48.13,"filterRpm_2":63.53,"w2":11955,"rpm3":48.13,"filterRpm_3":48.19,"w3":11955}
14:22:37.661 -> {"millis":2121907,"rpm1":48.13,"filterRpm_1":46.05,"w1":11935,"rpm2":64.17,"filterRpm_2":62.66,"w2":11935,"rpm3":32.09,"filterRpm_3":47.24,"w3":11935}
14:22:37.661 -> {"millis":2121917,"rpm1":48.13,"filterRpm_1":46.30,"w1":11915,"rpm2":64.18,"filterRpm_2":62.84,"w2":11915,"rpm3":48.13,"filterRpm_3":46.39,"w3":11915}
14:22:37.661 -> {"millis":2121927,"rpm1":32.09,"filterRpm_1":45.57,"w1":11895,"rpm2":64.17,"filterRpm_2":62.99,"w2":11895,"rpm3":48.13,"filterRpm_3":46.60,"w3":11895}
14:22:37.661 -> {"millis":2121937,"rpm1":48.12,"filterRpm_1":44.92,"w1":11875,"rpm2":64.16,"filterRpm_2":63.13,"w2":11875,"rpm3":48.12,"filterRpm_3":46.78,"w3":11875}
14:22:37.707 -> {"millis":2121947,"rpm1":48.13,"filterRpm_1":45.30,"w1":11855,"rpm2":48.13,"filterRpm_2":62.31,"w2":11855,"rpm3":48.13,"filterRpm_3":46.94,"w3":11855}
14:22:37.707 -> {"millis":2121957,"rpm1":48.13,"filterRpm_1":45.64,"w1":11835,"rpm2":64.17,"filterRpm_2":61.58,"w2":11835,"rpm3":32.09,"filterRpm_3":46.13,"w3":11835}
14:22:37.707 -> {"millis":2121967,"rpm1":32.09,"filterRpm_1":44.98,"w1":11815,"rpm2":64.17,"filterRpm_2":61.89,"w2":11815,"rpm3":48.13,"filterRpm_3":45.42,"w3":11815}
14:22:37.707 -> {"millis":2121977,"rpm1":48.13,"filterRpm_1":44.41,"w1":11795,"rpm2":64.18,"filterRpm_2":62.16,"w2":11795,"rpm3":48.13,"filterRpm_3":45.74,"w3":11795}
14:22:37.707 -> {"millis":2121987,"rpm1":48.13,"filterRpm_1":44.85,"w1":11775,"rpm2":48.13,"filterRpm_2":61.45,"w2":11775,"rpm3":48.13,"filterRpm_3":46.02,"w3":11775}
14:22:37.753 -> {"millis":2121997,"rpm1":32.09,"filterRpm_1":44.29,"w1":11755,"rpm2":64.17,"filterRpm_2":60.82,"w2":11755,"rpm3":32.09,"filterRpm_3":45.32,"w3":11755}
14:22:37.753 -> {"millis":2122007,"rpm1":48.13,"filterRpm_1":43.79,"w1":11735,"rpm2":64.17,"filterRpm_2":61.22,"w2":11735,"rpm3":48.13,"filterRpm_3":44.71,"w3":11735}
14:22:37.753 -> {"millis":2122017,"rpm1":48.13,"filterRpm_1":44.30,"w1":11715,"rpm2":64.17,"filterRpm_2":61.57,"w2":11715,"rpm3":48.13,"filterRpm_3":45.11,"w3":11715}
14:22:37.753 -> {"millis":2122027,"rpm1":32.09,"filterRpm_1":43.81,"w1":11695,"rpm2":48.13,"filterRpm_2":60.93,"w2":11695,"rpm3":32.09,"filterRpm_3":44.52,"w3":11695}
14:22:37.753 -> {"millis":2122037,"rpm1":48.13,"filterRpm_1":43.37,"w1":11675,"rpm2":64.17,"filterRpm_2":60.36,"w2":11675,"rpm3":48.13,"filterRpm_3":44.00,"w3":11675}
14:22:37.799 -> {"millis":2122047,"rpm1":48.12,"filterRpm_1":43.93,"w1":11655,"rpm2":64.16,"filterRpm_2":60.81,"w2":11655,"rpm3":48.12,"filterRpm_3":44.49,"w3":11655}
14:22:37.799 -> {"millis":2122057,"rpm1":32.09,"filterRpm_1":43.48,"w1":11635,"rpm2":48.13,"filterRpm_2":60.26,"w2":11635,"rpm3":32.09,"filterRpm_3":43.97,"w3":11635}
14:22:37.799 -> {"millis":2122067,"rpm1":48.13,"filterRpm_1":43.08,"w1":11615,"rpm2":64.18,"filterRpm_2":59.77,"w2":11615,"rpm3":48.13,"filterRpm_3":43.51,"w3":11615}
14:22:37.799 -> {"millis":2122077,"rpm1":32.08,"filterRpm_1":42.73,"w1":11595,"rpm2":64.16,"filterRpm_2":60.29,"w2":11595,"rpm3":32.08,"filterRpm_3":43.11,"w3":11595}
14:22:37.845 -> {"millis":2122087,"rpm1":48.13,"filterRpm_1":42.42,"w1":11575,"rpm2":48.13,"filterRpm_2":59.80,"w2":11575,"rpm3":48.13,"filterRpm_3":42.75,"w3":11575}
14:22:37.845 -> {"millis":2122097,"rpm1":32.09,"filterRpm_1":42.15,"w1":11555,"rpm2":64.17,"filterRpm_2":59.37,"w2":11555,"rpm3":48.13,"filterRpm_3":43.39,"w3":11555}
14:22:37.845 -> {"millis":2122107,"rpm1":48.12,"filterRpm_1":41.91,"w1":11535,"rpm2":48.12,"filterRpm_2":58.99,"w2":11535,"rpm3":32.08,"filterRpm_3":43.00,"w3":11535}
14:22:37.845 -> {"millis":2122117,"rpm1":48.13,"filterRpm_1":42.64,"w1":11515,"rpm2":64.17,"filterRpm_2":58.65,"w2":11515,"rpm3":48.13,"filterRpm_3":42.66,"w3":11515}
14:22:37.845 -> {"millis":2122127,"rpm1":32.09,"filterRpm_1":42.34,"w1":11495,"rpm2":48.13,"filterRpm_2":58.36,"w2":11495,"rpm3":32.09,"filterRpm_3":42.36,"w3":11495}
14:22:37.891 -> {"millis":2122137,"rpm1":48.13,"filterRpm_1":42.08,"w1":11475,"rpm2":64.18,"filterRpm_2":58.10,"w2":11475,"rpm3":32.09,"filterRpm_3":41.14,"w3":11475}
14:22:37.891 -> {"millis":2122147,"rpm1":32.09,"filterRpm_1":41.84,"w1":11455,"rpm2":48.13,"filterRpm_2":57.87,"w2":11455,"rpm3":48.13,"filterRpm_3":41.02,"w3":11455}
14:22:37.891 -> {"millis":2122157,"rpm1":48.12,"filterRpm_1":41.64,"w1":11435,"rpm2":64.16,"filterRpm_2":57.66,"w2":11435,"rpm3":32.08,"filterRpm_3":40.91,"w3":11435}
14:22:37.891 -> {"millis":2122167,"rpm1":32.09,"filterRpm_1":41.46,"w1":11415,"rpm2":48.13,"filterRpm_2":57.48,"w2":11415,"rpm3":48.13,"filterRpm_3":40.82,"w3":11415}
14:22:37.937 -> {"millis":2122177,"rpm1":48.13,"filterRpm_1":41.30,"w1":11395,"rpm2":64.18,"filterRpm_2":57.33,"w2":11395,"rpm3":32.09,"filterRpm_3":40.73,"w3":11395}
14:22:37.937 -> {"millis":2122187,"rpm1":32.09,"filterRpm_1":41.16,"w1":11375,"rpm2":48.13,"filterRpm_2":57.19,"w2":11375,"rpm3":48.13,"filterRpm_3":40.66,"w3":11375}
14:22:37.937 -> {"millis":2122197,"rpm1":32.09,"filterRpm_1":40.08,"w1":11355,"rpm2":64.17,"filterRpm_2":57.07,"w2":11355,"rpm3":32.09,"filterRpm_3":40.59,"w3":11355}
14:22:37.937 -> {"millis":2122207,"rpm1":48.12,"filterRpm_1":40.09,"w1":11335,"rpm2":48.12,"filterRpm_2":56.96,"w2":11335,"rpm3":32.08,"filterRpm_3":39.59,"w3":11335}
14:22:37.937 -> {"millis":2122217,"rpm1":32.09,"filterRpm_1":40.09,"w1":11315,"rpm2":64.18,"filterRpm_2":56.86,"w2":11315,"rpm3":48.13,"filterRpm_3":39.65,"w3":11315}
14:22:37.983 -> {"millis":2122227,"rpm1":48.13,"filterRpm_1":40.09,"w1":11295,"rpm2":48.13,"filterRpm_2":56.78,"w2":11295,"rpm3":32.09,"filterRpm_3":39.70,"w3":11295}
14:22:37.983 -> {"millis":2122237,"rpm1":32.09,"filterRpm_1":40.09,"w1":11275,"rpm2":64.17,"filterRpm_2":56.70,"w2":11275,"rpm3":32.09,"filterRpm_3":38.80,"w3":11275}
14:22:37.983 -> {"millis":2122247,"rpm1":32.09,"filterRpm_1":39.15,"w1":11255,"rpm2":48.13,"filterRpm_2":56.64,"w2":11255,"rpm3":48.13,"filterRpm_3":38.96,"w3":11255}
14:22:37.983 -> {"millis":2122257,"rpm1":48.12,"filterRpm_1":39.26,"w1":11235,"rpm2":48.12,"filterRpm_2":55.63,"w2":11235,"rpm3":32.08,"filterRpm_3":39.09,"w3":11235}
14:22:37.983 -> {"millis":2122267,"rpm1":32.09,"filterRpm_1":39.36,"w1":11215,"rpm2":64.18,"filterRpm_2":55.69,"w2":11215,"rpm3":32.09,"filterRpm_3":38.26,"w3":11215}
14:22:38.030 -> {"millis":2122277,"rpm1":48.12,"filterRpm_1":39.45,"w1":11195,"rpm2":48.12,"filterRpm_2":55.75,"w2":11195,"rpm3":32.08,"filterRpm_3":37.53,"w3":11195}
14:22:38.030 -> {"millis":2122287,"rpm1":32.09,"filterRpm_1":39.53,"w1":11175,"rpm2":48.13,"filterRpm_2":54.85,"w2":11175,"rpm3":48.13,"filterRpm_3":37.84,"w3":11175}
14:22:38.030 -> {"millis":2122297,"rpm1":32.09,"filterRpm_1":38.65,"w1":11155,"rpm2":64.17,"filterRpm_2":55.00,"w2":11155,"rpm3":32.09,"filterRpm_3":38.11,"w3":11155}
14:22:38.030 -> {"millis":2122307,"rpm1":48.13,"filterRpm_1":38.82,"w1":11135,"rpm2":48.13,"filterRpm_2":55.14,"w2":11135,"rpm3":32.09,"filterRpm_3":37.39,"w3":11135}
14:22:38.076 -> {"millis":2122317,"rpm1":32.09,"filterRpm_1":38.97,"w1":11115,"rpm2":48.13,"filterRpm_2":54.31,"w2":11115,"rpm3":32.09,"filterRpm_3":36.77,"w3":11115}
14:22:38.076 -> {"millis":2122327,"rpm1":32.09,"filterRpm_1":38.16,"w1":11095,"rpm2":64.17,"filterRpm_2":54.53,"w2":11095,"rpm3":32.09,"filterRpm_3":36.21,"w3":11095}
14:22:38.076 -> {"millis":2122337,"rpm1":32.09,"filterRpm_1":37.44,"w1":11075,"rpm2":48.13,"filterRpm_2":54.72,"w2":11075,"rpm3":48.13,"filterRpm_3":36.67,"w3":11075}
14:22:38.076 -> {"millis":2122347,"rpm1":48.12,"filterRpm_1":37.75,"w1":11055,"rpm2":48.12,"filterRpm_2":53.94,"w2":11055,"rpm3":32.08,"filterRpm_3":37.08,"w3":11055}
14:22:38.076 -> {"millis":2122357,"rpm1":32.09,"filterRpm_1":38.03,"w1":11035,"rpm2":48.13,"filterRpm_2":53.25,"w2":11035,"rpm3":32.09,"filterRpm_3":36.49,"w3":11035}
14:22:38.122 -> {"millis":2122367,"rpm1":32.09,"filterRpm_1":37.33,"w1":11015,"rpm2":64.18,"filterRpm_2":53.59,"w2":11015,"rpm3":32.09,"filterRpm_3":35.97,"w3":11015}
14:22:38.122 -> {"millis":2122377,"rpm1":32.09,"filterRpm_1":36.71,"w1":10995,"rpm2":48.13,"filterRpm_2":53.90,"w2":10995,"rpm3":32.09,"filterRpm_3":35.51,"w3":10995}
14:22:38.122 -> {"millis":2122387,"rpm1":48.12,"filterRpm_1":37.11,"w1":10975,"rpm2":48.12,"filterRpm_2":53.21,"w2":10975,"rpm3":32.08,"filterRpm_3":35.10,"w3":10975}
14:22:38.122 -> {"millis":2122397,"rpm1":32.09,"filterRpm_1":37.46,"w1":10955,"rpm2":48.13,"filterRpm_2":52.61,"w2":10955,"rpm3":32.09,"filterRpm_3":34.75,"w3":10955}
14:22:38.122 -> {"millis":2122407,"rpm1":32.09,"filterRpm_1":36.83,"w1":10935,"rpm2":48.13,"filterRpm_2":52.08,"w2":10935,"rpm3":32.09,"filterRpm_3":34.43,"w3":10935}
14:22:38.168 -> {"millis":2122417,"rpm1":32.09,"filterRpm_1":36.27,"w1":10915,"rpm2":64.17,"filterRpm_2":52.56,"w2":10915,"rpm3":32.09,"filterRpm_3":34.16,"w3":10915}
14:22:38.168 -> {"millis":2122427,"rpm1":32.08,"filterRpm_1":35.77,"w1":10895,"rpm2":48.12,"filterRpm_2":52.99,"w2":10895,"rpm3":32.08,"filterRpm_3":33.91,"w3":10895}
14:22:38.168 -> {"millis":2122437,"rpm1":48.13,"filterRpm_1":36.29,"w1":10875,"rpm2":48.13,"filterRpm_2":52.41,"w2":10875,"rpm3":32.09,"filterRpm_3":33.69,"w3":10875}
14:22:38.168 -> {"millis":2122447,"rpm1":32.09,"filterRpm_1":36.74,"w1":10855,"rpm2":48.13,"filterRpm_2":51.91,"w2":10855,"rpm3":32.09,"filterRpm_3":33.50,"w3":10855}
14:22:38.214 -> {"millis":2122457,"rpm1":32.09,"filterRpm_1":36.19,"w1":10835,"rpm2":48.13,"filterRpm_2":51.46,"w2":10835,"rpm3":32.09,"filterRpm_3":33.34,"w3":10835}
14:22:38.214 -> {"millis":2122467,"rpm1":32.09,"filterRpm_1":35.70,"w1":10815,"rpm2":48.13,"filterRpm_2":51.07,"w2":10815,"rpm3":32.09,"filterRpm_3":33.19,"w3":10815}
14:22:38.214 -> {"millis":2122477,"rpm1":32.09,"filterRpm_1":35.28,"w1":10795,"rpm2":48.13,"filterRpm_2":50.72,"w2":10795,"rpm3":32.09,"filterRpm_3":33.06,"w3":10795}
14:22:38.214 -> {"millis":2122487,"rpm1":32.09,"filterRpm_1":34.90,"w1":10775,"rpm2":48.13,"filterRpm_2":50.41,"w2":10775,"rpm3":32.09,"filterRpm_3":32.94,"w3":10775}
14:22:38.214 -> {"millis":2122497,"rpm1":32.09,"filterRpm_1":34.57,"w1":10755,"rpm2":48.13,"filterRpm_2":50.14,"w2":10755,"rpm3":16.04,"filterRpm_3":31.89,"w3":10755}
14:22:38.260 -> {"millis":2122507,"rpm1":48.13,"filterRpm_1":35.22,"w1":10735,"rpm2":48.13,"filterRpm_2":49.90,"w2":10735,"rpm3":32.09,"filterRpm_3":30.97,"w3":10735}
14:22:38.260 -> {"millis":2122517,"rpm1":32.08,"filterRpm_1":35.80,"w1":10715,"rpm2":48.12,"filterRpm_2":49.69,"w2":10715,"rpm3":32.08,"filterRpm_3":31.10,"w3":10715}
14:22:38.260 -> {"millis":2122527,"rpm1":32.09,"filterRpm_1":35.36,"w1":10695,"rpm2":48.13,"filterRpm_2":49.51,"w2":10695,"rpm3":16.04,"filterRpm_3":30.27,"w3":10695}
14:22:38.260 -> {"millis":2122537,"rpm1":32.09,"filterRpm_1":34.97,"w1":10675,"rpm2":48.13,"filterRpm_2":49.35,"w2":10675,"rpm3":32.09,"filterRpm_3":29.53,"w3":10675}
14:22:38.306 -> {"millis":2122547,"rpm1":32.09,"filterRpm_1":34.63,"w1":10655,"rpm2":48.13,"filterRpm_2":49.20,"w2":10655,"rpm3":32.09,"filterRpm_3":29.84,"w3":10655}
14:22:38.306 -> {"millis":2122557,"rpm1":32.09,"filterRpm_1":34.33,"w1":10635,"rpm2":48.13,"filterRpm_2":49.07,"w2":10635,"rpm3":32.09,"filterRpm_3":30.10,"w3":10635}
14:22:38.306 -> {"millis":2122567,"rpm1":32.08,"filterRpm_1":34.06,"w1":10615,"rpm2":48.12,"filterRpm_2":48.96,"w2":10615,"rpm3":32.08,"filterRpm_3":30.34,"w3":10615}
14:22:38.306 -> {"millis":2122577,"rpm1":32.09,"filterRpm_1":33.83,"w1":10595,"rpm2":48.13,"filterRpm_2":48.86,"w2":10595,"rpm3":32.09,"filterRpm_3":30.54,"w3":10595}
14:22:38.306 -> {"millis":2122587,"rpm1":32.09,"filterRpm_1":33.62,"w1":10575,"rpm2":48.13,"filterRpm_2":48.78,"w2":10575,"rpm3":16.04,"filterRpm_3":29.78,"w3":10575}
14:22:38.352 -> {"millis":2122597,"rpm1":32.09,"filterRpm_1":33.44,"w1":10555,"rpm2":48.13,"filterRpm_2":48.70,"w2":10555,"rpm3":32.09,"filterRpm_3":29.10,"w3":10555}
14:22:38.352 -> {"millis":2122607,"rpm1":32.09,"filterRpm_1":33.28,"w1":10535,"rpm2":48.13,"filterRpm_2":48.63,"w2":10535,"rpm3":32.09,"filterRpm_3":29.45,"w3":10535}
14:22:38.352 -> {"millis":2122617,"rpm1":32.09,"filterRpm_1":33.14,"w1":10515,"rpm2":48.13,"filterRpm_2":48.57,"w2":10515,"rpm3":32.09,"filterRpm_3":29.77,"w3":10515}
14:22:38.352 -> {"millis":2122627,"rpm1":32.09,"filterRpm_1":33.02,"w1":10495,"rpm2":48.13,"filterRpm_2":48.52,"w2":10495,"rpm3":16.04,"filterRpm_3":29.09,"w3":10495}
14:22:38.352 -> {"millis":2122637,"rpm1":32.09,"filterRpm_1":32.91,"w1":10475,"rpm2":32.09,"filterRpm_2":47.53,"w2":10475,"rpm3":32.09,"filterRpm_3":28.50,"w3":10475}
14:22:38.398 -> {"millis":2122647,"rpm1":32.08,"filterRpm_1":32.81,"w1":10455,"rpm2":48.12,"filterRpm_2":46.65,"w2":10455,"rpm3":32.08,"filterRpm_3":28.92,"w3":10455}
14:22:38.398 -> {"millis":2122657,"rpm1":32.09,"filterRpm_1":32.72,"w1":10435,"rpm2":48.13,"filterRpm_2":46.82,"w2":10435,"rpm3":16.04,"filterRpm_3":28.35,"w3":10435}
14:22:38.398 -> {"millis":2122667,"rpm1":32.09,"filterRpm_1":32.65,"w1":10415,"rpm2":48.13,"filterRpm_2":46.98,"w2":10415,"rpm3":32.09,"filterRpm_3":27.84,"w3":10415}
14:22:38.398 -> {"millis":2122677,"rpm1":32.08,"filterRpm_1":32.58,"w1":10395,"rpm2":48.12,"filterRpm_2":47.11,"w2":10395,"rpm3":32.08,"filterRpm_3":28.34,"w3":10395}
14:22:38.444 -> {"millis":2122687,"rpm1":16.04,"filterRpm_1":31.57,"w1":10375,"rpm2":32.09,"filterRpm_2":46.29,"w2":10375,"rpm3":16.04,"filterRpm_3":27.84,"w3":10375}
14:22:38.444 -> {"millis":2122697,"rpm1":32.09,"filterRpm_1":30.69,"w1":10355,"rpm2":48.13,"filterRpm_2":45.55,"w2":10355,"rpm3":32.09,"filterRpm_3":27.39,"w3":10355}
14:22:38.444 -> {"millis":2122707,"rpm1":32.09,"filterRpm_1":30.85,"w1":10335,"rpm2":48.13,"filterRpm_2":45.86,"w2":10335,"rpm3":32.09,"filterRpm_3":27.95,"w3":10335}
14:22:38.444 -> {"millis":2122717,"rpm1":32.09,"filterRpm_1":31.00,"w1":10315,"rpm2":48.13,"filterRpm_2":46.13,"w2":10315,"rpm3":16.04,"filterRpm_3":27.49,"w3":10315}
14:22:38.444 -> {"millis":2122727,"rpm1":32.09,"filterRpm_1":31.13,"w1":10295,"rpm2":32.09,"filterRpm_2":45.42,"w2":10295,"rpm3":32.09,"filterRpm_3":27.08,"w3":10295}
14:22:38.490 -> {"millis":2122737,"rpm1":32.09,"filterRpm_1":31.24,"w1":10275,"rpm2":48.13,"filterRpm_2":44.79,"w2":10275,"rpm3":16.04,"filterRpm_3":26.73,"w3":10275}
14:22:38.490 -> {"millis":2122747,"rpm1":32.09,"filterRpm_1":31.34,"w1":10255,"rpm2":32.09,"filterRpm_2":44.23,"w2":10255,"rpm3":32.09,"filterRpm_3":26.41,"w3":10255}
14:22:38.490 -> {"millis":2122757,"rpm1":16.04,"filterRpm_1":30.48,"w1":10235,"rpm2":48.13,"filterRpm_2":43.75,"w2":10235,"rpm3":32.09,"filterRpm_3":27.08,"w3":10235}
14:22:38.490 -> {"millis":2122767,"rpm1":32.09,"filterRpm_1":29.72,"w1":10215,"rpm2":48.13,"filterRpm_2":44.26,"w2":10215,"rpm3":16.04,"filterRpm_3":26.72,"w3":10215}
14:22:38.536 -> {"millis":2122777,"rpm1":32.09,"filterRpm_1":30.00,"w1":10195,"rpm2":32.09,"filterRpm_2":43.77,"w2":10195,"rpm3":32.09,"filterRpm_3":26.41,"w3":10195}
14:22:38.536 -> {"millis":2122787,"rpm1":32.09,"filterRpm_1":30.25,"w1":10175,"rpm2":48.13,"filterRpm_2":43.34,"w2":10175,"rpm3":16.04,"filterRpm_3":26.13,"w3":10175}
14:22:38.536 -> {"millis":2122797,"rpm1":16.04,"filterRpm_1":29.52,"w1":10155,"rpm2":32.09,"filterRpm_2":42.96,"w2":10155,"rpm3":32.09,"filterRpm_3":25.89,"w3":10155}
14:22:38.536 -> {"millis":2122807,"rpm1":32.09,"filterRpm_1":28.87,"w1":10135,"rpm2":48.13,"filterRpm_2":42.62,"w2":10135,"rpm3":16.04,"filterRpm_3":25.67,"w3":10135}
14:22:38.536 -> {"millis":2122817,"rpm1":32.09,"filterRpm_1":29.25,"w1":10115,"rpm2":32.09,"filterRpm_2":42.32,"w2":10115,"rpm3":32.09,"filterRpm_3":25.48,"w3":10115}
14:22:38.582 -> {"millis":2122827,"rpm1":32.09,"filterRpm_1":29.59,"w1":10095,"rpm2":48.13,"filterRpm_2":42.06,"w2":10095,"rpm3":16.04,"filterRpm_3":25.31,"w3":10095}
14:22:38.582 -> {"millis":2122837,"rpm1":16.04,"filterRpm_1":28.93,"w1":10075,"rpm2":32.09,"filterRpm_2":41.83,"w2":10075,"rpm3":32.09,"filterRpm_3":25.17,"w3":10075}
14:22:38.582 -> {"millis":2122847,"rpm1":32.09,"filterRpm_1":28.36,"w1":10055,"rpm2":48.13,"filterRpm_2":41.63,"w2":10055,"rpm3":16.04,"filterRpm_3":25.04,"w3":10055}
14:22:38.582 -> {"millis":2122857,"rpm1":32.09,"filterRpm_1":28.80,"w1":10035,"rpm2":32.09,"filterRpm_2":41.45,"w2":10035,"rpm3":32.09,"filterRpm_3":24.92,"w3":10035}
14:22:38.582 -> {"millis":2122867,"rpm1":16.04,"filterRpm_1":28.24,"w1":10015,"rpm2":48.13,"filterRpm_2":41.29,"w2":10015,"rpm3":16.04,"filterRpm_3":24.82,"w3":10015}
14:22:38.629 -> {"millis":2122877,"rpm1":32.09,"filterRpm_1":27.75,"w1":10000,"rpm2":32.09,"filterRpm_2":41.15,"w2":10000,"rpm3":16.04,"filterRpm_3":23.78,"w3":10000}
14:22:38.629 -> {"millis":2122887,"rpm1":32.08,"filterRpm_1":28.26,"w1":10020,"rpm2":32.08,"filterRpm_2":40.08,"w2":10020,"rpm3":32.08,"filterRpm_3":23.82,"w3":10020}
14:22:38.629 -> {"millis":2122897,"rpm1":16.04,"filterRpm_1":27.76,"w1":10040,"rpm2":48.13,"filterRpm_2":40.08,"w2":10040,"rpm3":16.04,"filterRpm_3":23.84,"w3":10040}
14:22:38.629 -> {"millis":2122907,"rpm1":32.09,"filterRpm_1":27.33,"w1":10060,"rpm2":32.09,"filterRpm_2":40.08,"w2":10060,"rpm3":32.09,"filterRpm_3":23.87,"w3":10060}
14:22:38.675 -> {"millis":2122917,"rpm1":32.09,"filterRpm_1":27.89,"w1":10080,"rpm2":32.09,"filterRpm_2":39.14,"w2":10080,"rpm3":16.04,"filterRpm_3":23.89,"w3":10080}
14:22:38.675 -> {"millis":2122927,"rpm1":16.04,"filterRpm_1":27.44,"w1":10100,"rpm2":48.12,"filterRpm_2":39.25,"w2":10100,"rpm3":16.04,"filterRpm_3":22.97,"w3":10100}
14:22:38.675 -> {"millis":2122937,"rpm1":32.09,"filterRpm_1":27.04,"w1":10120,"rpm2":32.09,"filterRpm_2":39.35,"w2":10120,"rpm3":32.09,"filterRpm_3":23.10,"w3":10120}
14:22:38.675 -> {"millis":2122947,"rpm1":32.08,"filterRpm_1":27.63,"w1":10140,"rpm2":32.08,"filterRpm_2":38.49,"w2":10140,"rpm3":16.04,"filterRpm_3":23.21,"w3":10140}
14:22:38.675 -> {"millis":2122957,"rpm1":16.04,"filterRpm_1":27.21,"w1":10160,"rpm2":48.13,"filterRpm_2":38.68,"w2":10160,"rpm3":32.09,"filterRpm_3":23.31,"w3":10160}
14:22:38.722 -> {"millis":2122967,"rpm1":32.09,"filterRpm_1":26.84,"w1":10180,"rpm2":32.09,"filterRpm_2":38.85,"w2":10180,"rpm3":16.04,"filterRpm_3":23.40,"w3":10180}
14:22:38.722 -> {"millis":2122977,"rpm1":16.04,"filterRpm_1":26.51,"w1":10200,"rpm2":32.08,"filterRpm_2":38.05,"w2":10200,"rpm3":16.04,"filterRpm_3":22.53,"w3":10200}
14:22:38.722 -> {"millis":2122987,"rpm1":32.09,"filterRpm_1":26.22,"w1":10220,"rpm2":48.13,"filterRpm_2":38.30,"w2":10220,"rpm3":32.09,"filterRpm_3":22.71,"w3":10220}
14:22:38.722 -> {"millis":2122997,"rpm1":32.08,"filterRpm_1":26.92,"w1":10240,"rpm2":32.08,"filterRpm_2":38.51,"w2":10240,"rpm3":16.04,"filterRpm_3":22.87,"w3":10240}
14:22:38.768 -> {"millis":2123007,"rpm1":16.04,"filterRpm_1":26.58,"w1":10260,"rpm2":32.09,"filterRpm_2":37.75,"w2":10260,"rpm3":16.04,"filterRpm_3":22.06,"w3":10260}
14:22:38.768 -> {"millis":2123017,"rpm1":32.08,"filterRpm_1":26.28,"w1":10280,"rpm2":32.08,"filterRpm_2":37.08,"w2":10280,"rpm3":32.08,"filterRpm_3":22.30,"w3":10280}
14:22:38.768 -> {"millis":2123027,"rpm1":16.04,"filterRpm_1":26.02,"w1":10300,"rpm2":48.13,"filterRpm_2":37.44,"w2":10300,"rpm3":16.04,"filterRpm_3":22.51,"w3":10300}
14:22:38.768 -> {"millis":2123037,"rpm1":32.09,"filterRpm_1":25.79,"w1":10320,"rpm2":32.09,"filterRpm_2":37.75,"w2":10320,"rpm3":16.04,"filterRpm_3":21.74,"w3":10320}
14:22:38.768 -> {"millis":2123047,"rpm1":32.09,"filterRpm_1":26.53,"w1":10340,"rpm2":32.09,"filterRpm_2":37.08,"w2":10340,"rpm3":32.09,"filterRpm_3":22.02,"w3":10340}
14:22:38.814 -> {"millis":2123057,"rpm1":16.04,"filterRpm_1":26.24,"w1":10360,"rpm2":32.09,"filterRpm_2":36.49,"w2":10360,"rpm3":16.04,"filterRpm_3":22.26,"w3":10360}
14:22:38.814 -> {"millis":2123067,"rpm1":32.09,"filterRpm_1":25.98,"w1":10380,"rpm2":48.13,"filterRpm_2":36.92,"w2":10380,"rpm3":16.04,"filterRpm_3":21.53,"w3":10380}
14:22:38.814 -> {"millis":2123077,"rpm1":32.09,"filterRpm_1":26.70,"w1":10400,"rpm2":32.09,"filterRpm_2":37.30,"w2":10400,"rpm3":32.09,"filterRpm_3":21.83,"w3":10400}
14:22:38.814 -> {"millis":2123087,"rpm1":16.04,"filterRpm_1":26.39,"w1":10420,"rpm2":32.09,"filterRpm_2":36.68,"w2":10420,"rpm3":16.04,"filterRpm_3":22.09,"w3":10420}
14:22:38.814 -> {"millis":2123097,"rpm1":32.08,"filterRpm_1":26.12,"w1":10440,"rpm2":32.08,"filterRpm_2":36.14,"w2":10440,"rpm3":16.04,"filterRpm_3":21.38,"w3":10440}
14:22:38.860 -> {"millis":2123107,"rpm1":32.09,"filterRpm_1":26.82,"w1":10460,"rpm2":48.13,"filterRpm_2":36.61,"w2":10460,"rpm3":32.09,"filterRpm_3":21.69,"w3":10460}
14:22:38.860 -> {"millis":2123117,"rpm1":16.04,"filterRpm_1":26.50,"w1":10480,"rpm2":32.09,"filterRpm_2":37.02,"w2":10480,"rpm3":16.04,"filterRpm_3":21.97,"w3":10480}
14:22:38.860 -> {"millis":2123127,"rpm1":32.09,"filterRpm_1":26.21,"w1":10500,"rpm2":32.09,"filterRpm_2":36.44,"w2":10500,"rpm3":16.04,"filterRpm_3":21.27,"w3":10500}
14:22:38.860 -> {"millis":2123137,"rpm1":16.04,"filterRpm_1":25.96,"w1":10520,"rpm2":48.12,"filterRpm_2":36.87,"w2":10520,"rpm3":32.08,"filterRpm_3":21.60,"w3":10520}
14:22:38.907 -> {"millis":2123147,"rpm1":32.09,"filterRpm_1":25.73,"w1":10540,"rpm2":32.09,"filterRpm_2":37.25,"w2":10540,"rpm3":16.04,"filterRpm_3":21.89,"w3":10540}
14:22:38.907 -> {"millis":2123157,"rpm1":32.09,"filterRpm_1":26.48,"w1":10560,"rpm2":32.09,"filterRpm_2":36.64,"w2":10560,"rpm3":16.04,"filterRpm_3":21.20,"w3":10560}
14:22:38.907 -> {"millis":2123167,"rpm1":16.04,"filterRpm_1":26.20,"w1":10580,"rpm2":32.09,"filterRpm_2":36.10,"w2":10580,"rpm3":32.09,"filterRpm_3":21.54,"w3":10580}
14:22:38.907 -> {"millis":2123177,"rpm1":32.09,"filterRpm_1":25.95,"w1":10600,"rpm2":48.13,"filterRpm_2":36.58,"w2":10600,"rpm3":16.04,"filterRpm_3":21.84,"w3":10600}
14:22:38.907 -> {"millis":2123187,"rpm1":32.09,"filterRpm_1":26.67,"w1":10620,"rpm2":32.09,"filterRpm_2":36.99,"w2":10620,"rpm3":16.04,"filterRpm_3":21.15,"w3":10620}
14:22:38.953 -> {"millis":2123197,"rpm1":32.09,"filterRpm_1":27.31,"w1":10640,"rpm2":32.09,"filterRpm_2":36.41,"w2":10640,"rpm3":32.09,"filterRpm_3":21.50,"w3":10640}
14:22:38.953 -> {"millis":2123207,"rpm1":16.04,"filterRpm_1":26.93,"w1":10660,"rpm2":32.09,"filterRpm_2":35.90,"w2":10660,"rpm3":16.04,"filterRpm_3":21.80,"w3":10660}
14:22:38.953 -> {"millis":2123217,"rpm1":32.09,"filterRpm_1":26.59,"w1":10680,"rpm2":48.13,"filterRpm_2":36.40,"w2":10680,"rpm3":16.04,"filterRpm_3":21.12,"w3":10680}
14:22:38.953 -> {"millis":2123227,"rpm1":32.09,"filterRpm_1":27.24,"w1":10700,"rpm2":32.09,"filterRpm_2":36.84,"w2":10700,"rpm3":32.09,"filterRpm_3":21.47,"w3":10700}
14:22:38.953 -> {"millis":2123237,"rpm1":16.04,"filterRpm_1":26.86,"w1":10720,"rpm2":32.09,"filterRpm_2":36.28,"w2":10720,"rpm3":16.04,"filterRpm_3":21.78,"w3":10720}
14:22:38.999 -> {"millis":2123247,"rpm1":32.09,"filterRpm_1":26.53,"w1":10740,"rpm2":32.09,"filterRpm_2":35.78,"w2":10740,"rpm3":32.09,"filterRpm_3":22.05,"w3":10740}
14:22:38.999 -> {"millis":2123257,"rpm1":32.09,"filterRpm_1":27.19,"w1":10760,"rpm2":48.13,"filterRpm_2":36.29,"w2":10760,"rpm3":16.04,"filterRpm_3":22.28,"w3":10760}
14:22:38.999 -> {"millis":2123267,"rpm1":16.04,"filterRpm_1":26.82,"w1":10780,"rpm2":32.09,"filterRpm_2":36.74,"w2":10780,"rpm3":16.04,"filterRpm_3":21.55,"w3":10780}
14:22:38.999 -> {"millis":2123277,"rpm1":32.09,"filterRpm_1":26.49,"w1":10800,"rpm2":32.09,"filterRpm_2":36.19,"w2":10800,"rpm3":32.09,"filterRpm_3":21.84,"w3":10800}
14:22:39.045 -> {"millis":2123287,"rpm1":32.09,"filterRpm_1":27.15,"w1":10820,"rpm2":48.13,"filterRpm_2":36.66,"w2":10820,"rpm3":16.04,"filterRpm_3":22.11,"w3":10820}
14:22:39.045 -> {"millis":2123297,"rpm1":32.09,"filterRpm_1":27.74,"w1":10840,"rpm2":32.09,"filterRpm_2":37.06,"w2":10840,"rpm3":16.04,"filterRpm_3":21.39,"w3":10840}
14:22:39.045 -> {"millis":2123307,"rpm1":16.04,"filterRpm_1":27.30,"w1":10860,"rpm2":32.09,"filterRpm_2":36.47,"w2":10860,"rpm3":32.09,"filterRpm_3":21.71,"w3":10860}
14:22:39.045 -> {"millis":2123317,"rpm1":32.09,"filterRpm_1":26.92,"w1":10880,"rpm2":48.13,"filterRpm_2":36.90,"w2":10880,"rpm3":16.04,"filterRpm_3":21.98,"w3":10880}
14:22:39.045 -> {"millis":2123327,"rpm1":32.09,"filterRpm_1":27.53,"w1":10900,"rpm2":32.09,"filterRpm_2":37.28,"w2":10900,"rpm3":32.09,"filterRpm_3":22.23,"w3":10900}
14:22:39.091 -> {"millis":2123337,"rpm1":32.09,"filterRpm_1":28.07,"w1":10920,"rpm2":32.09,"filterRpm_2":36.67,"w2":10920,"rpm3":16.04,"filterRpm_3":22.45,"w3":10920}
14:22:39.091 -> {"millis":2123347,"rpm1":16.04,"filterRpm_1":27.60,"w1":10940,"rpm2":48.12,"filterRpm_2":37.07,"w2":10940,"rpm3":16.04,"filterRpm_3":21.69,"w3":10940}
14:22:39.091 -> {"millis":2123357,"rpm1":32.09,"filterRpm_1":27.18,"w1":10960,"rpm2":32.09,"filterRpm_2":37.43,"w2":10960,"rpm3":32.09,"filterRpm_3":21.97,"w3":10960}
14:22:39.091 -> {"millis":2123367,"rpm1":32.09,"filterRpm_1":27.76,"w1":10980,"rpm2":32.09,"filterRpm_2":36.80,"w2":10980,"rpm3":16.04,"filterRpm_3":22.22,"w3":10980}
14:22:39.137 -> {"millis":2123377,"rpm1":32.09,"filterRpm_1":28.27,"w1":11000,"rpm2":48.13,"filterRpm_2":37.19,"w2":11000,"rpm3":32.09,"filterRpm_3":22.44,"w3":11000}
14:22:39.137 -> {"millis":2123387,"rpm1":32.09,"filterRpm_1":28.72,"w1":11020,"rpm2":32.09,"filterRpm_2":37.54,"w2":11020,"rpm3":16.04,"filterRpm_3":22.63,"w3":11020}
14:22:39.137 -> {"millis":2123397,"rpm1":32.09,"filterRpm_1":29.12,"w1":11040,"rpm2":32.09,"filterRpm_2":36.89,"w2":11040,"rpm3":32.09,"filterRpm_3":22.80,"w3":11040}
14:22:39.137 -> {"millis":2123407,"rpm1":16.04,"filterRpm_1":28.52,"w1":11060,"rpm2":48.12,"filterRpm_2":37.27,"w2":11060,"rpm3":16.04,"filterRpm_3":22.95,"w3":11060}
14:22:39.137 -> {"millis":2123417,"rpm1":32.09,"filterRpm_1":27.99,"w1":11080,"rpm2":32.09,"filterRpm_2":37.61,"w2":11080,"rpm3":16.04,"filterRpm_3":22.13,"w3":11080}
14:22:39.183 -> {"millis":2123427,"rpm1":32.09,"filterRpm_1":28.48,"w1":11100,"rpm2":48.13,"filterRpm_2":37.90,"w2":11100,"rpm3":32.09,"filterRpm_3":22.36,"w3":11100}
14:22:39.183 -> {"millis":2123437,"rpm1":32.09,"filterRpm_1":28.90,"w1":11120,"rpm2":32.09,"filterRpm_2":38.16,"w2":11120,"rpm3":16.04,"filterRpm_3":22.56,"w3":11120}
14:22:39.183 -> {"millis":2123447,"rpm1":32.09,"filterRpm_1":29.28,"w1":11140,"rpm2":32.09,"filterRpm_2":37.44,"w2":11140,"rpm3":32.09,"filterRpm_3":22.74,"w3":11140}
14:22:39.183 -> {"millis":2123457,"rpm1":32.09,"filterRpm_1":29.61,"w1":11160,"rpm2":48.13,"filterRpm_2":37.76,"w2":11160,"rpm3":16.04,"filterRpm_3":22.90,"w3":11160}
14:22:39.183 -> {"millis":2123467,"rpm1":32.09,"filterRpm_1":29.90,"w1":11180,"rpm2":32.09,"filterRpm_2":38.04,"w2":11180,"rpm3":32.09,"filterRpm_3":23.03,"w3":11180}
14:22:39.230 -> {"millis":2123477,"rpm1":16.04,"filterRpm_1":29.21,"w1":11200,"rpm2":48.13,"filterRpm_2":38.28,"w2":11200,"rpm3":16.04,"filterRpm_3":23.16,"w3":11200}
14:22:39.230 -> {"millis":2123487,"rpm1":32.09,"filterRpm_1":28.61,"w1":11220,"rpm2":32.09,"filterRpm_2":38.50,"w2":11220,"rpm3":32.09,"filterRpm_3":23.26,"w3":11220}
14:22:39.230 -> {"millis":2123497,"rpm1":32.09,"filterRpm_1":29.02,"w1":11240,"rpm2":48.13,"filterRpm_2":38.69,"w2":11240,"rpm3":16.04,"filterRpm_3":23.36,"w3":11240}
14:22:39.230 -> {"millis":2123507,"rpm1":32.09,"filterRpm_1":29.38,"w1":11260,"rpm2":32.09,"filterRpm_2":38.86,"w2":11260,"rpm3":32.09,"filterRpm_3":23.44,"w3":11260}
14:22:39.276 -> {"millis":2123517,"rpm1":32.09,"filterRpm_1":29.70,"w1":11280,"rpm2":48.13,"filterRpm_2":39.00,"w2":11280,"rpm3":32.09,"filterRpm_3":24.46,"w3":11280}
14:22:39.276 -> {"millis":2123527,"rpm1":32.09,"filterRpm_1":29.98,"w1":11300,"rpm2":32.09,"filterRpm_2":39.13,"w2":11300,"rpm3":16.04,"filterRpm_3":24.42,"w3":11300}
14:22:39.276 -> {"millis":2123537,"rpm1":32.08,"filterRpm_1":30.23,"w1":11320,"rpm2":48.12,"filterRpm_2":39.25,"w2":11320,"rpm3":32.08,"filterRpm_3":24.37,"w3":11320}
14:22:39.276 -> {"millis":2123547,"rpm1":32.09,"filterRpm_1":30.45,"w1":11340,"rpm2":32.09,"filterRpm_2":39.35,"w2":11340,"rpm3":16.04,"filterRpm_3":24.34,"w3":11340}
14:22:39.276 -> {"millis":2123557,"rpm1":32.09,"filterRpm_1":30.64,"w1":11360,"rpm2":48.13,"filterRpm_2":39.44,"w2":11360,"rpm3":32.09,"filterRpm_3":24.31,"w3":11360}
14:22:39.322 -> {"millis":2123567,"rpm1":32.09,"filterRpm_1":30.81,"w1":11380,"rpm2":32.09,"filterRpm_2":39.52,"w2":11380,"rpm3":32.09,"filterRpm_3":25.23,"w3":11380}
14:22:39.322 -> {"millis":2123577,"rpm1":32.08,"filterRpm_1":30.96,"w1":11400,"rpm2":48.12,"filterRpm_2":39.59,"w2":11400,"rpm3":16.04,"filterRpm_3":25.09,"w3":11400}
14:22:39.322 -> {"millis":2123587,"rpm1":32.09,"filterRpm_1":31.10,"w1":11420,"rpm2":32.09,"filterRpm_2":39.65,"w2":11420,"rpm3":32.09,"filterRpm_3":24.97,"w3":11420}
14:22:39.322 -> {"millis":2123597,"rpm1":32.09,"filterRpm_1":31.21,"w1":11440,"rpm2":48.13,"filterRpm_2":39.70,"w2":11440,"rpm3":32.09,"filterRpm_3":25.81,"w3":11440}
14:22:39.368 -> {"millis":2123607,"rpm1":32.08,"filterRpm_1":31.32,"w1":11460,"rpm2":48.12,"filterRpm_2":40.70,"w2":11460,"rpm3":16.04,"filterRpm_3":25.60,"w3":11460}
14:22:39.368 -> {"millis":2123617,"rpm1":32.09,"filterRpm_1":31.41,"w1":11480,"rpm2":32.09,"filterRpm_2":40.63,"w2":11480,"rpm3":32.09,"filterRpm_3":25.42,"w3":11480}
14:22:39.368 -> {"millis":2123627,"rpm1":32.09,"filterRpm_1":31.49,"w1":11500,"rpm2":48.13,"filterRpm_2":40.57,"w2":11500,"rpm3":32.09,"filterRpm_3":26.21,"w3":11500}
14:22:39.368 -> {"millis":2123637,"rpm1":32.09,"filterRpm_1":31.56,"w1":11520,"rpm2":32.09,"filterRpm_2":40.51,"w2":11520,"rpm3":16.04,"filterRpm_3":25.96,"w3":11520}
14:22:39.368 -> {"millis":2123647,"rpm1":32.09,"filterRpm_1":31.62,"w1":11540,"rpm2":48.13,"filterRpm_2":40.47,"w2":11540,"rpm3":32.09,"filterRpm_3":25.73,"w3":11540}
14:22:39.414 -> {"millis":2123657,"rpm1":48.13,"filterRpm_1":32.62,"w1":11560,"rpm2":48.13,"filterRpm_2":41.37,"w2":11560,"rpm3":32.09,"filterRpm_3":26.48,"w3":11560}
14:22:39.414 -> {"millis":2123667,"rpm1":32.09,"filterRpm_1":33.51,"w1":11580,"rpm2":32.09,"filterRpm_2":41.22,"w2":11580,"rpm3":16.04,"filterRpm_3":26.20,"w3":11580}
14:22:39.414 -> {"millis":2123677,"rpm1":32.08,"filterRpm_1":33.34,"w1":11600,"rpm2":48.12,"filterRpm_2":41.09,"w2":11600,"rpm3":32.08,"filterRpm_3":25.94,"w3":11600}
14:22:39.414 -> {"millis":2123687,"rpm1":32.09,"filterRpm_1":33.19,"w1":11620,"rpm2":48.13,"filterRpm_2":41.92,"w2":11620,"rpm3":32.09,"filterRpm_3":26.67,"w3":11620}
14:22:39.414 -> {"millis":2123697,"rpm1":32.09,"filterRpm_1":33.06,"w1":11640,"rpm2":32.09,"filterRpm_2":41.71,"w2":11640,"rpm3":32.09,"filterRpm_3":27.31,"w3":11640}
14:22:39.460 -> {"millis":2123707,"rpm1":32.09,"filterRpm_1":32.95,"w1":11660,"rpm2":48.13,"filterRpm_2":41.52,"w2":11660,"rpm3":16.04,"filterRpm_3":26.93,"w3":11660}
14:22:39.460 -> {"millis":2123717,"rpm1":32.09,"filterRpm_1":32.84,"w1":11680,"rpm2":48.13,"filterRpm_2":42.30,"w2":11680,"rpm3":32.09,"filterRpm_3":26.59,"w3":11680}
14:22:39.460 -> {"millis":2123727,"rpm1":32.09,"filterRpm_1":32.75,"w1":11700,"rpm2":32.09,"filterRpm_2":42.04,"w2":11700,"rpm3":32.09,"filterRpm_3":27.24,"w3":11700}
14:22:39.460 -> {"millis":2123737,"rpm1":48.12,"filterRpm_1":33.62,"w1":11720,"rpm2":48.12,"filterRpm_2":41.81,"w2":11720,"rpm3":32.08,"filterRpm_3":27.81,"w3":11720}
14:22:39.506 -> {"millis":2123747,"rpm1":32.09,"filterRpm_1":34.39,"w1":11740,"rpm2":48.13,"filterRpm_2":42.56,"w2":11740,"rpm3":32.09,"filterRpm_3":28.32,"w3":11740}
14:22:39.506 -> {"millis":2123757,"rpm1":32.08,"filterRpm_1":34.12,"w1":11760,"rpm2":48.12,"filterRpm_2":43.22,"w2":11760,"rpm3":16.04,"filterRpm_3":27.81,"w3":11760}
14:22:39.506 -> {"millis":2123767,"rpm1":32.09,"filterRpm_1":33.88,"w1":11780,"rpm2":32.09,"filterRpm_2":42.85,"w2":11780,"rpm3":32.09,"filterRpm_3":27.37,"w3":11780}
14:22:39.506 -> {"millis":2123777,"rpm1":32.09,"filterRpm_1":33.67,"w1":11800,"rpm2":48.13,"filterRpm_2":42.53,"w2":11800,"rpm3":32.09,"filterRpm_3":27.93,"w3":11800}
14:22:39.506 -> {"millis":2123787,"rpm1":48.13,"filterRpm_1":34.43,"w1":11820,"rpm2":48.13,"filterRpm_2":43.19,"w2":11820,"rpm3":32.09,"filterRpm_3":28.42,"w3":11820}
14:22:39.552 -> {"millis":2123797,"rpm1":32.09,"filterRpm_1":35.10,"w1":11840,"rpm2":48.13,"filterRpm_2":43.77,"w2":11840,"rpm3":32.09,"filterRpm_3":28.85,"w3":11840}
14:22:39.552 -> {"millis":2123807,"rpm1":32.09,"filterRpm_1":34.74,"w1":11860,"rpm2":48.13,"filterRpm_2":44.29,"w2":11860,"rpm3":32.09,"filterRpm_3":29.24,"w3":11860}
14:22:39.552 -> {"millis":2123817,"rpm1":32.09,"filterRpm_1":34.43,"w1":11880,"rpm2":32.09,"filterRpm_2":43.79,"w2":11880,"rpm3":32.09,"filterRpm_3":29.57,"w3":11880}
14:22:39.552 -> {"millis":2123827,"rpm1":48.12,"filterRpm_1":35.10,"w1":11900,"rpm2":48.12,"filterRpm_2":43.36,"w2":11900,"rpm3":32.08,"filterRpm_3":29.87,"w3":11900}
14:22:39.598 -> {"millis":2123837,"rpm1":32.09,"filterRpm_1":35.69,"w1":11920,"rpm2":48.13,"filterRpm_2":43.92,"w2":11920,"rpm3":32.09,"filterRpm_3":30.13,"w3":11920}
14:22:39.598 -> {"millis":2123847,"rpm1":32.09,"filterRpm_1":35.27,"w1":11940,"rpm2":48.13,"filterRpm_2":44.42,"w2":11940,"rpm3":16.04,"filterRpm_3":29.41,"w3":11940}
14:22:39.598 -> {"millis":2123857,"rpm1":32.08,"filterRpm_1":34.89,"w1":11960,"rpm2":48.12,"filterRpm_2":44.86,"w2":11960,"rpm3":32.08,"filterRpm_3":28.78,"w3":11960}
14:22:39.598 -> {"millis":2123867,"rpm1":48.13,"filterRpm_1":35.51,"w1":11980,"rpm2":48.13,"filterRpm_2":45.24,"w2":11980,"rpm3":32.09,"filterRpm_3":29.17,"w3":11980}
14:22:39.598 -> {"millis":2123877,"rpm1":32.09,"filterRpm_1":36.05,"w1":12000,"rpm2":48.13,"filterRpm_2":45.58,"w2":12000,"rpm3":32.09,"filterRpm_3":29.52,"w3":12000}
14:22:39.645 -> {"millis":2123887,"rpm1":32.09,"filterRpm_1":35.58,"w1":12020,"rpm2":48.13,"filterRpm_2":45.89,"w2":12020,"rpm3":32.09,"filterRpm_3":29.82,"w3":12020}
14:22:39.645 -> {"millis":2123897,"rpm1":48.12,"filterRpm_1":36.12,"w1":12040,"rpm2":48.12,"filterRpm_2":46.15,"w2":12040,"rpm3":32.08,"filterRpm_3":30.09,"w3":12040}
14:22:39.645 -> {"millis":2123907,"rpm1":32.09,"filterRpm_1":36.59,"w1":12060,"rpm2":32.09,"filterRpm_2":45.44,"w2":12060,"rpm3":32.09,"filterRpm_3":30.32,"w3":12060}
14:22:39.645 -> {"millis":2123917,"rpm1":32.08,"filterRpm_1":36.06,"w1":12080,"rpm2":48.12,"filterRpm_2":44.81,"w2":12080,"rpm3":32.08,"filterRpm_3":30.53,"w3":12080}
14:22:39.645 -> {"millis":2123927,"rpm1":48.13,"filterRpm_1":36.53,"w1":12100,"rpm2":48.13,"filterRpm_2":45.20,"w2":12100,"rpm3":48.13,"filterRpm_3":31.66,"w3":12100}
14:22:39.690 -> {"millis":2123937,"rpm1":32.09,"filterRpm_1":36.96,"w1":12120,"rpm2":48.13,"filterRpm_2":45.55,"w2":12120,"rpm3":32.09,"filterRpm_3":32.66,"w3":12120}
14:22:39.690 -> {"millis":2123947,"rpm1":48.13,"filterRpm_1":37.33,"w1":12140,"rpm2":48.13,"filterRpm_2":45.85,"w2":12140,"rpm3":32.09,"filterRpm_3":32.59,"w3":12140}
14:22:39.690 -> {"millis":2123957,"rpm1":32.09,"filterRpm_1":37.66,"w1":12160,"rpm2":48.13,"filterRpm_2":46.12,"w2":12160,"rpm3":32.09,"filterRpm_3":32.53,"w3":12160}
14:22:39.690 -> {"millis":2123967,"rpm1":32.09,"filterRpm_1":37.00,"w1":12180,"rpm2":64.17,"filterRpm_2":47.31,"w2":12180,"rpm3":32.09,"filterRpm_3":32.48,"w3":12180}
14:22:39.736 -> {"millis":2123977,"rpm1":48.13,"filterRpm_1":37.37,"w1":12200,"rpm2":48.13,"filterRpm_2":48.35,"w2":12200,"rpm3":32.09,"filterRpm_3":32.43,"w3":12200}
14:22:39.736 -> {"millis":2123987,"rpm1":32.09,"filterRpm_1":37.69,"w1":12220,"rpm2":48.13,"filterRpm_2":48.33,"w2":12220,"rpm3":32.09,"filterRpm_3":32.39,"w3":12220}
14:22:39.736 -> {"millis":2123997,"rpm1":48.13,"filterRpm_1":37.98,"w1":12240,"rpm2":48.13,"filterRpm_2":48.30,"w2":12240,"rpm3":32.09,"filterRpm_3":32.36,"w3":12240}
14:22:39.736 -> {"millis":2124007,"rpm1":32.09,"filterRpm_1":38.23,"w1":12260,"rpm2":48.13,"filterRpm_2":48.28,"w2":12260,"rpm3":48.13,"filterRpm_3":33.27,"w3":12260}
14:22:39.736 -> {"millis":2124017,"rpm1":48.13,"filterRpm_1":38.45,"w1":12280,"rpm2":48.13,"filterRpm_2":48.26,"w2":12280,"rpm3":32.09,"filterRpm_3":34.08,"w3":12280}
14:22:39.782 -> {"millis":2124027,"rpm1":32.09,"filterRpm_1":38.65,"w1":12300,"rpm2":48.13,"filterRpm_2":48.25,"w2":12300,"rpm3":32.09,"filterRpm_3":33.85,"w3":12300}
14:22:39.782 -> {"millis":2124037,"rpm1":48.13,"filterRpm_1":38.82,"w1":12320,"rpm2":48.13,"filterRpm_2":48.23,"w2":12320,"rpm3":32.09,"filterRpm_3":33.64,"w3":12320}
14:22:39.782 -> {"millis":2124047,"rpm1":32.09,"filterRpm_1":38.97,"w1":12340,"rpm2":48.13,"filterRpm_2":48.22,"w2":12340,"rpm3":32.09,"filterRpm_3":33.45,"w3":12340}
14:22:39.782 -> {"millis":2124057,"rpm1":48.13,"filterRpm_1":39.11,"w1":12360,"rpm2":48.13,"filterRpm_2":48.21,"w2":12360,"rpm3":48.13,"filterRpm_3":34.24,"w3":12360}
14:22:39.782 -> {"millis":2124067,"rpm1":32.09,"filterRpm_1":39.22,"w1":12380,"rpm2":64.17,"filterRpm_2":49.15,"w2":12380,"rpm3":32.09,"filterRpm_3":34.93,"w3":12380}
14:22:39.828 -> {"millis":2124077,"rpm1":48.13,"filterRpm_1":39.33,"w1":12400,"rpm2":48.13,"filterRpm_2":49.98,"w2":12400,"rpm3":32.09,"filterRpm_3":34.60,"w3":12400}
14:22:39.828 -> {"millis":2124087,"rpm1":32.09,"filterRpm_1":39.42,"w1":12420,"rpm2":48.13,"filterRpm_2":49.76,"w2":12420,"rpm3":32.09,"filterRpm_3":34.30,"w3":12420}
14:22:39.828 -> {"millis":2124097,"rpm1":48.13,"filterRpm_1":39.50,"w1":12440,"rpm2":48.13,"filterRpm_2":49.57,"w2":12440,"rpm3":48.13,"filterRpm_3":34.99,"w3":12440}
14:22:39.828 -> {"millis":2124107,"rpm1":32.09,"filterRpm_1":39.57,"w1":12460,"rpm2":48.13,"filterRpm_2":49.40,"w2":12460,"rpm3":32.09,"filterRpm_3":35.59,"w3":12460}
14:22:39.874 -> {"millis":2124117,"rpm1":48.13,"filterRpm_1":39.64,"w1":12480,"rpm2":64.17,"filterRpm_2":50.19,"w2":12480,"rpm3":32.09,"filterRpm_3":35.18,"w3":12480}
14:22:39.874 -> {"millis":2124127,"rpm1":48.13,"filterRpm_1":40.64,"w1":12500,"rpm2":48.13,"filterRpm_2":50.90,"w2":12500,"rpm3":48.13,"filterRpm_3":35.76,"w3":12500}
14:22:39.874 -> {"millis":2124137,"rpm1":32.09,"filterRpm_1":40.58,"w1":12520,"rpm2":48.13,"filterRpm_2":50.57,"w2":12520,"rpm3":32.09,"filterRpm_3":36.27,"w3":12520}
14:22:39.874 -> {"millis":2124147,"rpm1":48.13,"filterRpm_1":40.52,"w1":12540,"rpm2":48.13,"filterRpm_2":50.28,"w2":12540,"rpm3":32.09,"filterRpm_3":35.78,"w3":12540}
14:22:39.874 -> {"millis":2124157,"rpm1":48.13,"filterRpm_1":41.42,"w1":12560,"rpm2":64.17,"filterRpm_2":50.98,"w2":12560,"rpm3":48.13,"filterRpm_3":36.29,"w3":12560}
14:22:39.920 -> {"millis":2124167,"rpm1":32.08,"filterRpm_1":41.27,"w1":12580,"rpm2":48.12,"filterRpm_2":51.59,"w2":12580,"rpm3":32.08,"filterRpm_3":36.74,"w3":12580}
14:22:39.920 -> {"millis":2124177,"rpm1":48.13,"filterRpm_1":41.13,"w1":12600,"rpm2":48.13,"filterRpm_2":51.18,"w2":12600,"rpm3":32.09,"filterRpm_3":36.19,"w3":12600}
14:22:39.920 -> {"millis":2124187,"rpm1":48.12,"filterRpm_1":41.96,"w1":12620,"rpm2":64.16,"filterRpm_2":51.77,"w2":12620,"rpm3":48.12,"filterRpm_3":36.65,"w3":12620}
14:22:39.920 -> {"millis":2124197,"rpm1":32.09,"filterRpm_1":41.74,"w1":12640,"rpm2":48.13,"filterRpm_2":52.28,"w2":12640,"rpm3":32.09,"filterRpm_3":37.06,"w3":12640}
14:22:39.966 -> {"millis":2124207,"rpm1":48.13,"filterRpm_1":41.54,"w1":12660,"rpm2":48.13,"filterRpm_2":51.79,"w2":12660,"rpm3":48.13,"filterRpm_3":37.42,"w3":12660}
14:22:39.966 -> {"millis":2124217,"rpm1":48.13,"filterRpm_1":42.32,"w1":12680,"rpm2":48.13,"filterRpm_2":51.36,"w2":12680,"rpm3":32.09,"filterRpm_3":37.74,"w3":12680}
14:22:39.966 -> {"millis":2124227,"rpm1":32.09,"filterRpm_1":42.06,"w1":12700,"rpm2":64.17,"filterRpm_2":51.93,"w2":12700,"rpm3":48.13,"filterRpm_3":38.02,"w3":12700}
14:22:39.966 -> {"millis":2124237,"rpm1":48.12,"filterRpm_1":41.83,"w1":12720,"rpm2":32.08,"filterRpm_2":51.48,"w2":12720,"rpm3":32.08,"filterRpm_3":38.27,"w3":12720}
14:22:39.966 -> {"millis":2124247,"rpm1":48.13,"filterRpm_1":42.57,"w1":12740,"rpm2":64.18,"filterRpm_2":51.08,"w2":12740,"rpm3":48.13,"filterRpm_3":38.48,"w3":12740}
14:22:40.013 -> {"millis":2124257,"rpm1":48.12,"filterRpm_1":43.23,"w1":12760,"rpm2":48.12,"filterRpm_2":51.68,"w2":12760,"rpm3":32.08,"filterRpm_3":38.68,"w3":12760}
14:22:40.013 -> {"millis":2124267,"rpm1":48.13,"filterRpm_1":43.81,"w1":12780,"rpm2":48.13,"filterRpm_2":51.26,"w2":12780,"rpm3":48.13,"filterRpm_3":38.85,"w3":12780}
14:22:40.013 -> {"millis":2124277,"rpm1":32.09,"filterRpm_1":43.37,"w1":12800,"rpm2":64.17,"filterRpm_2":51.84,"w2":12800,"rpm3":32.09,"filterRpm_3":38.99,"w3":12800}
14:22:40.013 -> {"millis":2124287,"rpm1":48.12,"filterRpm_1":42.99,"w1":12820,"rpm2":48.12,"filterRpm_2":52.35,"w2":12820,"rpm3":48.12,"filterRpm_3":39.13,"w3":12820}
14:22:40.013 -> {"millis":2124297,"rpm1":48.13,"filterRpm_1":43.59,"w1":12840,"rpm2":64.18,"filterRpm_2":52.80,"w2":12840,"rpm3":32.09,"filterRpm_3":39.24,"w3":12840}
14:22:40.059 -> {"millis":2124307,"rpm1":48.13,"filterRpm_1":44.13,"w1":12860,"rpm2":48.13,"filterRpm_2":53.19,"w2":12860,"rpm3":48.13,"filterRpm_3":39.34,"w3":12860}
14:22:40.059 -> {"millis":2124317,"rpm1":48.13,"filterRpm_1":44.60,"w1":12880,"rpm2":48.13,"filterRpm_2":52.60,"w2":12880,"rpm3":32.09,"filterRpm_3":39.43,"w3":12880}
14:22:40.059 -> {"millis":2124327,"rpm1":48.13,"filterRpm_1":45.02,"w1":12900,"rpm2":64.17,"filterRpm_2":53.02,"w2":12900,"rpm3":48.13,"filterRpm_3":39.51,"w3":12900}
14:22:40.059 -> {"millis":2124337,"rpm1":32.09,"filterRpm_1":44.44,"w1":12920,"rpm2":48.13,"filterRpm_2":53.39,"w2":12920,"rpm3":48.13,"filterRpm_3":40.53,"w3":12920}
14:22:40.105 -> {"millis":2124347,"rpm1":48.13,"filterRpm_1":43.93,"w1":12940,"rpm2":64.17,"filterRpm_2":53.71,"w2":12940,"rpm3":32.09,"filterRpm_3":40.48,"w3":12940}
14:22:40.105 -> {"millis":2124357,"rpm1":48.12,"filterRpm_1":44.42,"w1":12960,"rpm2":48.12,"filterRpm_2":54.00,"w2":12960,"rpm3":48.12,"filterRpm_3":40.44,"w3":12960}
14:22:40.105 -> {"millis":2124367,"rpm1":48.13,"filterRpm_1":44.86,"w1":12980,"rpm2":64.18,"filterRpm_2":54.25,"w2":12980,"rpm3":32.09,"filterRpm_3":40.40,"w3":12980}
14:22:40.105 -> {"millis":2124377,"rpm1":48.13,"filterRpm_1":45.25,"w1":13000,"rpm2":48.13,"filterRpm_2":54.48,"w2":13000,"rpm3":48.13,"filterRpm_3":40.36,"w3":13000}
14:22:40.105 -> {"millis":2124387,"rpm1":48.13,"filterRpm_1":45.59,"w1":13020,"rpm2":64.17,"filterRpm_2":54.68,"w2":13020,"rpm3":48.13,"filterRpm_3":41.28,"w3":13020}
14:22:40.151 -> {"millis":2124397,"rpm1":48.12,"filterRpm_1":45.89,"w1":13040,"rpm2":64.16,"filterRpm_2":55.80,"w2":13040,"rpm3":32.08,"filterRpm_3":41.14,"w3":13040}
14:22:40.151 -> {"millis":2124407,"rpm1":48.13,"filterRpm_1":46.15,"w1":13060,"rpm2":48.13,"filterRpm_2":55.84,"w2":13060,"rpm3":48.13,"filterRpm_3":41.02,"w3":13060}
14:22:40.151 -> {"millis":2124417,"rpm1":48.13,"filterRpm_1":46.39,"w1":13080,"rpm2":64.17,"filterRpm_2":55.88,"w2":13080,"rpm3":48.13,"filterRpm_3":41.86,"w3":13080}
14:22:40.151 -> {"millis":2124427,"rpm1":48.13,"filterRpm_1":46.59,"w1":13100,"rpm2":48.13,"filterRpm_2":55.91,"w2":13100,"rpm3":48.13,"filterRpm_3":42.60,"w3":13100}
14:22:40.197 -> {"millis":2124437,"rpm1":48.13,"filterRpm_1":46.77,"w1":13120,"rpm2":64.17,"filterRpm_2":55.94,"w2":13120,"rpm3":32.09,"filterRpm_3":42.31,"w3":13120}
14:22:40.197 -> {"millis":2124447,"rpm1":48.13,"filterRpm_1":46.93,"w1":13140,"rpm2":64.17,"filterRpm_2":56.91,"w2":13140,"rpm3":48.13,"filterRpm_3":42.05,"w3":13140}
14:22:40.197 -> {"millis":2124457,"rpm1":48.13,"filterRpm_1":47.08,"w1":13160,"rpm2":48.13,"filterRpm_2":56.82,"w2":13160,"rpm3":48.13,"filterRpm_3":42.77,"w3":13160}
14:22:40.197 -> {"millis":2124467,"rpm1":48.13,"filterRpm_1":47.20,"w1":13180,"rpm2":64.17,"filterRpm_2":56.74,"w2":13180,"rpm3":48.13,"filterRpm_3":43.40,"w3":13180}
14:22:40.197 -> {"millis":2124477,"rpm1":48.12,"filterRpm_1":47.31,"w1":13200,"rpm2":64.16,"filterRpm_2":57.62,"w2":13200,"rpm3":32.08,"filterRpm_3":43.01,"w3":13200}
14:22:40.244 -> {"millis":2124487,"rpm1":48.13,"filterRpm_1":47.41,"w1":13220,"rpm2":48.13,"filterRpm_2":57.45,"w2":13220,"rpm3":48.13,"filterRpm_3":42.67,"w3":13220}
14:22:40.244 -> {"millis":2124497,"rpm1":48.12,"filterRpm_1":47.49,"w1":13240,"rpm2":64.16,"filterRpm_2":57.29,"w2":13240,"rpm3":48.12,"filterRpm_3":43.31,"w3":13240}
14:22:40.244 -> {"millis":2124507,"rpm1":64.18,"filterRpm_1":48.52,"w1":13260,"rpm2":64.18,"filterRpm_2":58.11,"w2":13260,"rpm3":48.13,"filterRpm_3":43.88,"w3":13260}
14:22:40.244 -> {"millis":2124517,"rpm1":48.13,"filterRpm_1":49.42,"w1":13280,"rpm2":64.17,"filterRpm_2":58.82,"w2":13280,"rpm3":32.09,"filterRpm_3":43.44,"w3":13280}
14:22:40.244 -> {"millis":2124527,"rpm1":48.13,"filterRpm_1":49.27,"w1":13300,"rpm2":48.13,"filterRpm_2":58.51,"w2":13300,"rpm3":48.13,"filterRpm_3":43.04,"w3":13300}
14:22:40.290 -> {"millis":2124537,"rpm1":48.13,"filterRpm_1":49.13,"w1":13320,"rpm2":64.17,"filterRpm_2":58.23,"w2":13320,"rpm3":48.13,"filterRpm_3":43.64,"w3":13320}
14:22:40.290 -> {"millis":2124547,"rpm1":48.13,"filterRpm_1":49.01,"w1":13340,"rpm2":64.17,"filterRpm_2":58.93,"w2":13340,"rpm3":48.13,"filterRpm_3":44.17,"w3":13340}
14:22:40.290 -> {"millis":2124557,"rpm1":48.13,"filterRpm_1":48.91,"w1":13360,"rpm2":64.17,"filterRpm_2":59.55,"w2":13360,"rpm3":48.13,"filterRpm_3":44.64,"w3":13360}
14:22:40.290 -> {"millis":2124567,"rpm1":48.13,"filterRpm_1":48.82,"w1":13380,"rpm2":64.17,"filterRpm_2":60.10,"w2":13380,"rpm3":48.13,"filterRpm_3":45.05,"w3":13380}
14:22:40.336 -> {"millis":2124577,"rpm1":64.17,"filterRpm_1":49.68,"w1":13400,"rpm2":64.17,"filterRpm_2":60.58,"w2":13400,"rpm3":48.13,"filterRpm_3":45.42,"w3":13400}
14:22:40.336 -> {"millis":2124587,"rpm1":48.13,"filterRpm_1":50.45,"w1":13420,"rpm2":48.13,"filterRpm_2":60.05,"w2":13420,"rpm3":32.09,"filterRpm_3":44.79,"w3":13420}
14:22:40.336 -> {"millis":2124597,"rpm1":48.12,"filterRpm_1":50.17,"w1":13440,"rpm2":64.16,"filterRpm_2":59.59,"w2":13440,"rpm3":48.12,"filterRpm_3":44.24,"w3":13440}
14:22:40.336 -> {"millis":2124607,"rpm1":48.13,"filterRpm_1":49.93,"w1":13460,"rpm2":64.18,"filterRpm_2":60.13,"w2":13460,"rpm3":48.13,"filterRpm_3":44.70,"w3":13460}
14:22:40.336 -> {"millis":2124617,"rpm1":64.17,"filterRpm_1":50.67,"w1":13480,"rpm2":64.17,"filterRpm_2":60.61,"w2":13480,"rpm3":48.13,"filterRpm_3":45.10,"w3":13480}
14:22:40.382 -> {"millis":2124627,"rpm1":48.13,"filterRpm_1":51.32,"w1":13500,"rpm2":64.17,"filterRpm_2":61.03,"w2":13500,"rpm3":48.13,"filterRpm_3":45.46,"w3":13500}
14:22:40.382 -> {"millis":2124637,"rpm1":48.13,"filterRpm_1":50.94,"w1":13520,"rpm2":64.17,"filterRpm_2":61.40,"w2":13520,"rpm3":48.13,"filterRpm_3":45.78,"w3":13520}
14:22:40.382 -> {"millis":2124647,"rpm1":64.17,"filterRpm_1":51.55,"w1":13540,"rpm2":64.17,"filterRpm_2":61.73,"w2":13540,"rpm3":48.13,"filterRpm_3":46.05,"w3":13540}
14:22:40.382 -> {"millis":2124657,"rpm1":48.13,"filterRpm_1":52.10,"w1":13560,"rpm2":64.17,"filterRpm_2":62.02,"w2":13560,"rpm3":48.13,"filterRpm_3":46.30,"w3":13560}
14:22:40.382 -> {"millis":2124667,"rpm1":48.13,"filterRpm_1":51.63,"w1":13580,"rpm2":64.17,"filterRpm_2":62.27,"w2":13580,"rpm3":48.13,"filterRpm_3":46.52,"w3":13580}
14:22:40.429 -> {"millis":2124677,"rpm1":64.16,"filterRpm_1":52.16,"w1":13600,"rpm2":64.16,"filterRpm_2":62.50,"w2":13600,"rpm3":48.12,"filterRpm_3":46.71,"w3":13600}
14:22:40.429 -> {"millis":2124687,"rpm1":48.13,"filterRpm_1":52.63,"w1":13620,"rpm2":64.18,"filterRpm_2":62.70,"w2":13620,"rpm3":48.13,"filterRpm_3":46.87,"w3":13620}
14:22:40.429 -> {"millis":2124697,"rpm1":48.13,"filterRpm_1":52.10,"w1":13640,"rpm2":64.17,"filterRpm_2":62.87,"w2":13640,"rpm3":48.13,"filterRpm_3":47.02,"w3":13640}
14:22:40.429 -> {"millis":2124707,"rpm1":64.16,"filterRpm_1":52.58,"w1":13660,"rpm2":64.16,"filterRpm_2":63.02,"w2":13660,"rpm3":48.12,"filterRpm_3":47.15,"w3":13660}
14:22:40.475 -> {"millis":2124717,"rpm1":48.13,"filterRpm_1":53.00,"w1":13680,"rpm2":64.17,"filterRpm_2":63.16,"w2":13680,"rpm3":48.13,"filterRpm_3":47.27,"w3":13680}
14:22:40.475 -> {"millis":2124727,"rpm1":64.18,"filterRpm_1":53.37,"w1":13700,"rpm2":64.18,"filterRpm_2":63.28,"w2":13700,"rpm3":48.13,"filterRpm_3":47.37,"w3":13700}
14:22:40.475 -> {"millis":2124737,"rpm1":48.13,"filterRpm_1":53.70,"w1":13720,"rpm2":64.17,"filterRpm_2":63.38,"w2":13720,"rpm3":48.13,"filterRpm_3":47.46,"w3":13720}
14:22:40.475 -> {"millis":2124747,"rpm1":64.17,"filterRpm_1":53.99,"w1":13740,"rpm2":64.17,"filterRpm_2":63.48,"w2":13740,"rpm3":64.17,"filterRpm_3":48.49,"w3":13740}
14:22:40.475 -> {"millis":2124757,"rpm1":48.13,"filterRpm_1":54.25,"w1":13760,"rpm2":64.17,"filterRpm_2":63.56,"w2":13760,"rpm3":48.13,"filterRpm_3":49.39,"w3":13760}
14:22:40.522 -> {"millis":2124767,"rpm1":64.17,"filterRpm_1":54.47,"w1":13780,"rpm2":64.17,"filterRpm_2":63.63,"w2":13780,"rpm3":48.13,"filterRpm_3":49.24,"w3":13780}
14:22:40.522 -> {"millis":2124777,"rpm1":48.13,"filterRpm_1":54.67,"w1":13800,"rpm2":64.17,"filterRpm_2":63.70,"w2":13800,"rpm3":48.13,"filterRpm_3":49.11,"w3":13800}
14:22:40.522 -> {"millis":2124787,"rpm1":64.17,"filterRpm_1":54.85,"w1":13820,"rpm2":64.17,"filterRpm_2":63.75,"w2":13820,"rpm3":48.13,"filterRpm_3":49.00,"w3":13820}
14:22:40.522 -> {"millis":2124797,"rpm1":48.13,"filterRpm_1":55.00,"w1":13840,"rpm2":64.17,"filterRpm_2":63.80,"w2":13840,"rpm3":48.13,"filterRpm_3":48.89,"w3":13840}
14:22:40.567 -> {"millis":2124807,"rpm1":64.17,"filterRpm_1":55.14,"w1":13860,"rpm2":80.21,"filterRpm_2":64.79,"w2":13860,"rpm3":64.17,"filterRpm_3":49.75,"w3":13860}
14:22:40.567 -> {"millis":2124817,"rpm1":48.13,"filterRpm_1":55.26,"w1":13880,"rpm2":64.17,"filterRpm_2":65.67,"w2":13880,"rpm3":48.13,"filterRpm_3":50.51,"w3":13880}
14:22:40.567 -> {"millis":2124827,"rpm1":64.17,"filterRpm_1":55.36,"w1":13900,"rpm2":64.17,"filterRpm_2":65.49,"w2":13900,"rpm3":48.13,"filterRpm_3":50.23,"w3":13900}
14:22:40.567 -> {"millis":2124837,"rpm1":64.17,"filterRpm_1":56.40,"w1":13920,"rpm2":64.17,"filterRpm_2":65.34,"w2":13920,"rpm3":48.13,"filterRpm_3":49.98,"w3":13920}
14:22:40.567 -> {"millis":2124847,"rpm1":48.13,"filterRpm_1":56.37,"w1":13940,"rpm2":64.17,"filterRpm_2":65.20,"w2":13940,"rpm3":64.17,"filterRpm_3":50.71,"w3":13940}
14:22:40.613 -> {"millis":2124857,"rpm1":64.17,"filterRpm_1":56.35,"w1":13960,"rpm2":80.21,"filterRpm_2":66.02,"w2":13960,"rpm3":48.13,"filterRpm_3":51.35,"w3":13960}
14:22:40.613 -> {"millis":2124867,"rpm1":64.17,"filterRpm_1":57.27,"w1":13980,"rpm2":64.17,"filterRpm_2":66.75,"w2":13980,"rpm3":48.13,"filterRpm_3":50.97,"w3":13980}
14:22:40.613 -> {"millis":2124877,"rpm1":48.12,"filterRpm_1":57.14,"w1":14000,"rpm2":64.16,"filterRpm_2":66.45,"w2":14000,"rpm3":48.12,"filterRpm_3":50.63,"w3":14000}
14:22:40.613 -> {"millis":2124887,"rpm1":64.18,"filterRpm_1":57.02,"w1":14020,"rpm2":64.18,"filterRpm_2":66.18,"w2":14020,"rpm3":64.18,"filterRpm_3":51.29,"w3":14020}
14:22:40.613 -> {"millis":2124897,"rpm1":64.17,"filterRpm_1":57.87,"w1":14040,"rpm2":80.21,"filterRpm_2":66.89,"w2":14040,"rpm3":48.13,"filterRpm_3":51.86,"w3":14040}
14:22:40.660 -> {"millis":2124907,"rpm1":48.13,"filterRpm_1":57.66,"w1":14060,"rpm2":64.17,"filterRpm_2":67.52,"w2":14060,"rpm3":48.13,"filterRpm_3":51.42,"w3":14060}
14:22:40.660 -> {"millis":2124917,"rpm1":64.17,"filterRpm_1":57.49,"w1":14080,"rpm2":64.17,"filterRpm_2":67.12,"w2":14080,"rpm3":64.17,"filterRpm_3":51.98,"w3":14080}
14:22:40.660 -> {"millis":2124927,"rpm1":64.17,"filterRpm_1":58.28,"w1":14100,"rpm2":80.21,"filterRpm_2":67.72,"w2":14100,"rpm3":48.13,"filterRpm_3":52.47,"w3":14100}
14:22:40.660 -> {"millis":2124937,"rpm1":64.16,"filterRpm_1":58.97,"w1":14120,"rpm2":64.16,"filterRpm_2":68.25,"w2":14120,"rpm3":48.12,"filterRpm_3":51.96,"w3":14120}
14:22:40.706 -> {"millis":2124947,"rpm1":48.13,"filterRpm_1":58.64,"w1":14140,"rpm2":64.18,"filterRpm_2":67.77,"w2":14140,"rpm3":64.18,"filterRpm_3":52.45,"w3":14140}
14:22:40.706 -> {"millis":2124957,"rpm1":64.16,"filterRpm_1":58.34,"w1":14160,"rpm2":80.21,"filterRpm_2":68.29,"w2":14160,"rpm3":48.12,"filterRpm_3":52.89,"w3":14160}
14:22:40.706 -> {"millis":2124967,"rpm1":64.18,"filterRpm_1":59.03,"w1":14180,"rpm2":64.18,"filterRpm_2":68.75,"w2":14180,"rpm3":48.13,"filterRpm_3":52.33,"w3":14180}
14:22:40.706 -> {"millis":2124977,"rpm1":64.17,"filterRpm_1":59.64,"w1":14200,"rpm2":64.17,"filterRpm_2":68.21,"w2":14200,"rpm3":64.17,"filterRpm_3":52.78,"w3":14200}
14:22:40.706 -> {"millis":2124987,"rpm1":64.17,"filterRpm_1":60.18,"w1":14220,"rpm2":80.21,"filterRpm_2":68.68,"w2":14220,"rpm3":48.13,"filterRpm_3":53.18,"w3":14220}
14:22:40.752 -> {"millis":2124997,"rpm1":64.17,"filterRpm_1":60.65,"w1":14240,"rpm2":64.17,"filterRpm_2":69.10,"w2":14240,"rpm3":64.17,"filterRpm_3":53.53,"w3":14240}
14:22:40.752 -> {"millis":2125007,"rpm1":48.13,"filterRpm_1":60.12,"w1":14260,"rpm2":80.21,"filterRpm_2":69.46,"w2":14260,"rpm3":48.13,"filterRpm_3":53.84,"w3":14260}
14:22:40.752 -> {"millis":2125017,"rpm1":64.17,"filterRpm_1":59.65,"w1":14280,"rpm2":64.17,"filterRpm_2":69.79,"w2":14280,"rpm3":64.17,"filterRpm_3":54.11,"w3":14280}
14:22:40.752 -> {"millis":2125027,"rpm1":64.16,"filterRpm_1":60.18,"w1":14300,"rpm2":64.16,"filterRpm_2":69.12,"w2":14300,"rpm3":48.12,"filterRpm_3":54.35,"w3":14300}
14:22:40.752 -> {"millis":2125037,"rpm1":64.18,"filterRpm_1":60.65,"w1":14320,"rpm2":80.22,"filterRpm_2":69.48,"w2":14320,"rpm3":64.18,"filterRpm_3":54.57,"w3":14320}
14:22:40.798 -> {"millis":2125047,"rpm1":64.16,"filterRpm_1":61.07,"w1":14340,"rpm2":64.16,"filterRpm_2":69.80,"w2":14340,"rpm3":48.12,"filterRpm_3":54.75,"w3":14340}
14:22:40.798 -> {"millis":2125057,"rpm1":64.18,"filterRpm_1":61.44,"w1":14360,"rpm2":80.22,"filterRpm_2":70.09,"w2":14360,"rpm3":64.18,"filterRpm_3":54.92,"w3":14360}
14:22:40.798 -> {"millis":2125067,"rpm1":64.17,"filterRpm_1":61.76,"w1":14380,"rpm2":64.17,"filterRpm_2":70.34,"w2":14380,"rpm3":48.13,"filterRpm_3":55.06,"w3":14380}
14:22:40.798 -> {"millis":2125077,"rpm1":64.16,"filterRpm_1":62.04,"w1":14400,"rpm2":80.21,"filterRpm_2":70.56,"w2":14400,"rpm3":64.16,"filterRpm_3":55.19,"w3":14400}
14:22:40.844 -> {"millis":2125087,"rpm1":64.18,"filterRpm_1":62.30,"w1":14420,"rpm2":64.18,"filterRpm_2":70.75,"w2":14420,"rpm3":48.13,"filterRpm_3":55.31,"w3":14420}
14:22:40.844 -> {"millis":2125097,"rpm1":64.17,"filterRpm_1":62.52,"w1":14440,"rpm2":80.21,"filterRpm_2":70.92,"w2":14440,"rpm3":64.17,"filterRpm_3":55.41,"w3":14440}
14:22:40.844 -> {"millis":2125107,"rpm1":64.17,"filterRpm_1":62.71,"w1":14460,"rpm2":80.21,"filterRpm_2":72.02,"w2":14460,"rpm3":48.13,"filterRpm_3":55.49,"w3":14460}
14:22:40.844 -> {"millis":2125117,"rpm1":64.17,"filterRpm_1":62.89,"w1":14480,"rpm2":64.17,"filterRpm_2":72.04,"w2":14480,"rpm3":64.17,"filterRpm_3":55.57,"w3":14480}
14:22:40.844 -> {"millis":2125127,"rpm1":64.17,"filterRpm_1":63.04,"w1":14500,"rpm2":80.21,"filterRpm_2":72.06,"w2":14500,"rpm3":48.13,"filterRpm_3":55.64,"w3":14500}
14:22:40.890 -> {"millis":2125137,"rpm1":64.16,"filterRpm_1":63.17,"w1":14520,"rpm2":64.16,"filterRpm_2":72.07,"w2":14520,"rpm3":64.16,"filterRpm_3":55.70,"w3":14520}
14:22:40.890 -> {"millis":2125147,"rpm1":64.17,"filterRpm_1":63.29,"w1":14540,"rpm2":80.21,"filterRpm_2":72.09,"w2":14540,"rpm3":64.17,"filterRpm_3":56.70,"w3":14540}
14:22:40.890 -> {"millis":2125157,"rpm1":64.18,"filterRpm_1":63.39,"w1":14560,"rpm2":64.18,"filterRpm_2":72.10,"w2":14560,"rpm3":48.13,"filterRpm_3":56.64,"w3":14560}
14:22:40.890 -> {"millis":2125167,"rpm1":64.17,"filterRpm_1":63.49,"w1":14580,"rpm2":80.21,"filterRpm_2":72.11,"w2":14580,"rpm3":64.17,"filterRpm_3":56.58,"w3":14580}
14:22:40.936 -> {"millis":2125177,"rpm1":64.17,"filterRpm_1":63.57,"w1":14600,"rpm2":80.21,"filterRpm_2":73.07,"w2":14600,"rpm3":48.13,"filterRpm_3":56.53,"w3":14600}
14:22:40.936 -> {"millis":2125187,"rpm1":64.17,"filterRpm_1":63.64,"w1":14620,"rpm2":64.17,"filterRpm_2":72.97,"w2":14620,"rpm3":64.17,"filterRpm_3":56.48,"w3":14620}
14:22:40.936 -> {"millis":2125197,"rpm1":64.17,"filterRpm_1":63.70,"w1":14640,"rpm2":80.21,"filterRpm_2":72.87,"w2":14640,"rpm3":64.17,"filterRpm_3":57.39,"w3":14640}
14:22:40.936 -> {"millis":2125207,"rpm1":64.17,"filterRpm_1":63.76,"w1":14660,"rpm2":80.21,"filterRpm_2":73.74,"w2":14660,"rpm3":48.13,"filterRpm_3":57.25,"w3":14660}
14:22:40.936 -> {"millis":2125217,"rpm1":64.17,"filterRpm_1":63.81,"w1":14680,"rpm2":64.17,"filterRpm_2":73.56,"w2":14680,"rpm3":64.17,"filterRpm_3":57.12,"w3":14680}
14:22:40.982 -> {"millis":2125227,"rpm1":64.16,"filterRpm_1":63.85,"w1":14700,"rpm2":80.21,"filterRpm_2":73.40,"w2":14700,"rpm3":64.16,"filterRpm_3":57.95,"w3":14700}
14:22:40.982 -> {"millis":2125237,"rpm1":64.18,"filterRpm_1":63.89,"w1":14720,"rpm2":80.22,"filterRpm_2":74.20,"w2":14720,"rpm3":48.13,"filterRpm_3":57.74,"w3":14720}
14:22:40.982 -> {"millis":2125247,"rpm1":64.17,"filterRpm_1":63.92,"w1":14740,"rpm2":64.17,"filterRpm_2":73.97,"w2":14740,"rpm3":64.17,"filterRpm_3":57.55,"w3":14740}
14:22:40.982 -> {"millis":2125257,"rpm1":64.17,"filterRpm_1":63.95,"w1":14760,"rpm2":80.21,"filterRpm_2":73.76,"w2":14760,"rpm3":64.17,"filterRpm_3":58.33,"w3":14760}
14:22:40.982 -> {"millis":2125267,"rpm1":80.21,"filterRpm_1":64.92,"w1":14780,"rpm2":80.21,"filterRpm_2":74.52,"w2":14780,"rpm3":64.17,"filterRpm_3":59.02,"w3":14780}
14:22:41.028 -> {"millis":2125277,"rpm1":64.17,"filterRpm_1":65.78,"w1":14800,"rpm2":64.17,"filterRpm_2":74.24,"w2":14800,"rpm3":48.13,"filterRpm_3":58.68,"w3":14800}
14:22:41.028 -> {"millis":2125287,"rpm1":64.17,"filterRpm_1":65.59,"w1":14820,"rpm2":80.21,"filterRpm_2":74.00,"w2":14820,"rpm3":64.17,"filterRpm_3":58.38,"w3":14820}
14:22:41.028 -> {"millis":2125297,"rpm1":64.17,"filterRpm_1":65.43,"w1":14840,"rpm2":80.21,"filterRpm_2":74.74,"w2":14840,"rpm3":64.17,"filterRpm_3":59.07,"w3":14840}
14:22:41.028 -> {"millis":2125307,"rpm1":64.17,"filterRpm_1":65.28,"w1":14860,"rpm2":80.21,"filterRpm_2":75.38,"w2":14860,"rpm3":64.17,"filterRpm_3":59.67,"w3":14860}
14:22:41.075 -> {"millis":2125317,"rpm1":64.16,"filterRpm_1":65.15,"w1":14880,"rpm2":64.16,"filterRpm_2":75.01,"w2":14880,"rpm3":48.12,"filterRpm_3":59.25,"w3":14880}
14:22:41.075 -> {"millis":2125327,"rpm1":80.22,"filterRpm_1":65.98,"w1":14900,"rpm2":80.22,"filterRpm_2":74.67,"w2":14900,"rpm3":64.18,"filterRpm_3":58.89,"w3":14900}
14:22:41.075 -> {"millis":2125337,"rpm1":64.17,"filterRpm_1":66.71,"w1":14920,"rpm2":80.21,"filterRpm_2":75.33,"w2":14920,"rpm3":64.17,"filterRpm_3":59.51,"w3":14920}
14:22:41.075 -> {"millis":2125347,"rpm1":64.17,"filterRpm_1":66.41,"w1":14940,"rpm2":80.21,"filterRpm_2":75.91,"w2":14940,"rpm3":64.17,"filterRpm_3":60.06,"w3":14940}
14:22:41.075 -> {"millis":2125357,"rpm1":64.16,"filterRpm_1":66.15,"w1":14960,"rpm2":80.21,"filterRpm_2":76.42,"w2":14960,"rpm3":64.16,"filterRpm_3":60.55,"w3":14960}
14:22:41.120 -> {"millis":2125367,"rpm1":80.22,"filterRpm_1":66.86,"w1":14980,"rpm2":80.22,"filterRpm_2":76.86,"w2":14980,"rpm3":64.18,"filterRpm_3":60.98,"w3":14980}
14:22:41.120 -> {"millis":2125377,"rpm1":64.17,"filterRpm_1":67.49,"w1":15000,"rpm2":64.17,"filterRpm_2":76.31,"w2":15000,"rpm3":48.13,"filterRpm_3":60.41,"w3":15000}
14:22:41.120 -> {"millis":2125387,"rpm1":64.17,"filterRpm_1":67.10,"w1":15020,"rpm2":80.21,"filterRpm_2":75.83,"w2":15020,"rpm3":64.17,"filterRpm_3":59.90,"w3":15020}
14:22:41.120 -> {"millis":2125397,"rpm1":80.21,"filterRpm_1":67.70,"w1":15040,"rpm2":80.21,"filterRpm_2":76.34,"w2":15040,"rpm3":64.17,"filterRpm_3":60.41,"w3":15040}
14:22:41.167 -> {"millis":2125407,"rpm1":64.17,"filterRpm_1":68.23,"w1":15060,"rpm2":80.21,"filterRpm_2":76.80,"w2":15060,"rpm3":64.17,"filterRpm_3":60.85,"w3":15060}
14:22:41.167 -> {"millis":2125417,"rpm1":64.17,"filterRpm_1":67.75,"w1":15080,"rpm2":80.21,"filterRpm_2":77.21,"w2":15080,"rpm3":64.17,"filterRpm_3":61.25,"w3":15080}
14:22:41.167 -> {"millis":2125427,"rpm1":80.21,"filterRpm_1":68.28,"w1":15100,"rpm2":80.21,"filterRpm_2":77.56,"w2":15100,"rpm3":64.16,"filterRpm_3":61.59,"w3":15100}
14:22:41.167 -> {"millis":2125437,"rpm1":64.18,"filterRpm_1":68.74,"w1":15120,"rpm2":80.22,"filterRpm_2":77.87,"w2":15120,"rpm3":64.18,"filterRpm_3":61.90,"w3":15120}
14:22:41.167 -> {"millis":2125447,"rpm1":64.17,"filterRpm_1":68.20,"w1":15140,"rpm2":80.21,"filterRpm_2":78.15,"w2":15140,"rpm3":64.17,"filterRpm_3":62.17,"w3":15140}
14:22:41.212 -> {"millis":2125457,"rpm1":80.21,"filterRpm_1":68.67,"w1":15160,"rpm2":80.21,"filterRpm_2":78.40,"w2":15160,"rpm3":64.17,"filterRpm_3":62.40,"w3":15160}
14:22:41.212 -> {"millis":2125467,"rpm1":64.17,"filterRpm_1":69.09,"w1":15180,"rpm2":80.21,"filterRpm_2":78.61,"w2":15180,"rpm3":64.17,"filterRpm_3":62.61,"w3":15180}
14:22:41.212 -> {"millis":2125477,"rpm1":80.21,"filterRpm_1":69.46,"w1":15200,"rpm2":80.21,"filterRpm_2":78.80,"w2":15200,"rpm3":64.17,"filterRpm_3":62.80,"w3":15200}
14:22:41.212 -> {"millis":2125487,"rpm1":64.17,"filterRpm_1":69.78,"w1":15220,"rpm2":80.21,"filterRpm_2":78.97,"w2":15220,"rpm3":64.17,"filterRpm_3":62.96,"w3":15220}
14:22:41.212 -> {"millis":2125497,"rpm1":80.21,"filterRpm_1":70.06,"w1":15240,"rpm2":80.21,"filterRpm_2":79.11,"w2":15240,"rpm3":64.17,"filterRpm_3":63.10,"w3":15240}
14:22:41.259 -> {"millis":2125507,"rpm1":64.17,"filterRpm_1":70.32,"w1":15260,"rpm2":80.21,"filterRpm_2":79.24,"w2":15260,"rpm3":64.17,"filterRpm_3":63.23,"w3":15260}
14:22:41.259 -> {"millis":2125517,"rpm1":80.21,"filterRpm_1":70.54,"w1":15280,"rpm2":80.21,"filterRpm_2":79.36,"w2":15280,"rpm3":64.17,"filterRpm_3":63.34,"w3":15280}
14:22:41.259 -> {"millis":2125527,"rpm1":64.17,"filterRpm_1":70.73,"w1":15300,"rpm2":80.21,"filterRpm_2":79.46,"w2":15300,"rpm3":64.17,"filterRpm_3":63.44,"w3":15300}
14:22:41.259 -> {"millis":2125537,"rpm1":80.21,"filterRpm_1":70.91,"w1":15320,"rpm2":80.21,"filterRpm_2":79.55,"w2":15320,"rpm3":64.17,"filterRpm_3":63.52,"w3":15320}
14:22:41.305 -> {"millis":2125547,"rpm1":64.17,"filterRpm_1":71.06,"w1":15340,"rpm2":80.21,"filterRpm_2":79.63,"w2":15340,"rpm3":64.17,"filterRpm_3":63.60,"w3":15340}
14:22:41.305 -> {"millis":2125557,"rpm1":80.21,"filterRpm_1":71.19,"w1":15360,"rpm2":80.21,"filterRpm_2":79.70,"w2":15360,"rpm3":64.16,"filterRpm_3":63.67,"w3":15360}
14:22:41.305 -> {"millis":2125567,"rpm1":64.18,"filterRpm_1":71.31,"w1":15380,"rpm2":80.22,"filterRpm_2":79.76,"w2":15380,"rpm3":64.18,"filterRpm_3":63.73,"w3":15380}
14:22:41.305 -> {"millis":2125577,"rpm1":80.21,"filterRpm_1":71.41,"w1":15400,"rpm2":80.21,"filterRpm_2":79.81,"w2":15400,"rpm3":64.17,"filterRpm_3":63.78,"w3":15400}
14:22:41.305 -> {"millis":2125587,"rpm1":64.17,"filterRpm_1":71.51,"w1":15420,"rpm2":96.26,"filterRpm_2":80.81,"w2":15420,"rpm3":80.21,"filterRpm_3":64.77,"w3":15420}
14:22:41.351 -> {"millis":2125597,"rpm1":80.21,"filterRpm_1":71.59,"w1":15440,"rpm2":80.21,"filterRpm_2":81.69,"w2":15440,"rpm3":64.17,"filterRpm_3":65.65,"w3":15440}
14:22:41.351 -> {"millis":2125607,"rpm1":80.21,"filterRpm_1":72.61,"w1":15460,"rpm2":80.21,"filterRpm_2":81.51,"w2":15460,"rpm3":64.16,"filterRpm_3":65.48,"w3":15460}
14:22:41.351 -> {"millis":2125617,"rpm1":64.18,"filterRpm_1":72.56,"w1":15480,"rpm2":80.22,"filterRpm_2":81.36,"w2":15480,"rpm3":64.18,"filterRpm_3":65.32,"w3":15480}
14:22:41.351 -> {"millis":2125627,"rpm1":80.21,"filterRpm_1":72.52,"w1":15500,"rpm2":80.21,"filterRpm_2":81.22,"w2":15500,"rpm3":64.17,"filterRpm_3":65.19,"w3":15500}
14:22:41.397 -> {"millis":2125637,"rpm1":80.21,"filterRpm_1":73.42,"w1":15520,"rpm2":80.21,"filterRpm_2":81.10,"w2":15520,"rpm3":64.16,"filterRpm_3":65.07,"w3":15520}
14:22:41.397 -> {"millis":2125647,"rpm1":64.18,"filterRpm_1":73.28,"w1":15540,"rpm2":96.27,"filterRpm_2":81.95,"w2":15540,"rpm3":80.22,"filterRpm_3":65.91,"w3":15540}
14:22:41.397 -> {"millis":2125657,"rpm1":80.21,"filterRpm_1":73.15,"w1":15560,"rpm2":80.21,"filterRpm_2":82.69,"w2":15560,"rpm3":64.17,"filterRpm_3":66.65,"w3":15560}
14:22:41.397 -> {"millis":2125667,"rpm1":80.21,"filterRpm_1":73.99,"w1":15580,"rpm2":80.21,"filterRpm_2":82.40,"w2":15580,"rpm3":64.17,"filterRpm_3":66.36,"w3":15580}
14:22:41.397 -> {"millis":2125677,"rpm1":80.21,"filterRpm_1":74.72,"w1":15600,"rpm2":80.21,"filterRpm_2":82.14,"w2":15600,"rpm3":64.17,"filterRpm_3":66.10,"w3":15600}
14:22:41.443 -> {"millis":2125687,"rpm1":64.16,"filterRpm_1":74.42,"w1":15620,"rpm2":96.25,"filterRpm_2":82.86,"w2":15620,"rpm3":80.21,"filterRpm_3":66.82,"w3":15620}
14:22:41.443 -> {"millis":2125697,"rpm1":80.22,"filterRpm_1":74.16,"w1":15640,"rpm2":80.22,"filterRpm_2":83.50,"w2":15640,"rpm3":64.18,"filterRpm_3":67.46,"w3":15640}
14:22:41.443 -> {"millis":2125707,"rpm1":80.21,"filterRpm_1":74.88,"w1":15660,"rpm2":80.21,"filterRpm_2":83.11,"w2":15660,"rpm3":64.16,"filterRpm_3":67.07,"w3":15660}
14:22:41.443 -> {"millis":2125717,"rpm1":80.22,"filterRpm_1":75.51,"w1":15680,"rpm2":96.27,"filterRpm_2":83.71,"w2":15680,"rpm3":64.18,"filterRpm_3":66.72,"w3":15680}
14:22:41.443 -> {"millis":2125727,"rpm1":80.20,"filterRpm_1":76.06,"w1":15700,"rpm2":80.20,"filterRpm_2":84.25,"w2":15700,"rpm3":80.20,"filterRpm_3":67.37,"w3":15700}
14:22:41.490 -> {"millis":2125737,"rpm1":64.18,"filterRpm_1":75.60,"w1":15720,"rpm2":80.23,"filterRpm_2":83.77,"w2":15720,"rpm3":64.18,"filterRpm_3":67.94,"w3":15720}
14:22:41.490 -> {"millis":2125747,"rpm1":80.21,"filterRpm_1":75.20,"w1":15740,"rpm2":96.26,"filterRpm_2":84.30,"w2":15740,"rpm3":64.17,"filterRpm_3":67.50,"w3":15740}
14:22:41.490 -> {"millis":2125757,"rpm1":80.21,"filterRpm_1":75.79,"w1":15760,"rpm2":80.21,"filterRpm_2":84.77,"w2":15760,"rpm3":80.21,"filterRpm_3":68.05,"w3":15760}
14:22:41.490 -> {"millis":2125767,"rpm1":80.21,"filterRpm_1":76.32,"w1":15780,"rpm2":80.21,"filterRpm_2":84.23,"w2":15780,"rpm3":64.17,"filterRpm_3":68.54,"w3":15780}
14:22:41.535 -> {"millis":2125777,"rpm1":80.21,"filterRpm_1":76.78,"w1":15800,"rpm2":96.26,"filterRpm_2":84.70,"w2":15800,"rpm3":64.17,"filterRpm_3":68.02,"w3":15800}
14:22:41.535 -> {"millis":2125787,"rpm1":80.21,"filterRpm_1":77.18,"w1":15820,"rpm2":80.21,"filterRpm_2":85.12,"w2":15820,"rpm3":80.21,"filterRpm_3":68.52,"w3":15820}
14:22:41.535 -> {"millis":2125797,"rpm1":80.21,"filterRpm_1":77.54,"w1":15840,"rpm2":80.21,"filterRpm_2":84.54,"w2":15840,"rpm3":64.17,"filterRpm_3":68.95,"w3":15840}
14:22:41.535 -> {"millis":2125807,"rpm1":64.17,"filterRpm_1":76.91,"w1":15860,"rpm2":96.26,"filterRpm_2":84.98,"w2":15860,"rpm3":80.21,"filterRpm_3":69.33,"w3":15860}
14:22:41.535 -> {"millis":2125817,"rpm1":80.21,"filterRpm_1":76.35,"w1":15880,"rpm2":80.21,"filterRpm_2":85.36,"w2":15880,"rpm3":64.17,"filterRpm_3":69.67,"w3":15880}
14:22:41.581 -> {"millis":2125827,"rpm1":80.21,"filterRpm_1":76.81,"w1":15900,"rpm2":96.26,"filterRpm_2":85.70,"w2":15900,"rpm3":64.17,"filterRpm_3":69.02,"w3":15900}
14:22:41.581 -> {"millis":2125837,"rpm1":80.21,"filterRpm_1":77.21,"w1":15920,"rpm2":80.21,"filterRpm_2":86.00,"w2":15920,"rpm3":80.21,"filterRpm_3":69.40,"w3":15920}
14:22:41.581 -> {"millis":2125847,"rpm1":64.17,"filterRpm_1":76.62,"w1":15940,"rpm2":96.26,"filterRpm_2":86.26,"w2":15940,"rpm3":64.17,"filterRpm_3":69.73,"w3":15940}
14:22:41.581 -> {"millis":2125857,"rpm1":80.22,"filterRpm_1":76.09,"w1":15960,"rpm2":80.22,"filterRpm_2":86.50,"w2":15960,"rpm3":80.22,"filterRpm_3":70.02,"w3":15960}
14:22:41.628 -> {"millis":2125867,"rpm1":80.21,"filterRpm_1":76.58,"w1":15980,"rpm2":96.26,"filterRpm_2":86.70,"w2":15980,"rpm3":64.17,"filterRpm_3":70.28,"w3":15980}
14:22:41.628 -> {"millis":2125877,"rpm1":80.21,"filterRpm_1":77.01,"w1":16000,"rpm2":80.21,"filterRpm_2":86.88,"w2":16000,"rpm3":80.21,"filterRpm_3":70.50,"w3":16000}
14:22:41.628 -> {"millis":2125887,"rpm1":80.21,"filterRpm_1":77.39,"w1":16020,"rpm2":96.25,"filterRpm_2":87.04,"w2":16020,"rpm3":64.16,"filterRpm_3":70.70,"w3":16020}
14:22:41.628 -> {"millis":2125897,"rpm1":80.22,"filterRpm_1":77.72,"w1":16040,"rpm2":80.22,"filterRpm_2":87.18,"w2":16040,"rpm3":80.22,"filterRpm_3":70.88,"w3":16040}
14:22:41.628 -> {"millis":2125907,"rpm1":80.21,"filterRpm_1":78.02,"w1":16060,"rpm2":96.25,"filterRpm_2":87.31,"w2":16060,"rpm3":64.16,"filterRpm_3":71.03,"w3":16060}
14:22:41.674 -> {"millis":2125917,"rpm1":80.21,"filterRpm_1":78.28,"w1":16080,"rpm2":80.21,"filterRpm_2":87.42,"w2":16080,"rpm3":80.21,"filterRpm_3":71.17,"w3":16080}
14:22:41.674 -> {"millis":2125927,"rpm1":80.22,"filterRpm_1":78.51,"w1":16100,"rpm2":96.27,"filterRpm_2":87.51,"w2":16100,"rpm3":64.18,"filterRpm_3":71.29,"w3":16100}
14:22:41.674 -> {"millis":2125937,"rpm1":80.21,"filterRpm_1":78.71,"w1":16120,"rpm2":80.21,"filterRpm_2":87.60,"w2":16120,"rpm3":80.21,"filterRpm_3":71.40,"w3":16120}
14:22:41.674 -> {"millis":2125947,"rpm1":80.22,"filterRpm_1":78.89,"w1":16140,"rpm2":96.27,"filterRpm_2":87.68,"w2":16140,"rpm3":80.22,"filterRpm_3":72.44,"w3":16140}
14:22:41.674 -> {"millis":2125957,"rpm1":80.21,"filterRpm_1":79.04,"w1":16160,"rpm2":80.21,"filterRpm_2":87.74,"w2":16160,"rpm3":64.17,"filterRpm_3":72.41,"w3":16160}
14:22:41.720 -> {"millis":2125967,"rpm1":96.26,"filterRpm_1":80.13,"w1":16180,"rpm2":96.26,"filterRpm_2":87.80,"w2":16180,"rpm3":80.21,"filterRpm_3":72.39,"w3":16180}
14:22:41.720 -> {"millis":2125977,"rpm1":80.21,"filterRpm_1":81.09,"w1":16200,"rpm2":80.21,"filterRpm_2":87.85,"w2":16200,"rpm3":64.17,"filterRpm_3":72.36,"w3":16200}
14:22:41.720 -> {"millis":2125987,"rpm1":80.21,"filterRpm_1":80.98,"w1":16220,"rpm2":96.25,"filterRpm_2":87.90,"w2":16220,"rpm3":80.21,"filterRpm_3":72.34,"w3":16220}
14:22:41.720 -> {"millis":2125997,"rpm1":80.21,"filterRpm_1":80.89,"w1":16240,"rpm2":80.21,"filterRpm_2":87.94,"w2":16240,"rpm3":80.21,"filterRpm_3":73.27,"w3":16240}
14:22:41.766 -> {"millis":2126007,"rpm1":80.22,"filterRpm_1":80.81,"w1":16260,"rpm2":96.27,"filterRpm_2":87.97,"w2":16260,"rpm3":64.18,"filterRpm_3":73.15,"w3":16260}
14:22:41.766 -> {"millis":2126017,"rpm1":80.21,"filterRpm_1":80.74,"w1":16280,"rpm2":96.26,"filterRpm_2":88.95,"w2":16280,"rpm3":80.21,"filterRpm_3":73.03,"w3":16280}
14:22:41.766 -> {"millis":2126027,"rpm1":80.21,"filterRpm_1":80.68,"w1":16300,"rpm2":80.21,"filterRpm_2":88.87,"w2":16300,"rpm3":80.21,"filterRpm_3":73.88,"w3":16300}
14:22:41.766 -> {"millis":2126037,"rpm1":80.21,"filterRpm_1":80.63,"w1":16320,"rpm2":96.26,"filterRpm_2":88.79,"w2":16320,"rpm3":64.17,"filterRpm_3":73.68,"w3":16320}
14:22:41.766 -> {"millis":2126047,"rpm1":80.21,"filterRpm_1":80.58,"w1":16340,"rpm2":96.25,"filterRpm_2":89.67,"w2":16340,"rpm3":80.21,"filterRpm_3":73.51,"w3":16340}
14:22:41.812 -> {"millis":2126057,"rpm1":96.26,"filterRpm_1":81.48,"w1":16360,"rpm2":80.21,"filterRpm_2":89.50,"w2":16360,"rpm3":80.21,"filterRpm_3":74.30,"w3":16360}
14:22:41.812 -> {"millis":2126067,"rpm1":80.22,"filterRpm_1":82.28,"w1":16380,"rpm2":96.27,"filterRpm_2":89.35,"w2":16380,"rpm3":64.18,"filterRpm_3":74.05,"w3":16380}
14:22:41.812 -> {"millis":2126077,"rpm1":80.21,"filterRpm_1":82.04,"w1":16400,"rpm2":96.26,"filterRpm_2":90.17,"w2":16400,"rpm3":80.21,"filterRpm_3":73.83,"w3":16400}
14:22:41.812 -> {"millis":2126087,"rpm1":80.21,"filterRpm_1":81.82,"w1":16420,"rpm2":80.21,"filterRpm_2":89.94,"w2":16420,"rpm3":80.21,"filterRpm_3":74.59,"w3":16420}
14:22:41.812 -> {"millis":2126097,"rpm1":80.21,"filterRpm_1":81.63,"w1":16440,"rpm2":96.26,"filterRpm_2":89.74,"w2":16440,"rpm3":80.21,"filterRpm_3":75.25,"w3":16440}
14:22:41.859 -> {"millis":2126107,"rpm1":96.25,"filterRpm_1":82.41,"w1":16460,"rpm2":96.25,"filterRpm_2":90.51,"w2":16460,"rpm3":64.16,"filterRpm_3":74.89,"w3":16460}
14:22:41.859 -> {"millis":2126117,"rpm1":80.22,"filterRpm_1":83.10,"w1":16480,"rpm2":80.22,"filterRpm_2":90.24,"w2":16480,"rpm3":80.22,"filterRpm_3":74.57,"w3":16480}
14:22:41.859 -> {"millis":2126127,"rpm1":80.21,"filterRpm_1":82.76,"w1":16500,"rpm2":96.26,"filterRpm_2":90.00,"w2":16500,"rpm3":80.21,"filterRpm_3":75.24,"w3":16500}
14:22:41.859 -> {"millis":2126137,"rpm1":80.21,"filterRpm_1":82.46,"w1":16520,"rpm2":96.26,"filterRpm_2":90.74,"w2":16520,"rpm3":80.21,"filterRpm_3":75.83,"w3":16520}
14:22:41.905 -> {"millis":2126147,"rpm1":96.26,"filterRpm_1":83.14,"w1":16540,"rpm2":96.26,"filterRpm_2":91.40,"w2":16540,"rpm3":64.17,"filterRpm_3":75.40,"w3":16540}
14:22:41.905 -> {"millis":2126157,"rpm1":80.21,"filterRpm_1":83.74,"w1":16560,"rpm2":80.21,"filterRpm_2":91.02,"w2":16560,"rpm3":80.21,"filterRpm_3":75.02,"w3":16560}
14:22:41.905 -> {"millis":2126167,"rpm1":80.21,"filterRpm_1":83.33,"w1":16580,"rpm2":96.26,"filterRpm_2":90.69,"w2":16580,"rpm3":80.21,"filterRpm_3":75.63,"w3":16580}
14:22:41.905 -> {"millis":2126177,"rpm1":96.26,"filterRpm_1":83.91,"w1":16600,"rpm2":96.26,"filterRpm_2":91.35,"w2":16600,"rpm3":80.21,"filterRpm_3":76.17,"w3":16600}
14:22:41.905 -> {"millis":2126187,"rpm1":80.21,"filterRpm_1":84.42,"w1":16620,"rpm2":96.26,"filterRpm_2":91.93,"w2":16620,"rpm3":80.21,"filterRpm_3":76.65,"w3":16620}
14:22:41.951 -> {"millis":2126197,"rpm1":80.18,"filterRpm_1":83.92,"w1":16640,"rpm2":96.22,"filterRpm_2":92.44,"w2":16640,"rpm3":80.18,"filterRpm_3":77.07,"w3":16640}
14:22:41.951 -> {"millis":2126207,"rpm1":96.30,"filterRpm_1":84.43,"w1":16660,"rpm2":80.25,"filterRpm_2":91.94,"w2":16660,"rpm3":80.25,"filterRpm_3":77.44,"w3":16660}
14:22:41.951 -> {"millis":2126217,"rpm1":80.21,"filterRpm_1":84.88,"w1":16680,"rpm2":96.26,"filterRpm_2":91.51,"w2":16680,"rpm3":64.17,"filterRpm_3":76.82,"w3":16680}
14:22:41.951 -> {"millis":2126227,"rpm1":80.21,"filterRpm_1":84.33,"w1":16700,"rpm2":96.26,"filterRpm_2":92.07,"w2":16700,"rpm3":80.21,"filterRpm_3":76.28,"w3":16700}
14:22:41.997 -> {"millis":2126237,"rpm1":96.25,"filterRpm_1":84.79,"w1":16720,"rpm2":96.25,"filterRpm_2":92.56,"w2":16720,"rpm3":80.21,"filterRpm_3":76.74,"w3":16720}
14:22:41.997 -> {"millis":2126247,"rpm1":80.21,"filterRpm_1":85.20,"w1":16740,"rpm2":96.26,"filterRpm_2":93.00,"w2":16740,"rpm3":80.21,"filterRpm_3":77.15,"w3":16740}
14:22:41.997 -> {"millis":2126257,"rpm1":80.22,"filterRpm_1":84.61,"w1":16760,"rpm2":96.27,"filterRpm_2":93.38,"w2":16760,"rpm3":80.22,"filterRpm_3":77.51,"w3":16760}
14:22:41.997 -> {"millis":2126267,"rpm1":96.26,"filterRpm_1":85.04,"w1":16780,"rpm2":80.21,"filterRpm_2":92.78,"w2":16780,"rpm3":80.21,"filterRpm_3":77.83,"w3":16780}
14:22:41.997 -> {"millis":2126277,"rpm1":80.21,"filterRpm_1":85.42,"w1":16800,"rpm2":96.26,"filterRpm_2":92.24,"w2":16800,"rpm3":80.21,"filterRpm_3":78.11,"w3":16800}
14:22:42.044 -> {"millis":2126287,"rpm1":96.25,"filterRpm_1":85.75,"w1":16820,"rpm2":96.25,"filterRpm_2":92.71,"w2":16820,"rpm3":80.21,"filterRpm_3":78.36,"w3":16820}
14:22:42.044 -> {"millis":2126297,"rpm1":80.22,"filterRpm_1":86.04,"w1":16840,"rpm2":96.27,"filterRpm_2":93.13,"w2":16840,"rpm3":80.22,"filterRpm_3":78.58,"w3":16840}
14:22:42.044 -> {"millis":2126307,"rpm1":96.26,"filterRpm_1":86.30,"w1":16860,"rpm2":96.26,"filterRpm_2":93.50,"w2":16860,"rpm3":80.21,"filterRpm_3":78.77,"w3":16860}
14:22:42.044 -> {"millis":2126317,"rpm1":80.21,"filterRpm_1":86.53,"w1":16880,"rpm2":96.25,"filterRpm_2":93.83,"w2":16880,"rpm3":80.21,"filterRpm_3":78.94,"w3":16880}
14:22:42.044 -> {"millis":2126327,"rpm1":96.27,"filterRpm_1":86.73,"w1":16900,"rpm2":96.27,"filterRpm_2":94.11,"w2":16900,"rpm3":80.22,"filterRpm_3":79.09,"w3":16900}
14:22:42.090 -> {"millis":2126337,"rpm1":80.21,"filterRpm_1":86.91,"w1":16920,"rpm2":96.25,"filterRpm_2":94.37,"w2":16920,"rpm3":80.21,"filterRpm_3":79.23,"w3":16920}
14:22:42.090 -> {"millis":2126347,"rpm1":96.27,"filterRpm_1":87.07,"w1":16940,"rpm2":96.27,"filterRpm_2":94.59,"w2":16940,"rpm3":80.22,"filterRpm_3":79.34,"w3":16940}
14:22:42.090 -> {"millis":2126357,"rpm1":80.21,"filterRpm_1":87.20,"w1":16960,"rpm2":96.25,"filterRpm_2":94.79,"w2":16960,"rpm3":80.21,"filterRpm_3":79.45,"w3":16960}
14:22:42.090 -> {"millis":2126367,"rpm1":96.27,"filterRpm_1":87.33,"w1":16980,"rpm2":96.27,"filterRpm_2":94.96,"w2":16980,"rpm3":80.22,"filterRpm_3":79.54,"w3":16980}
14:22:42.136 -> {"millis":2126377,"rpm1":80.21,"filterRpm_1":87.43,"w1":17000,"rpm2":96.26,"filterRpm_2":95.12,"w2":17000,"rpm3":64.17,"filterRpm_3":78.67,"w3":17000}
14:22:42.136 -> {"millis":2126387,"rpm1":96.26,"filterRpm_1":87.53,"w1":17020,"rpm2":96.26,"filterRpm_2":95.25,"w2":17020,"rpm3":80.21,"filterRpm_3":77.90,"w3":17020}
14:22:42.136 -> {"millis":2126397,"rpm1":80.21,"filterRpm_1":87.61,"w1":17040,"rpm2":96.25,"filterRpm_2":95.37,"w2":17040,"rpm3":80.21,"filterRpm_3":78.18,"w3":17040}
14:22:42.136 -> {"millis":2126407,"rpm1":96.27,"filterRpm_1":87.69,"w1":17060,"rpm2":96.27,"filterRpm_2":95.47,"w2":17060,"rpm3":80.22,"filterRpm_3":78.42,"w3":17060}
14:22:42.136 -> {"millis":2126417,"rpm1":96.26,"filterRpm_1":88.70,"w1":17080,"rpm2":96.26,"filterRpm_2":95.57,"w2":17080,"rpm3":80.21,"filterRpm_3":78.63,"w3":17080}
14:22:42.182 -> {"millis":2126427,"rpm1":80.21,"filterRpm_1":88.65,"w1":17100,"rpm2":96.26,"filterRpm_2":95.65,"w2":17100,"rpm3":80.21,"filterRpm_3":78.82,"w3":17100}
14:22:42.182 -> {"millis":2126437,"rpm1":96.26,"filterRpm_1":88.60,"w1":17120,"rpm2":96.26,"filterRpm_2":95.72,"w2":17120,"rpm3":80.21,"filterRpm_3":78.98,"w3":17120}
14:22:42.182 -> {"millis":2126447,"rpm1":96.26,"filterRpm_1":89.50,"w1":17140,"rpm2":96.26,"filterRpm_2":95.78,"w2":17140,"rpm3":80.21,"filterRpm_3":79.13,"w3":17140}
14:22:42.182 -> {"millis":2126457,"rpm1":80.21,"filterRpm_1":89.35,"w1":17160,"rpm2":96.26,"filterRpm_2":95.84,"w2":17160,"rpm3":80.21,"filterRpm_3":79.26,"w3":17160}
14:22:42.182 -> {"millis":2126467,"rpm1":96.26,"filterRpm_1":89.22,"w1":17180,"rpm2":96.26,"filterRpm_2":95.89,"w2":17180,"rpm3":80.21,"filterRpm_3":79.37,"w3":17180}
14:22:42.228 -> {"millis":2126477,"rpm1":96.26,"filterRpm_1":90.05,"w1":17200,"rpm2":96.26,"filterRpm_2":95.93,"w2":17200,"rpm3":80.21,"filterRpm_3":79.47,"w3":17200}
14:22:42.228 -> {"millis":2126487,"rpm1":96.25,"filterRpm_1":90.79,"w1":17220,"rpm2":112.29,"filterRpm_2":96.92,"w2":17220,"rpm3":80.21,"filterRpm_3":79.56,"w3":17220}
14:22:42.228 -> {"millis":2126497,"rpm1":80.22,"filterRpm_1":90.48,"w1":17240,"rpm2":96.27,"filterRpm_2":97.79,"w2":17240,"rpm3":80.22,"filterRpm_3":79.63,"w3":17240}
14:22:42.228 -> {"millis":2126507,"rpm1":96.26,"filterRpm_1":90.22,"w1":17260,"rpm2":96.26,"filterRpm_2":97.61,"w2":17260,"rpm3":80.21,"filterRpm_3":79.70,"w3":17260}
14:22:42.275 -> {"millis":2126517,"rpm1":96.26,"filterRpm_1":90.93,"w1":17280,"rpm2":96.26,"filterRpm_2":97.45,"w2":17280,"rpm3":80.21,"filterRpm_3":79.76,"w3":17280}
14:22:42.275 -> {"millis":2126527,"rpm1":96.25,"filterRpm_1":91.56,"w1":17300,"rpm2":96.25,"filterRpm_2":97.31,"w2":17300,"rpm3":80.21,"filterRpm_3":79.82,"w3":17300}
14:22:42.275 -> {"millis":2126537,"rpm1":80.22,"filterRpm_1":91.17,"w1":17320,"rpm2":96.27,"filterRpm_2":97.18,"w2":17320,"rpm3":80.22,"filterRpm_3":79.86,"w3":17320}
14:22:42.275 -> {"millis":2126547,"rpm1":96.26,"filterRpm_1":90.82,"w1":17340,"rpm2":96.26,"filterRpm_2":97.07,"w2":17340,"rpm3":80.21,"filterRpm_3":79.91,"w3":17340}
14:22:42.275 -> {"millis":2126557,"rpm1":96.26,"filterRpm_1":91.46,"w1":17360,"rpm2":96.26,"filterRpm_2":96.98,"w2":17360,"rpm3":80.21,"filterRpm_3":79.94,"w3":17360}
14:22:42.321 -> {"millis":2126567,"rpm1":96.26,"filterRpm_1":92.03,"w1":17380,"rpm2":112.30,"filterRpm_2":97.84,"w2":17380,"rpm3":80.21,"filterRpm_3":79.97,"w3":17380}
14:22:42.321 -> {"millis":2126577,"rpm1":96.25,"filterRpm_1":92.53,"w1":17400,"rpm2":96.25,"filterRpm_2":98.60,"w2":17400,"rpm3":80.21,"filterRpm_3":80.00,"w3":17400}
14:22:42.321 -> {"millis":2126587,"rpm1":96.27,"filterRpm_1":92.97,"w1":17420,"rpm2":96.27,"filterRpm_2":98.32,"w2":17420,"rpm3":80.22,"filterRpm_3":80.03,"w3":17420}
14:22:42.321 -> {"millis":2126597,"rpm1":80.21,"filterRpm_1":92.41,"w1":17440,"rpm2":96.26,"filterRpm_2":98.08,"w2":17440,"rpm3":80.21,"filterRpm_3":80.05,"w3":17440}
14:22:42.367 -> {"millis":2126607,"rpm1":96.26,"filterRpm_1":91.92,"w1":17460,"rpm2":96.26,"filterRpm_2":97.86,"w2":17460,"rpm3":80.21,"filterRpm_3":80.07,"w3":17460}
14:22:42.367 -> {"millis":2126617,"rpm1":96.26,"filterRpm_1":92.43,"w1":17480,"rpm2":112.30,"filterRpm_2":98.62,"w2":17480,"rpm3":96.26,"filterRpm_3":81.03,"w3":17480}
14:22:42.367 -> {"millis":2126627,"rpm1":96.25,"filterRpm_1":92.88,"w1":17500,"rpm2":96.25,"filterRpm_2":99.29,"w2":17500,"rpm3":80.21,"filterRpm_3":81.89,"w3":17500}
14:22:42.367 -> {"millis":2126637,"rpm1":96.26,"filterRpm_1":93.28,"w1":17520,"rpm2":96.26,"filterRpm_2":98.93,"w2":17520,"rpm3":80.21,"filterRpm_3":81.69,"w3":17520}
14:22:42.367 -> {"millis":2126647,"rpm1":96.26,"filterRpm_1":93.63,"w1":17540,"rpm2":96.26,"filterRpm_2":98.62,"w2":17540,"rpm3":80.21,"filterRpm_3":81.51,"w3":17540}
14:22:42.413 -> {"millis":2126657,"rpm1":96.27,"filterRpm_1":93.94,"w1":17560,"rpm2":96.27,"filterRpm_2":98.34,"w2":17560,"rpm3":80.22,"filterRpm_3":81.36,"w3":17560}
14:22:42.413 -> {"millis":2126667,"rpm1":96.26,"filterRpm_1":94.22,"w1":17580,"rpm2":112.30,"filterRpm_2":99.04,"w2":17580,"rpm3":80.21,"filterRpm_3":81.22,"w3":17580}
14:22:42.413 -> {"millis":2126677,"rpm1":96.26,"filterRpm_1":94.46,"w1":17600,"rpm2":96.26,"filterRpm_2":99.66,"w2":17600,"rpm3":80.21,"filterRpm_3":81.11,"w3":17600}
14:22:42.413 -> {"millis":2126687,"rpm1":96.26,"filterRpm_1":94.67,"w1":17620,"rpm2":96.26,"filterRpm_2":99.26,"w2":17620,"rpm3":80.21,"filterRpm_3":81.00,"w3":17620}
14:22:42.413 -> {"millis":2126697,"rpm1":96.25,"filterRpm_1":94.86,"w1":17640,"rpm2":96.25,"filterRpm_2":98.90,"w2":17640,"rpm3":96.25,"filterRpm_3":81.85,"w3":17640}
14:22:42.460 -> {"millis":2126707,"rpm1":96.27,"filterRpm_1":95.02,"w1":17660,"rpm2":112.31,"filterRpm_2":99.54,"w2":17660,"rpm3":80.22,"filterRpm_3":82.61,"w3":17660}
14:22:42.460 -> {"millis":2126717,"rpm1":96.26,"filterRpm_1":95.17,"w1":17680,"rpm2":96.26,"filterRpm_2":100.10,"w2":17680,"rpm3":80.21,"filterRpm_3":82.33,"w3":17680}
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
14:22:45.502 -> {"millis":2129780,"rpm1":128.34,"filterRpm_1":131.11,"w1":23690,"rpm2":128.34,"filterRpm_2":136.91,"w2":23690,"rpm3":128.34,"filterRpm_3":124.93,"w3":23690}
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
