dcarve/tg-robot/miscelania/python/old_Datas/results_table.xlsx

millis | rpm1 | filterRpm_1 | w1 | rpm2 | filterRpm_2 | w2 | rpm3 | filterRpm_3 | w3
2117777 | 112.31 | 102 | 20185 | 112.31 | 111.11 | 20185 | 96.27 | 93.54 | 20185
2117787 | 96.26 | 102.27 | 20165 | 112.3 | 111.25 | 20165 | 96.26 | 93.86 | 20165
2117797 | 112.29 | 102.51 | 20145 | 112.29 | 111.38 | 20145 | 112.29 | 95.09 | 20145
2117807 | 112.3 | 103.67 | 20125 | 128.34 | 112.43 | 20125 | 96.26 | 96.18 | 20125
2117817 | 96.27 | 103.74 | 20105 | 112.31 | 113.37 | 20105 | 96.27 | 96.19 | 20105
2117827 | 112.3 | 103.8 | 20085 | 112.3 | 113.24 | 20085 | 96.26 | 96.2 | 20085
2117837 | 96.26 | 103.86 | 20065 | 112.3 | 113.13 | 20065 | 96.26 | 96.21 | 20065
2117847 | 112.29 | 103.91 | 20045 | 112.29 | 113.03 | 20045 | 96.25 | 96.21 | 20045
2117857 | 112.3 | 104.9 | 20025 | 112.3 | 112.94 | 20025 | 96.26 | 96.22 | 20025
2117867 | 96.27 | 104.83 | 20005 | 128.36 | 113.82 | 20005 | 112.31 | 97.17 | 20005
2117877 | 112.29 | 104.76 | 19985 | 112.29 | 114.59 | 19985 | 96.25 | 98.01 | 19985
2117887 | 112.31 | 105.65 | 19965 | 112.31 | 114.32 | 19965 | 96.27 | 97.8 | 19965
2117897 | 96.25 | 105.49 | 19945 | 112.29 | 114.08 | 19945 | 96.25 | 97.62 | 19945
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
