dcarve/tg-robot/(threads)

Thread 1 (2023-08-26):

estudar usart do stm32 com arduino

dcarve, 2023-08-26:
https://stackoverflow.com/questions/73076404/enabling-additional-usarts-for-stm32-in-arduino

dcarve, 2023-08-26:
https://www.youtube.com/watch?v=RPU2wzfewY8

Thread 2 (2023-08-26):

especificações do motor

dcarve, 2023-08-26:
https://pt.aliexpress.com/item/4000761877459.html?gatewayAdapt=glo2bra

dcarve, 2023-08-26:
https://www.amazon.com.mx/Motor-encoder-Pukido-GM25-370-100RPM/dp/B07FRTKDFL?th=1

dcarve, 2023-08-26:
https://www.alibaba.com/product-detail/ChiHai-Motor-CHR-GM25-370ABHL-The_62494834330.html

Thread 5 (2024-01-10):

novo motor

dcarve, 2024-01-10:
Motor de passo 24V para eixos X, Y e E.

Modelo: Motor_42-40_X-axis_Y-axis_E-axis

Compatível com:
Eixo X: CR-10 Max_CR-10S Pro V2_CR-X_CR-X Pro_SV02_CR-200B_CR-200B Pro_Sermoon D3
Eixo Y: CR-10 Smart_CR-10 V2_CR-10 V3_CR-6 SE_Ender-3 Max_CR-200B_Sermoon V1_Sermoon V1 Pro_Ender-3 Max Neo
Eixo E (Extrusora): CR-10 Max_CR-10 Smart_CR-10S Pro V2_CR-30_CR-6 Max_CR-6 SE_CR-X_CR-X Pro_Ender-3 Max_Ender-3 Neo
