dcarve/tg-robot/miscelania/conv_demo.pdf

## Filtered Audio Demo

# Max Kamenetsky

In this demo you'll listen to a 10 second segment of music, alternating with various ltered

versions of it. You should try to relate what you hear to the frequency response, impulse

and step responses, and snapshots of the input and output signals.

## First order lowpass lter

The rst lter is a rst order lowpass with cuto frequency 1kHz, with transfer function

H(s)= | !c s + !c | =
1
1+ s=!c

; where !c =2 1000.

Note that it passes frequencies under around 500Hz or so, but attenuates high frequencies.

Since it attenuates high frequencies the ltered segment will sound a bit mued. (A higher

order lowpass lter, with a sharper cuto characteristic, would sound much more mued.)

The impulse response shows that this lter smooths out the input, giving a sort of averaging

over a few milliseconds. You can see that the ltered signal is a smoothed version of the

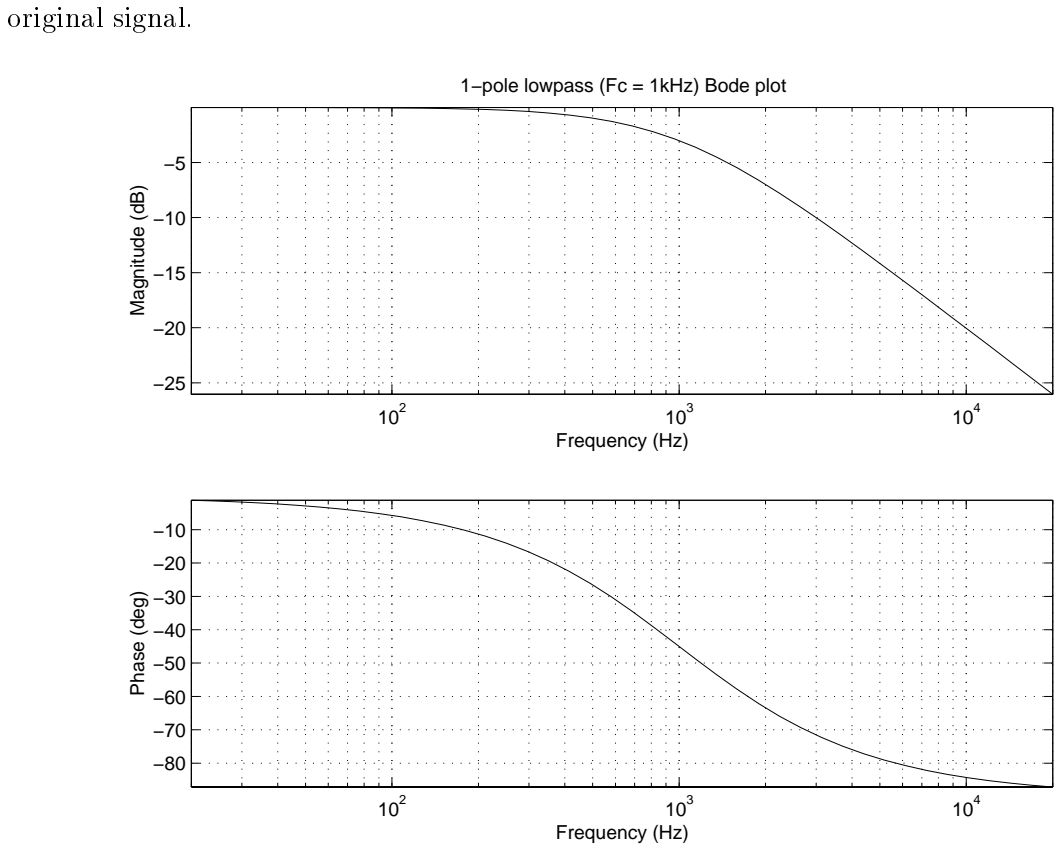
[picture p132: figure]
original signal.; Frequency (Hz); Magnitude (dB); 1−pole lowpass (Fc = 1kHz) Bode plot; Phase (deg)

1000

2000

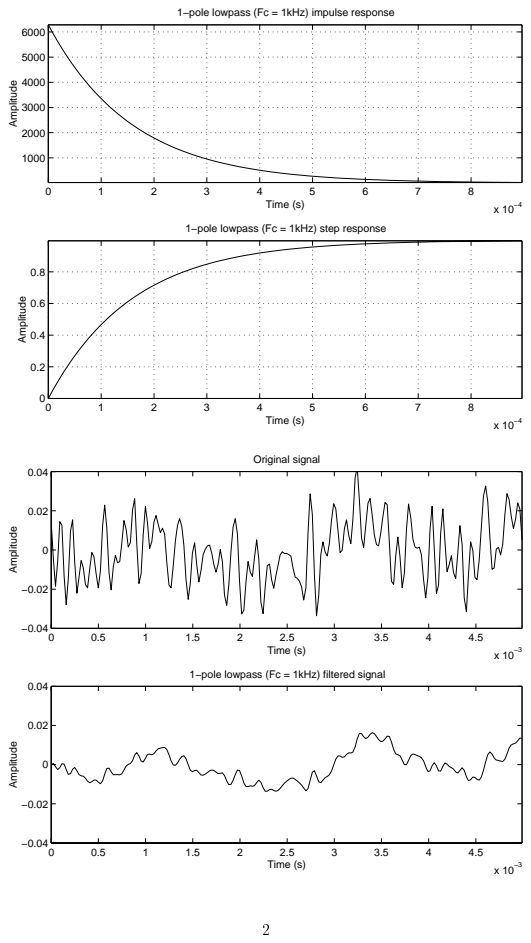
[picture p133: page 2]
Time (s); Amplitude; Original signal

1−pole lowpass (Fc = 1kHz) impulse response

1−pole lowpass (Fc = 1kHz) step response

1−pole lowpass (Fc = 1kHz) filtered signal

## First order highpass lter

The transfer function is
H(s)= | s
s + !c | =

s=!c 1+ s=!c where !c =2 1000.

This transfer function attenuates low frequencies, but lets frequencies above 2kHz or so

pass. You can hear that the bass is quite reduced. You can also see from the signal waveforms

that the fast wiggles in the signal come through, but the slower variations are quite reduced.

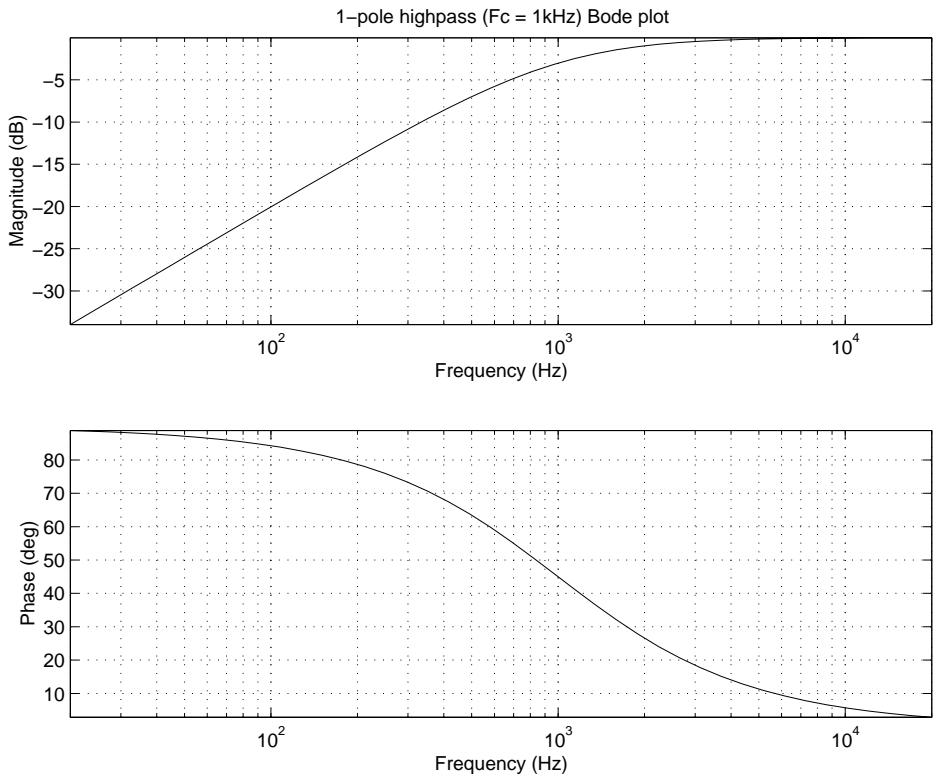
[picture p134: figure]
Frequency (Hz); Magnitude (dB); 1−pole highpass (Fc = 1kHz) Bode plot; Phase (deg)

−6000

−4000

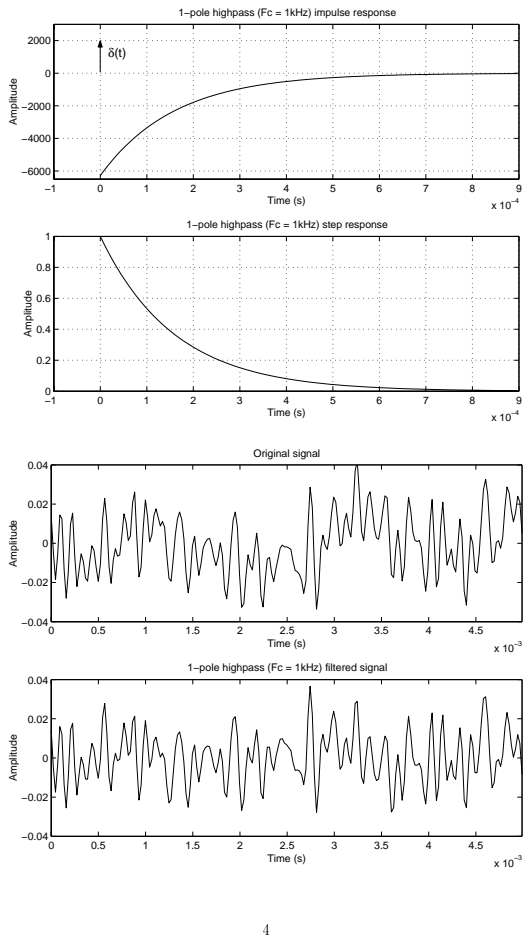
[picture p135: page 4]
Time (s); Amplitude; Original signal

1−pole highpass (Fc = 1kHz) impulse response

1−pole highpass (Fc = 1kHz) step response

1−pole highpass (Fc = 1kHz) filtered signal

## Low Q bandpass lter

This is a second order bandpass lter, with center frequency 1 kHz and Q = 4. Transfer

function:

# H(s)= K

s

(Q=!c)s² + s + Q!c where Q = 4, !c =2 1000, and K =6:7 16:5 dB is a scale factor to increase the volume

level.

Here frequencies between 500Hz and 2kHz or so are passed, and both low and high

frequencies are attenuated. The acoustic eect is something like listening through a tube

(which has resonances | you'll learn about that in EE141!). You can also hear when a note

(or a harmonic) gets near 1kHz.

The impulse response is oscillatory, and you can see the eect in the plot of the ltered

signal. Here both the fast wiggles and the slow undulatations are attentuated.

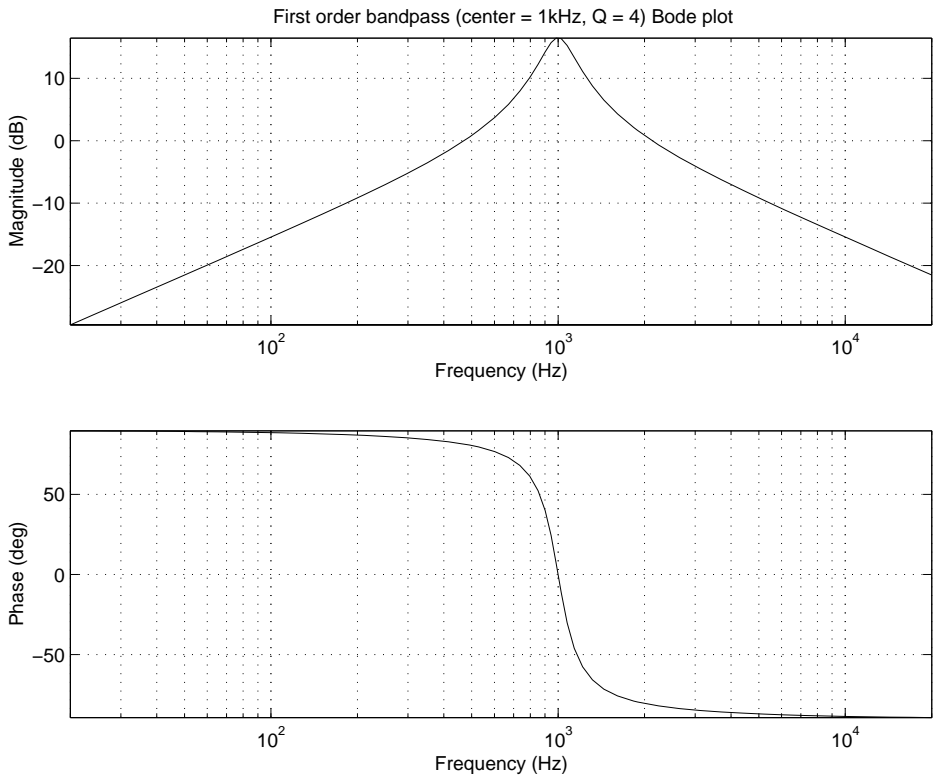
[picture p136: figure]
Frequency (Hz); Magnitude (dB); Phase (deg)

## First order bandpass (center = 1kHz, Q = 4) Bode plot

−5000

0

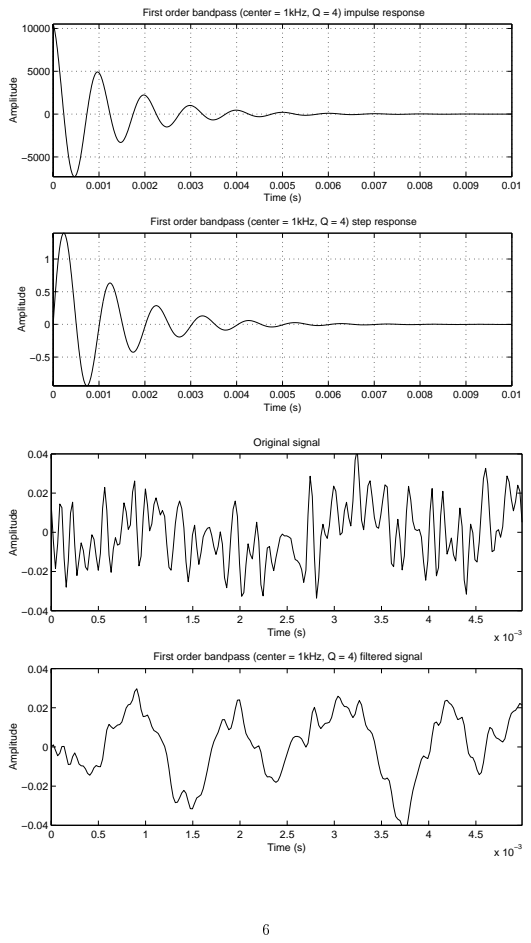
[picture p137: page 6]
Time (s); Amplitude; Original signal

First order bandpass (center = 1kHz, Q = 4) impulse response

First order bandpass (center = 1kHz, Q = 4) step response

First order bandpass (center = 1kHz, Q = 4) filtered signal

# High Q bandpass lter

Second order bandpass lter with center frequency 1kHz and Q = 40. Transfer function:

# H(s)= K

s

(Q=!c)s² + s + Q!c where Q = 40, !c =2 1000, and K = 28 29 dB is a scale factor to increase the volume

level.

Here the frequencies near 1kH are strongly emphasized, which is quite annoying. The

impulse response is quite oscillatory, whichyou can also see in the plots of the ltered signal.

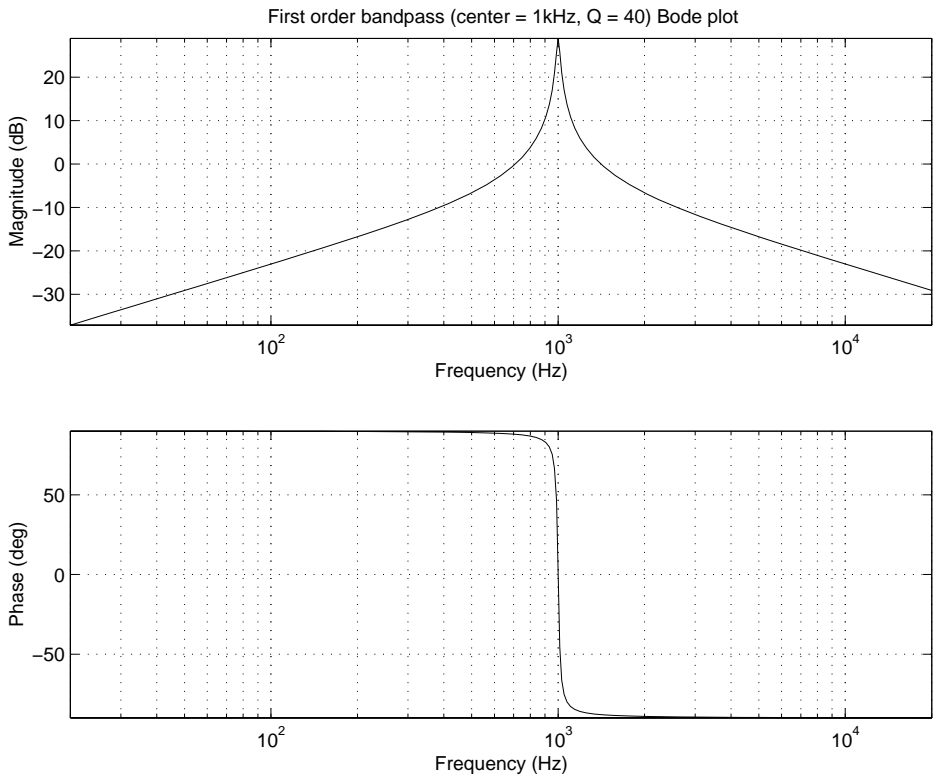
[picture p138: figure]
Frequency (Hz); Magnitude (dB); Phase (deg)

## First order bandpass (center = 1kHz, Q = 40) Bode plot

−4000

−2000

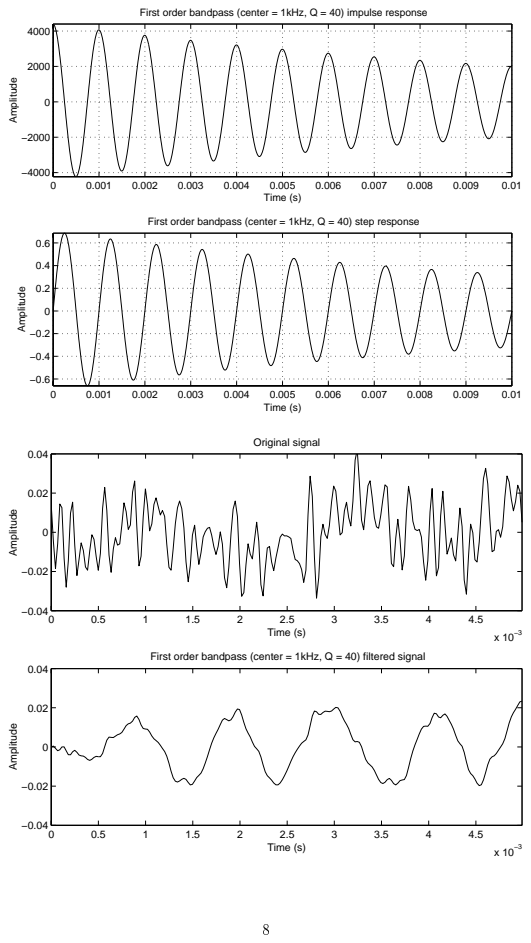
[picture p139: page 8]
Time (s); Amplitude; Original signal

First order bandpass (center = 1kHz, Q = 40) impulse response

First order bandpass (center = 1kHz, Q = 40) step response

First order bandpass (center = 1kHz, Q = 40) filtered signal

# Allpass lter

First order allpass lter with 90 | phase shift at 1kHz. Transfer function:
H(s)= s !c s + !c | =

s=!c 1
s=!c +1

; where !c =2 1000.

This lter passes all frequencies with unity gain. It does, however, shift the phase of the

signal.

You really can't hear any dierence at all, since the ear is pretty insensitive to (moderate)

phase shift. The ltered signal looks quite a bit like the original signal, but is not the same.

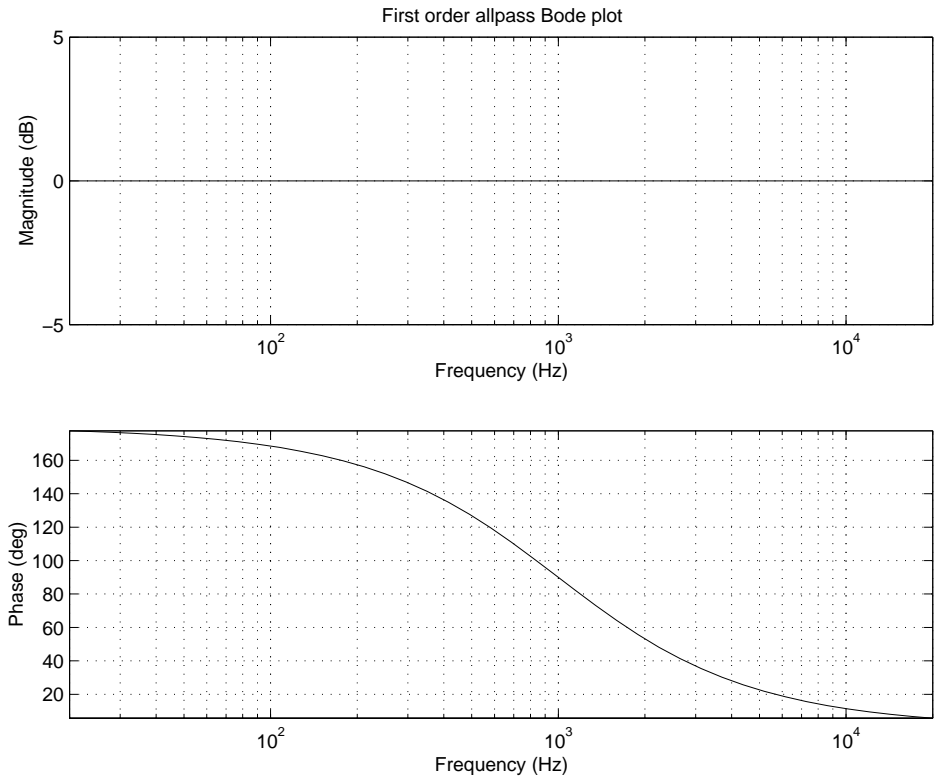
[picture p140: figure]
Frequency (Hz); Magnitude (dB); First order allpass Bode plot; Phase (deg)

−12000

−10000

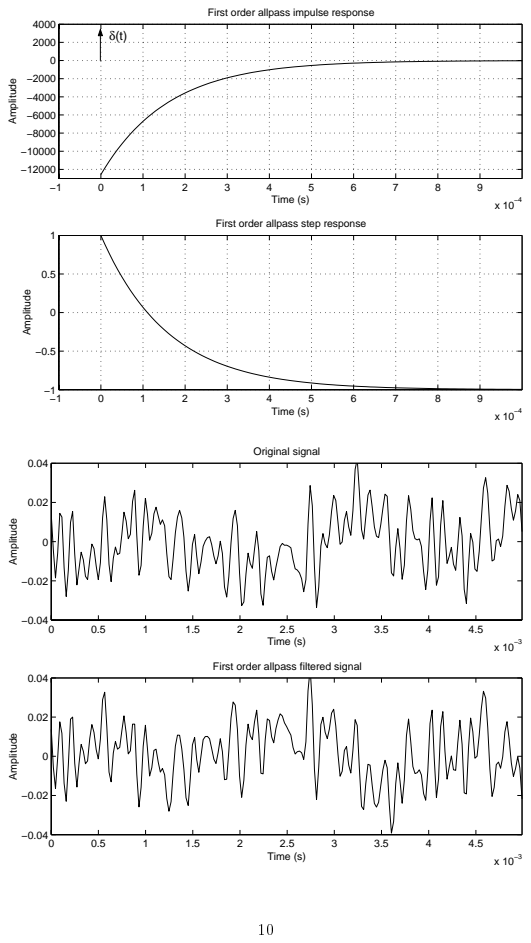
[picture p141: page 10]
Time (s); Amplitude; Original signal

First order allpass impulse response

First order allpass step response

First order allpass filtered signal

## Moving average lter

This lter is a 10ms moving average lter. Impulse response:

# h(t)= ( K(1=0:1); 0 t< 0:01

0; t 0:01

The DC gain is K, which we take to be K =3:5 10:9dB to increase the volume level.

In this case the ltered signal output is exactly (K times the) average of the input signal

over the last 10ms. Here the ltered signal sounds very mued; the high frequencies are

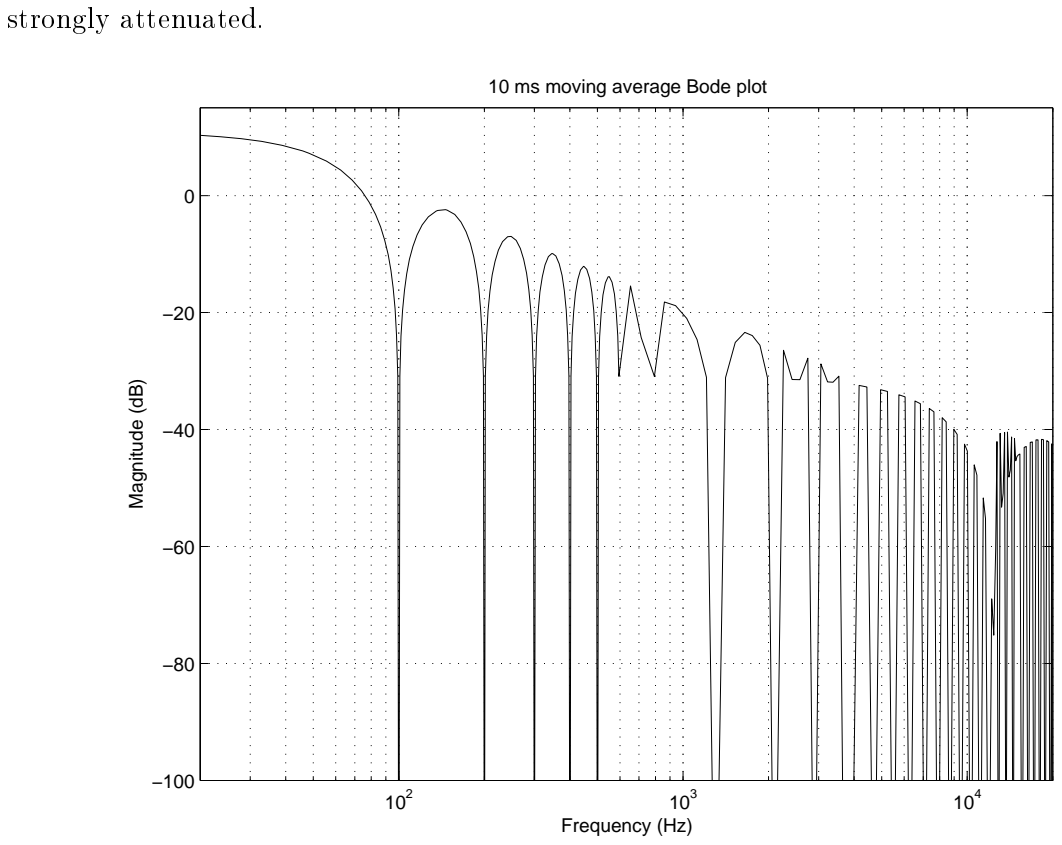
[picture p142: figure]
strongly attenuated.; Frequency (Hz); Magnitude (dB); 10 ms moving average Bode plot

−2

0

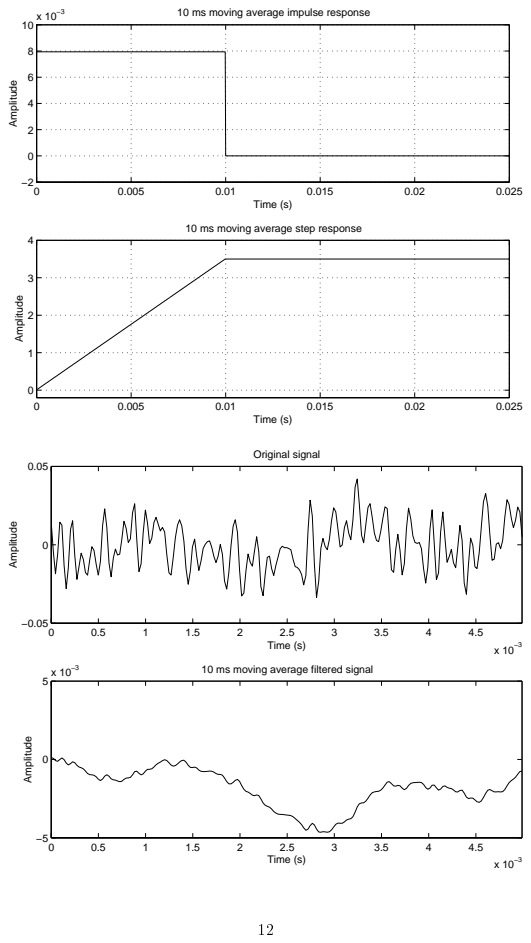
[picture p143: page 12]
Time (s); Amplitude; Original signal

10 ms moving average impulse response

10 ms moving average step response

10 ms moving average filtered signal

## Filter with echos

h(t) = (t)+0:75(t 0:125) 0:1065(t 0:1536) 0:4098(t 0:1605) + 0:0308(t 0:1788) + 0:0705(t 0:1934) 0:2804(t 0:2201) + 0:2906(t 0:243) + 0:2898(t 0:2567)

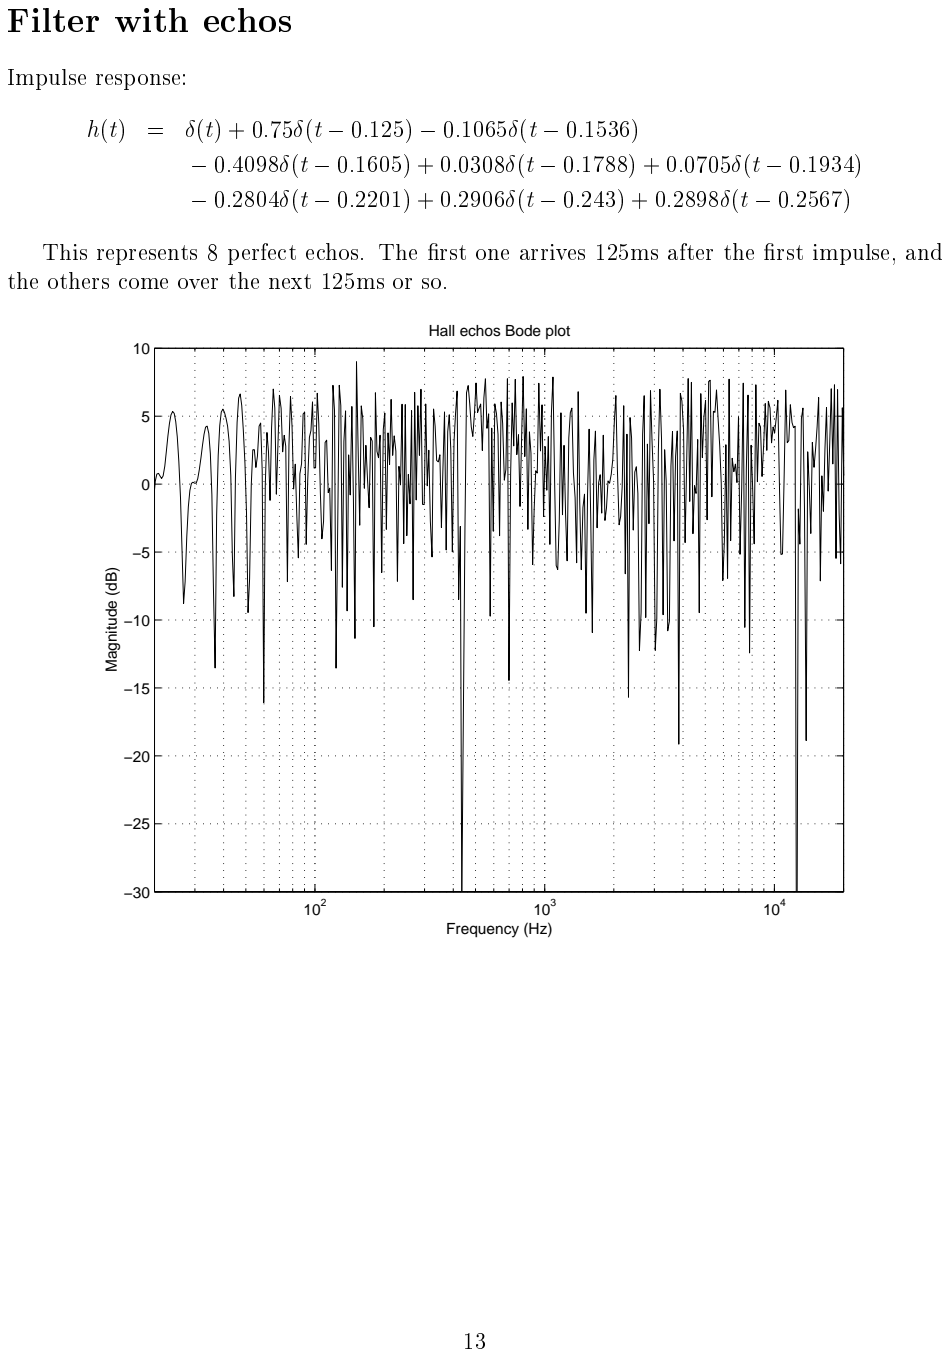
[picture p144: page 13]
Impulse response:; Frequency (Hz); Magnitude (dB)

This represents 8 perfect echos. The rst one arrives 125ms after the rst impulse, and

the others come over the next 125ms or so.

Hall echos Bode plot

−0.5

0

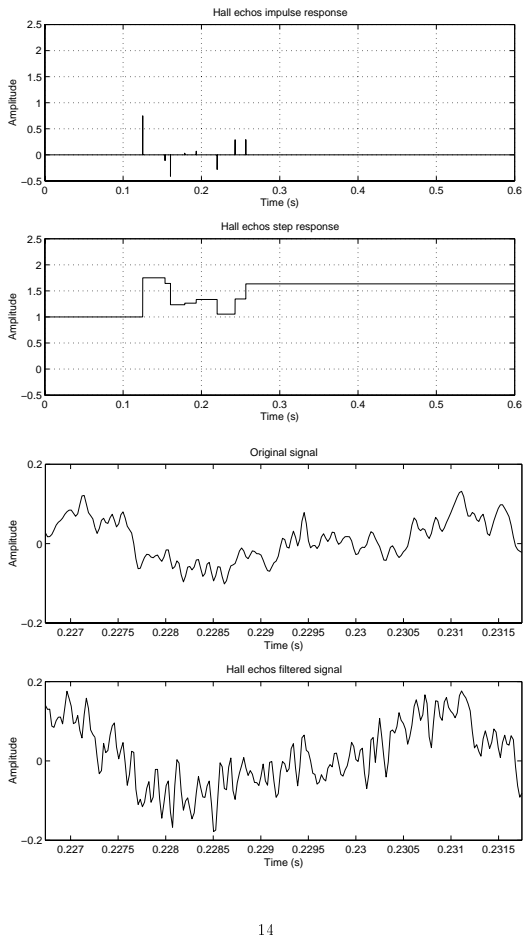
[picture p145: page 14]
Time (s); Amplitude; Original signal

Hall echos impulse response

Hall echos step response

Hall echos filtered signal
