dcarve/tg-robot/miscelania/DRV8825-DRV8825.pdf

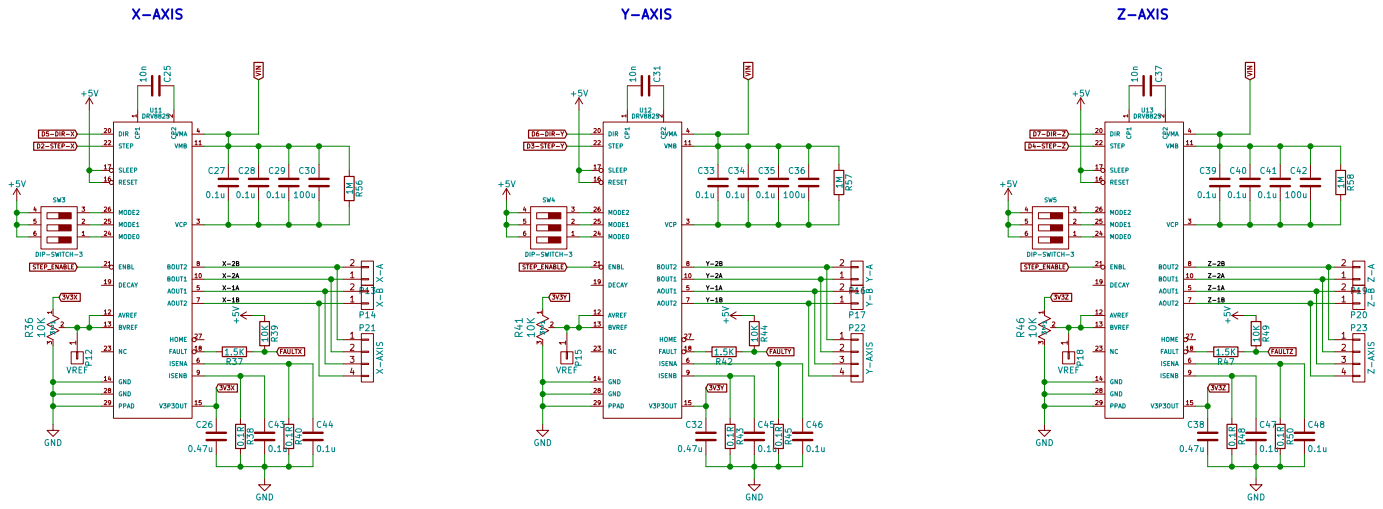
[picture p146: page 1]
