dcarve/tg-robot/arduino_workspace/TG_v2/runMotors.h

#ifndef RUNMOTORS_H
#define RUNMOTORS_H
#include <Arduino.h>


void stepResolution(int stepResolution);

/* 
void convertRpmToDelays(
    int *w1_delay,
    int *w2_delay,
    int *w3_delay,
    float w1,
    float w2,
    float w3,
    int stepResolution
);
 */

void SetMotorSleep(int motor, byte value);
void SetMotorReset(int motor, byte value);

#endif
