dcarve/tg-robot/arduino_workspace/TG_v2/serial.cpp

#include <Arduino.h>
#include "serial.h"
#include "pinOutIn.h"
#include <HardwareSerial.h>
#include <libmaple/usart.h>
#include "encoders.h"

void setUpSerialMonitor(){
    Serial.begin(9600);
}
void setUpSerialUsart3(){
    Serial3.begin(9600);
}
