dcarve/tg-robot/(commit log)

2022-03-05 calculo de simulacao terminado
2022-03-05 add diagram autocad
    [robo_3_wheel.dwg]
2022-03-21 simulação basica de movimendo finalizada
2022-04-12 add more items
    [robo_3_wheel.dwg]
2022-04-12 update model diagram
    [robo_3_wheel.dwg]
2022-05-04 add atollic section, and finish motor dc section
2022-12-23 criação projeto arduino
2022-12-24 obteção da velocidade em rpm do motor
    [monitor.csv]
2022-12-24 ajuste formatação e remoção de var não usada
2022-12-30 add código python para analisar o espectro da freq
    [data_readed.csv]
2022-12-30 add filter
2023-06-24 add cad
    [Drawing1.dwg, L298N.SLDASM, L298N.x_t, Pcb.SLDPRT, Pengunci 2.SLDPRT, Pengunci.SLDPRT, chassi_inferior.SLDPRT, montagem.SLDASM]
2023-08-19 add cad files
    [CE3S1PRO_chassi_inferiror_2.3mf, CE3S1PRO_chassi_inferiror_3.3mf, Drawing1.dwg, Peça1.SLDPRT, base_protoboard.3MF, base_protoboard.SLDPRT, chassi_inferiror_2.3MF, chassi_inferiror_2.SLDPRT]
2023-08-25 create new project, add 3 motors
    [signal copy.csv, signal.csv, suporte.3MF]
2023-08-29 fix calc tg, add calc transformation matrix in stm32 code
    [calcs.py]
2023-09-18 testes com frequencia de medição e de filtro
2023-11-12 ultimas adções
    [Pasta1.xlsx, amostra_invertida.csv, results_table.csv, results_table.xlsx]
2023-11-13 add controle de velocidade
2023-11-18 add fabricacao
    [chassi_inferiror_2.3MF]
2023-11-27 movendo refencia do CAD para o desenvolvimento, e add mais detalhes sobre a conexão dos componentes
2023-12-01 Improvements on the DC motor bibliography review section.
2023-12-01 Improvements on the STM32 section.
2023-12-08 adição do trecho sobre implementação da leitura de velocidade
2024-08-11 lot of stuff
    [Bosch_12V_Charger_Holder1.SLDPRT, CE3S1PRO_roda_acomplamento.3mf, CE3S1PRO_suporte_chassi.3mf, Peça1.SLDPRT, acoplamento.dwg, analise_encaixe.3MF, analise_encaixe.SLDPRT, chassi_2.3MF]
2024-08-17 create new teste
    [planejamento_pinos - Copia.xlsx, planejamento_pinos.xlsx]
2024-08-19 add millis
2024-08-19 changes before uart
2024-08-21 add serial uart
2024-08-21 fix baud rate serial3
    [TG_v2.ino, serial.cpp]
2024-08-29 ajustes de percentual de velocidade
2024-08-30 add the other step motors
2024-10-14 seção de microntrolador e IDE concluidos
2024-10-14 movimentando arquivos
    [Bosch_12V_Charger_Holder1.SLDPRT, CE3S1PRO_roda_acomplamento.3mf, CE3S1PRO_suporte_chassi.3mf, L298N.SLDASM, L298N.x_t, Pasta1.xlsx, Pcb.SLDPRT, Peça1.SLDPRT]
2024-10-15 add seção de roda omni direcional
2024-10-17 mudança de posição algumas subseções
